garrettsworkshop/GW4302/Documentation/Architecture/BusGlue.png

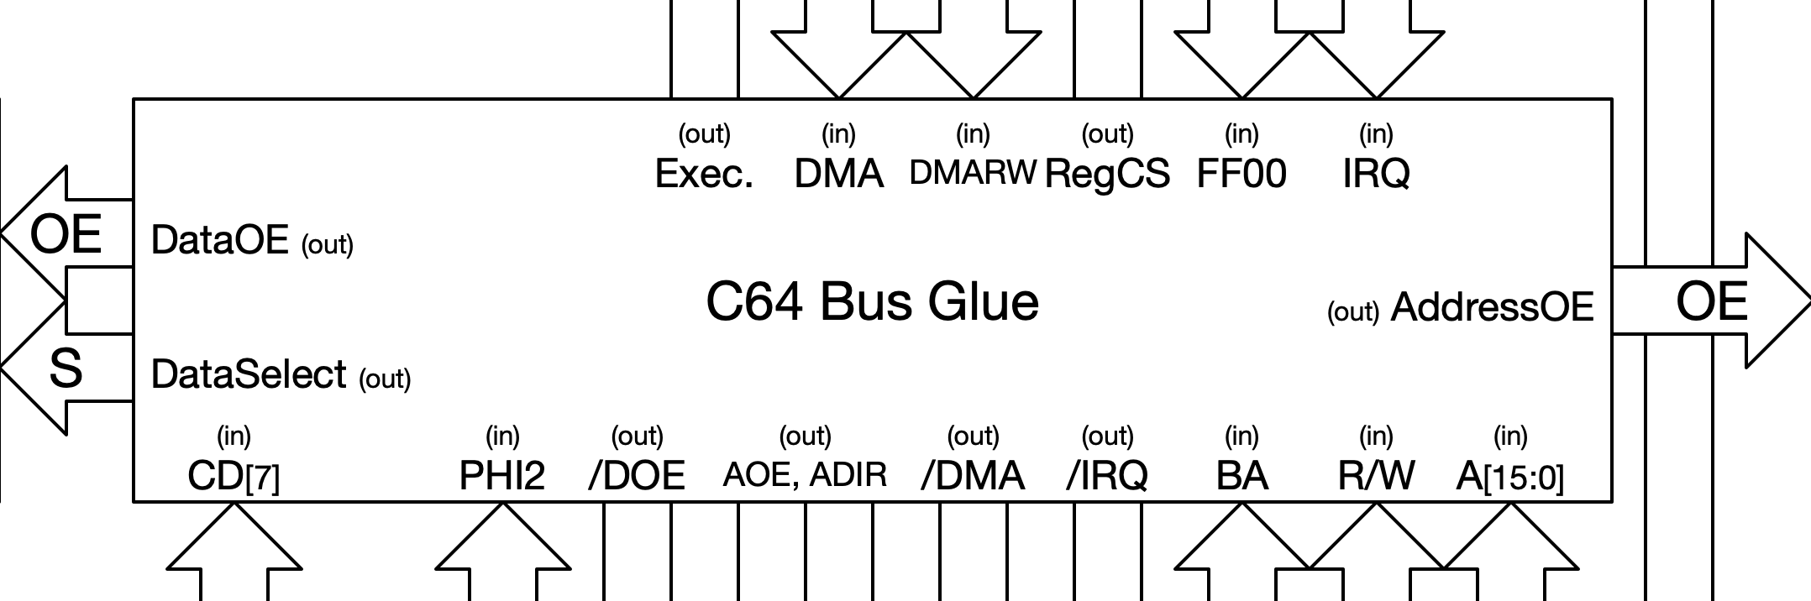
Documentation/Architecture/BusGlue.png
