garrettsworkshop/GW4302/Documentation/GW4302A-Placement.pdf

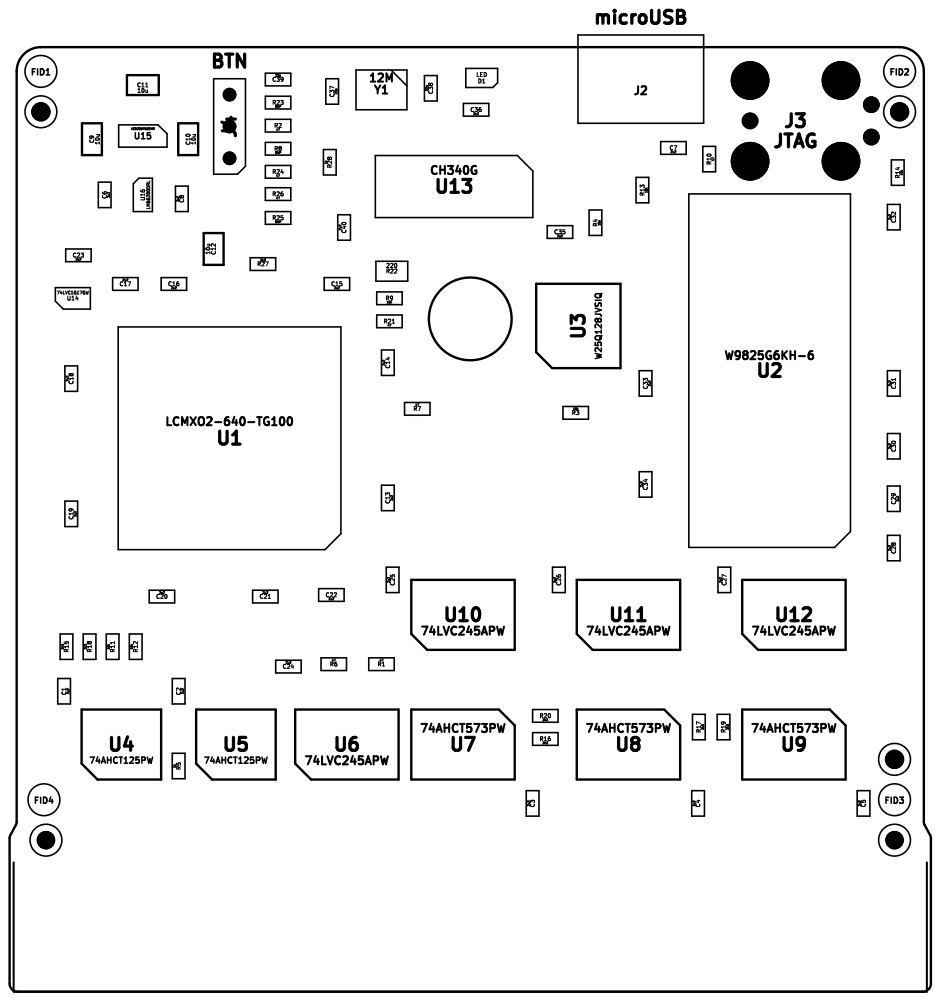
[picture p8: page 1]
