garrettsworkshop/GW4302/GW4302.kicad_pcb

## KiCad design GW4302.kicad_pcb (2025-01-10)

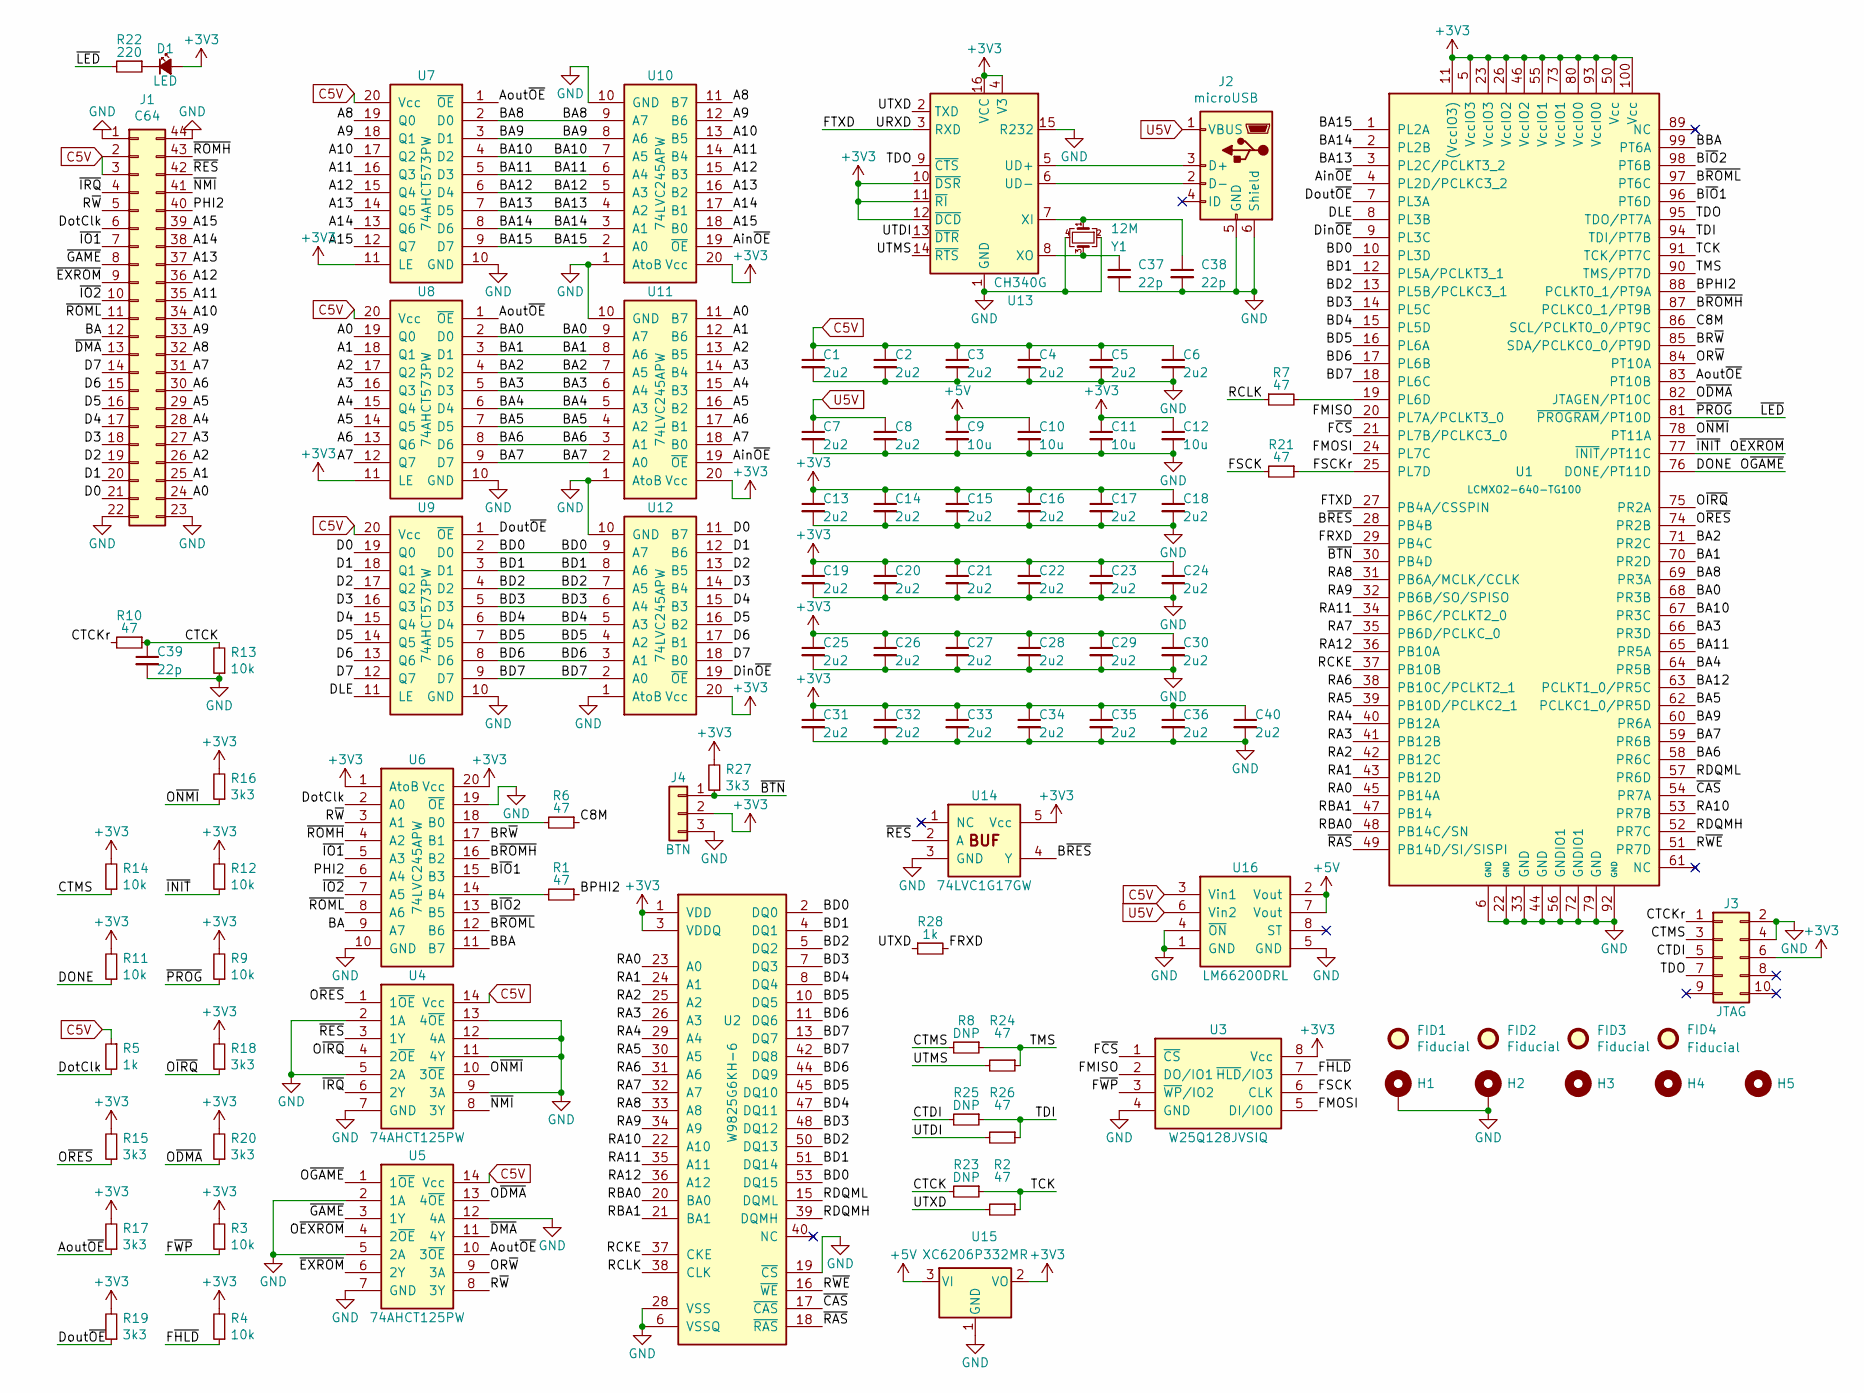
[picture p9: schematic GW4302.kicad_sch, GW4302A]

Parts:
C1, C2, C3, C4, C5, C6, C7, C8, C13, C14, C15, C16, C17, C18, C19, C20, C21, C22, C23, C24, C25, C26, C27, C28, C29, C30, C31, C32, C33, C34, C35, C36, C40: 2u2; C_0603; LCSC Part C23630
C9, C10, C11, C12: 10u; C_0805; LCSC Part C15850
C37, C38, C39: 22p; C_0603; LCSC Part C1653
D1: LED; LED_0805; LCSC Part C284932
FID1, FID2, FID3, FID4: Fiducial
H1, H2: PasteHole_1.1mm_PTH
H3, H4, H5: PasteHole_1.152mm_NPTH
J1: C64; AppleIIgsMemoryExpansion_Edge
J2: microUSB; USB_Micro-B_Amphenol_10118192-0001; LCSC Part C132564
J3: JTAG; Tag-Connect_TC2050-IDC-FP_2x05_P1.27mm_Vertical
J4: BTN; PinHeader_1x03_P2.00mm_Vertical
R1, R2, R6, R7, R10, R21, R24, R26: 47; R_0603; LCSC Part C23182
R3, R4, R9, R11, R12, R13, R14: 10k; R_0603; LCSC Part C25804
R5, R28: 1k; R_0603; LCSC Part C21190
R8, R23, R25: DNP; R_0603
R15, R16, R17, R18, R19, R20, R27: 3k3; R_0603; LCSC Part C22978
R22: 220; R_0805; LCSC Part C17557
U1: LCMXO2-640-TG100; TQFP-100_14x14mm_P0.5mm; LCSC Part C1521611
U2: W9825G6KH-6; TSOP-II-54_22.2x10.16mm_P0.8mm; LCSC Part C62246
U3: W25Q128JVSIQ; SOIC-8_5.3mm; LCSC Part C97521
U4, U5: 74AHCT125PW; TSSOP-14_4.4x5mm_P0.65mm; LCSC Part C36365
U6, U10, U11, U12: 74LVC245APW; TSSOP-20_4.4x6.5mm_P0.65mm; LCSC Part C7848
U7, U8, U9: 74AHCT573PW; TSSOP-20_4.4x6.5mm_P0.65mm; LCSC Part C141311
U13: CH340G; SOIC-16_3.9mm; LCSC Part C14267
U14: 74LVC1G17GW; SOT-353; LCSC Part C426705
U15: XC6206P332MR; SOT-23; LCSC Part C5446
U16: LM66200DRL; SOT-583; LCSC Part C3235556
Y1: 12M; Crystal_SMD_3225-4Pin_3.2x2.5mm; LCSC Part C9002

Connections:
+3V3: C11.1, C12.1, C13.1, C14.1, C15.1, C16.1, C17.1, C18.1, C19.1, C20.1, C21.1, C22.1, C23.1, C24.1, C25.1, C26.1, C27.1, C28.1, C29.1, C30.1, C31.1, C32.1, C33.1, C34.1, C35.1, C36.1, C40.1, D1.2 (A), J3.6, J4.2, R3.2, R4.2, R9.2, R11.2, R12.2, R14.2, R15.2, R16.2, R17.2, R18.2, R19.2, R20.2, R27.2, U1.5 (VccIO3), U1.11 ((VccIO3)), U1.23 (VccIO3), U1.26 (VccIO2), U1.46 (VccIO2), U1.50 (Vcc), U1.55 (VccIO1), U1.73 (VccIO1), U1.80 (VccIO0), U1.93 (VccIO0), U1.100 (Vcc), U2.1 (VDD), U2.3 (VDDQ), U2.9 (VDDQ), U2.14 (VDD), U2.27 (VDD), U2.43 (VDDQ), U2.49 (VDDQ), U3.8 (Vcc), U6.1 (AtoB), U6.20 (Vcc), U7.11 (LE), U8.11 (LE), U10.20 (Vcc), U11.20 (Vcc), U12.20 (Vcc), U13.4 (V3), U13.10 (~DSR), U13.11 (~RI), U13.12 (~DCD), U13.16 (VCC), U14.5 (Vcc), U15.2 (VO)
+5V: C9.1, C10.1, U15.3 (VI), U16.2 (Vout), U16.7 (Vout)
/A0: J1.24, U8.19 (Q0), U11.11 (B7)
/A1: J1.25, U8.18 (Q1), U11.12 (B6)
/A2: J1.26, U8.17 (Q2), U11.13 (B5)
/A3: J1.27, U8.16 (Q3), U11.14 (B4)
/A4: J1.28, U8.15 (Q4), U11.15 (B3)
/A5: J1.29, U8.14 (Q5), U11.16 (B2)
/A6: J1.30, U8.13 (Q6), U11.17 (B1)
/A7: J1.31, U8.12 (Q7), U11.18 (B0)
/A8: J1.32, U7.19 (Q0), U10.11 (B7)
/A9: J1.33, U7.18 (Q1), U10.12 (B6)
/A10: J1.34, U7.17 (Q2), U10.13 (B5)
/A11: J1.35, U7.16 (Q3), U10.14 (B4)
/A12: J1.36, U7.15 (Q4), U10.15 (B3)
/A13: J1.37, U7.14 (Q5), U10.16 (B2)
/A14: J1.38, U7.13 (Q6), U10.17 (B1)
/A15: J1.39, U7.12 (Q7), U10.18 (B0)
/Ain~OE: U1.4 (PL2D/PCLKC3_2), U10.19 (~OE), U11.19 (~OE)
/Aout~OE: R17.1, U1.83 (PT10B), U5.10 (3~OE), U7.1 (~OE), U8.1 (~OE)
/BA: J1.12, U6.9 (A7)
/BA0: U1.68 (PR3B), U8.2 (D0), U11.9 (A7)
/BA1: U1.70 (PR2D), U8.3 (D1), U11.8 (A6)
/BA2: U1.71 (PR2C), U8.4 (D2), U11.7 (A5)
/BA3: U1.66 (PR3D), U8.5 (D3), U11.6 (A4)
/BA4: U1.64 (PR5B), U8.6 (D4), U11.5 (A3)
/BA5: U1.62 (PCLKC1_0/PR5D), U8.7 (D5), U11.4 (A2)
/BA6: U1.58 (PR6C), U8.8 (D6), U11.3 (A1)
/BA7: U1.59 (PR6B), U8.9 (D7), U11.2 (A0)
/BA8: U1.69 (PR3A), U7.2 (D0), U10.9 (A7)
/BA9: U1.60 (PR6A), U7.3 (D1), U10.8 (A6)
/BA10: U1.67 (PR3C), U7.4 (D2), U10.7 (A5)
/BA11: U1.65 (PR5A), U7.5 (D3), U10.6 (A4)
/BA12: U1.63 (PCLKT1_0/PR5C), U7.6 (D4), U10.5 (A3)
/BA13: U1.3 (PL2C/PCLKT3_2), U7.7 (D5), U10.4 (A2)
/BA14: U1.2 (PL2B), U7.8 (D6), U10.3 (A1)
/BA15: U1.1 (PL2A), U7.9 (D7), U10.2 (A0)
/BBA: U1.99 (PT6A), U6.11 (B7)
/BD0: U1.10 (PL3D), U2.2 (DQ0), U2.53 (DQ15), U9.2 (D0), U12.9 (A7)
/BD1: U1.12 (PL5A/PCLKT3_1), U2.4 (DQ1), U2.51 (DQ14), U9.3 (D1), U12.8 (A6)
/BD2: U1.13 (PL5B/PCLKC3_1), U2.5 (DQ2), U2.50 (DQ13), U9.4 (D2), U12.7 (A5)
/BD3: U1.14 (PL5C), U2.7 (DQ3), U2.48 (DQ12), U9.5 (D3), U12.6 (A4)
/BD4: U1.15 (PL5D), U2.8 (DQ4), U2.47 (DQ11), U9.6 (D4), U12.5 (A3)
/BD5: U1.16 (PL6A), U2.10 (DQ5), U2.45 (DQ10), U9.7 (D5), U12.4 (A2)
/BD6: U1.17 (PL6B), U2.11 (DQ6), U2.44 (DQ9), U9.8 (D6), U12.3 (A1)
/BD7: U1.18 (PL6C), U2.13 (DQ7), U2.42 (DQ8), U9.9 (D7), U12.2 (A0)
/BPHI2: R1.1, U1.88 (PCLKT0_1/PT9A)
/BR~W: U1.85 (SDA/PCLKC0_0/PT9D), U6.17 (B1)
/B~IO1: U1.96 (PT6D), U6.15 (B3)
/B~IO2: U1.98 (PT6B), U6.13 (B5)
/B~RES: U1.28 (PB4B), U14.4 (Y)
/B~ROMH: U1.87 (PCLKC0_1/PT9B), U6.16 (B2)
/B~ROML: U1.97 (PT6C), U6.12 (B6)
/C8M: R6.1, U1.86 (SCL/PCLKT0_0/PT9C)
/CTCK: C39.1, R10.1, R13.2, R23.2
/CTCKr: J3.1, R10.2
/CTDI: J3.5, R25.2
/CTMS: J3.3, R8.2, R14.1
/D0: J1.21, U9.19 (Q0), U12.11 (B7)
/D1: J1.20, U9.18 (Q1), U12.12 (B6)
/D2: J1.19, U9.17 (Q2), U12.13 (B5)
/D3: J1.18, U9.16 (Q3), U12.14 (B4)
/D4: J1.17, U9.15 (Q4), U12.15 (B3)
/D5: J1.16, U9.14 (Q5), U12.16 (B2)
/D6: J1.15, U9.13 (Q6), U12.17 (B1)
/D7: J1.14, U9.12 (Q7), U12.18 (B0)
/DLE: U1.8 (PL3B), U9.11 (LE)
/DONE: R11.1, U1.76 (DONE/PT11D), U5.1 (1~OE)
/Din~OE: U1.9 (PL3C), U12.19 (~OE)
/DotClk: J1.6, R5.2, U6.2 (A0)
/Dout~OE: R19.1, U1.7 (PL3A), U9.1 (~OE)
/FMISO: U1.20 (PL7A/PCLKT3_0), U3.2 (DO/IO1)
/FMOSI: U1.24 (PL7C), U3.5 (DI/IO0)
/FRXD: R28.2, U1.29 (PB4C)
/FSCK: R21.2, U3.6 (CLK)
/FSCKr: R21.1, U1.25 (PL7D)
/FTXD: U1.27 (PB4A/CSSPIN), U13.3 (RXD)
/F~CS: U1.21 (PL7B/PCLKC3_0), U3.1 (~CS)
/F~HLD: R4.1, U3.7 (~HLD/IO3)
/F~WP: R3.1, U3.3 (~WP/IO2)
/OR~W: U1.84 (PT10A), U5.9 (3A)
/O~DMA: R20.1, U1.82 (JTAGEN/PT10C), U5.13 (4~OE)
/O~EXROM: R12.1, U1.77 (~INIT/PT11C), U5.4 (2~OE)
/O~IRQ: R18.1, U1.75 (PR2A), U4.4 (2~OE)
/O~NMI: R16.1, U1.78 (PT11A), U4.10 (3~OE)
/O~RES: R15.1, U1.74 (PR2B), U4.1 (1~OE)
/PHI2: J1.40, U6.6 (A4)
/RA0: U1.45 (PB14A), U2.23 (A0)
/RA1: U1.43 (PB12D), U2.24 (A1)
/RA2: U1.42 (PB12C), U2.25 (A2)
/RA3: U1.41 (PB12B), U2.26 (A3)
/RA4: U1.40 (PB12A), U2.29 (A4)
/RA5: U1.39 (PB10D/PCLKC2_1), U2.30 (A5)
/RA6: U1.38 (PB10C/PCLKT2_1), U2.31 (A6)
/RA7: U1.35 (PB6D/PCLKC_0), U2.32 (A7)
/RA8: U1.31 (PB6A/MCLK/CCLK), U2.33 (A8)
/RA9: U1.32 (PB6B/SO/SPISO), U2.34 (A9)
/RA10: U1.53 (PR7B), U2.22 (A10)
/RA11: U1.34 (PB6C/PCLKT2_0), U2.35 (A11)
/RA12: U1.36 (PB10A), U2.36 (A12)
/RBA0: U1.48 (PB14C/SN), U2.20 (BA0)
/RBA1: U1.47 (PB14), U2.21 (BA1)
/RCKE: U1.37 (PB10B), U2.37 (CKE)
/RCLK: R7.1, U2.38 (CLK)
/RDQMH: U1.52 (PR7C), U2.39 (DQMH)
/RDQML: U1.57 (PR6D), U2.15 (DQML)
/R~WE: U1.51 (PR7D), U2.16 (~WE)
/R~W: J1.5, U5.8 (3Y), U6.3 (A1)
/TCK: R2.1, R23.1, U1.91 (TCK/PT7C)
/TDI: R25.1, R26.1, U1.94 (TDI/PT7B)
/TDO: J3.7, U1.95 (TDO/PT7A), U13.9 (~CTS)
/TMS: R8.1, R24.1, U1.90 (TMS/PT7D)
/UTDI: R26.2, U13.13 (~DTR)
/UTMS: R24.2, U13.14 (~RTS)
/UTXD: R2.2, R28.1, U13.2 (TXD)
/~BTN: J4.1, R27.1, U1.30 (PB4D)
/~CAS: U1.54 (PR7A), U2.17 (~CAS)
/~DMA: J1.13, U5.11 (4Y)
/~EXROM: J1.9, U5.6 (2Y)
/~GAME: J1.8, U5.3 (1Y)
/~IO1: J1.7, U6.5 (A3)
/~IO2: J1.10, U6.7 (A5)
/~IRQ: J1.4, U4.6 (2Y)
/~LED: R9.1, R22.2, U1.81 (~PROGRAM/PT10D)
/~NMI: J1.41, U4.8 (3Y)
/~RAS: U1.49 (PB14D/SI/SISPI), U2.18 (~RAS)
/~RES: J1.42, U4.3 (1Y), U14.2 (A)
/~ROMH: J1.43, U6.4 (A2)
/~ROML: J1.11, U6.8 (A6)
C5V: C1.1, C2.1, C3.1, C4.1, C5.1, C6.1, J1.2, J1.3, R5.1, U4.14 (Vcc), U5.14 (Vcc), U7.20 (Vcc), U8.20 (Vcc), U9.20 (Vcc), U16.3 (Vin1)
GND: C1.2, C2.2, C3.2, C4.2, C5.2, C6.2, C7.2, C8.2, C9.2, C10.2, C11.2, C12.2, C13.2, C14.2, C15.2, C16.2, C17.2, C18.2, C19.2, C20.2, C21.2, C22.2, C23.2, C24.2, C25.2, C26.2, C27.2, C28.2, C29.2, C30.2, C31.2, C32.2, C33.2, C34.2, C35.2, C36.2, C37.2, C38.2, C39.2, C40.2, H1.1, H2.1, J1.1, J1.22, J1.23, J1.44, J2.5 (GND), J2.6 (Shield), J3.2, J3.4, J4.3, R13.1, U1.6 (GND), U1.22 (GND), U1.33 (GND), U1.44 (GND), U1.56 (GNDIO1), U1.72 (GNDIO1), U1.79 (GND), U1.92 (GND), U2.6 (VSSQ), U2.12 (VSSQ), U2.19 (~CS), U2.28 (VSS), U2.41 (VSS), U2.46 (VSSQ), U2.52 (VSSQ), U2.54 (VSS), U3.4 (GND), U4.2 (1A), U4.5 (2A), U4.7 (GND), U4.9 (3A), U4.11 (4Y), U4.12 (4A), U4.13 (4~OE), U5.2 (1A), U5.5 (2A), U5.7 (GND), U5.12 (4A), U6.10 (GND), U6.19 (~OE), U7.10 (GND), U8.10 (GND), U9.10 (GND), U10.1 (AtoB), U10.10 (GND), U11.1 (AtoB), U11.10 (GND), U12.1 (AtoB), U12.10 (GND), U13.1 (GND), U13.15 (R232), U14.3 (GND), U15.1 (GND), U16.1 (GND), U16.4 (~ON), U16.5 (GND), Y1.2, Y1.4
unnamed: D1.1 (K), R22.1
unnamed: J2.3 (D+), U13.5 (UD+)
unnamed: J2.2 (D-), U13.6 (UD-)
unnamed: R7.2, U1.19 (PL6D)
unnamed: R6.2, U6.18 (B0)
unnamed: R1.2, U6.14 (B4)
unnamed: C38.1, U13.7 (XI), Y1.1
unnamed: C37.1, U13.8 (XO), Y1.3
U5V: C7.1, C8.1, J2.1 (VBUS), U16.6 (Vin2)

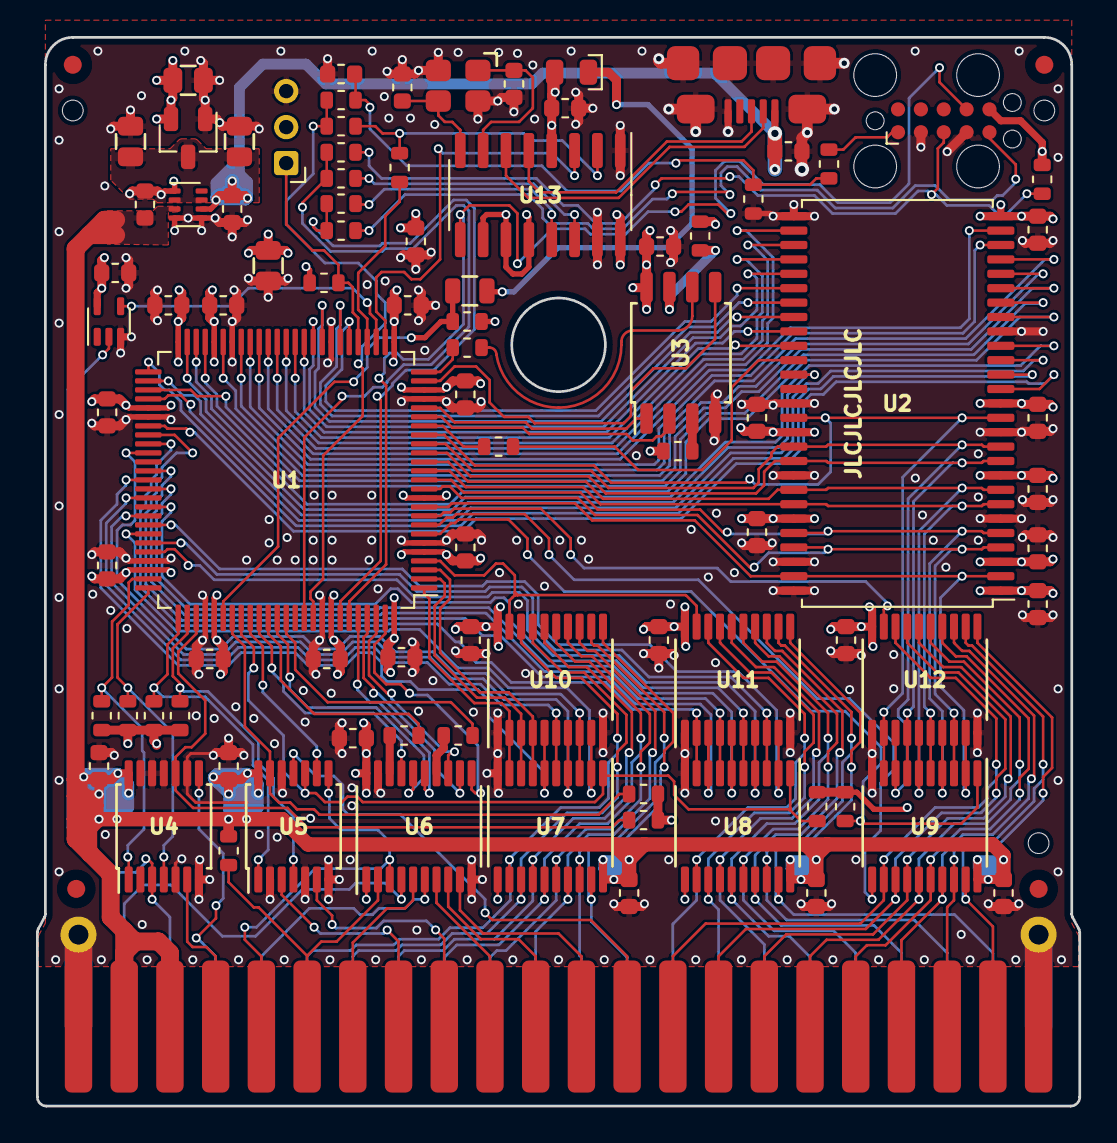
[picture p10: board GW4302.kicad_pcb from above]

Board: 4 copper layers, 57.9 x 59.4 mm, 99 parts (1 on the bottom side), 140 nets.
