garrettsworkshop/GW4302/cpld/impl1/REU_prim.v

// Verilog netlist produced by program LSE :  version Diamond (64-bit) 3.12.1.454
// Netlist written on Fri Sep 02 04:48:19 2022
//
// Verilog Description of module REU
//

module REU (C8M, PHI2, nRESET, BA, D, A, nWE, nWEDMA, nDMA, 
            nIRQ, nIO1, nIO2, nAOE, ADIR, nRWOE, nDOE, DDIR, 
            RCLK, nCS, nRAS, nCAS, nRWE, CKE, RBA, RA, DQMH, 
            DQML, RD) /* synthesis syn_module_defined=1 */ ;   // c:/users/garre/repos/gw4302/cpld/reu.v(1[8:11])
    input C8M;   // c:/users/garre/repos/gw4302/cpld/reu.v(3[8:11])
    input PHI2;   // c:/users/garre/repos/gw4302/cpld/reu.v(4[8:12])
    input nRESET;   // c:/users/garre/repos/gw4302/cpld/reu.v(5[8:14])
    input BA;   // c:/users/garre/repos/gw4302/cpld/reu.v(7[8:10])
    inout [7:0]D;   // c:/users/garre/repos/gw4302/cpld/reu.v(8[14:15])
    inout [15:0]A;   // c:/users/garre/repos/gw4302/cpld/reu.v(9[15:16])
    input nWE;   // c:/users/garre/repos/gw4302/cpld/reu.v(10[8:11])
    output nWEDMA;   // c:/users/garre/repos/gw4302/cpld/reu.v(11[9:15])
    output nDMA;   // c:/users/garre/repos/gw4302/cpld/reu.v(12[9:13])
    output nIRQ;   // c:/users/garre/repos/gw4302/cpld/reu.v(13[9:13])
    input nIO1;   // c:/users/garre/repos/gw4302/cpld/reu.v(14[8:12])
    input nIO2;   // c:/users/garre/repos/gw4302/cpld/reu.v(15[8:12])
    output nAOE;   // c:/users/garre/repos/gw4302/cpld/reu.v(17[9:13])
    output ADIR;   // c:/users/garre/repos/gw4302/cpld/reu.v(18[9:13])
    output nRWOE;   // c:/users/garre/repos/gw4302/cpld/reu.v(19[9:14])
    output nDOE;   // c:/users/garre/repos/gw4302/cpld/reu.v(20[9:13])
    output DDIR;   // c:/users/garre/repos/gw4302/cpld/reu.v(21[9:13])
    output RCLK;   // c:/users/garre/repos/gw4302/cpld/reu.v(23[9:13])
    output nCS;   // c:/users/garre/repos/gw4302/cpld/reu.v(24[9:12])
    output nRAS;   // c:/users/garre/repos/gw4302/cpld/reu.v(25[9:13])
    output nCAS;   // c:/users/garre/repos/gw4302/cpld/reu.v(26[9:13])
    output nRWE;   // c:/users/garre/repos/gw4302/cpld/reu.v(27[9:13])
    output CKE;   // c:/users/garre/repos/gw4302/cpld/reu.v(28[9:12])
    output [1:0]RBA;   // c:/users/garre/repos/gw4302/cpld/reu.v(29[15:18])
    output [12:0]RA;   // c:/users/garre/repos/gw4302/cpld/reu.v(30[16:18])
    output DQMH;   // c:/users/garre/repos/gw4302/cpld/reu.v(31[9:13])
    output DQML;   // c:/users/garre/repos/gw4302/cpld/reu.v(32[9:13])
    inout [7:0]RD;   // c:/users/garre/repos/gw4302/cpld/reu.v(33[14:16])
    
    wire C8M_c /* synthesis is_clock=1 */ ;   // c:/users/garre/repos/gw4302/cpld/reu.v(3[8:11])
    wire PHI2_c /* synthesis is_clock=1 */ ;   // c:/users/garre/repos/gw4302/cpld/reu.v(4[8:12])
    wire C8M_N_46 /* synthesis is_inv_clock=1 */ ;   // c:/users/garre/repos/gw4302/cpld/ram.v(36[11:16])
    wire PHI2_N_571 /* synthesis is_inv_clock=1 */ ;   // c:/users/garre/repos/gw4302/cpld/dmaseq.v(103[11:18])
    
    wire GND_net, VCC_net, nRESET_c, BA_c, nWE_c, nWEDMA_c, nIRQ_c, 
        nIO2_c, DDIR_c, RCLK_c, nCS_c, nRAS_c, nCAS_c, nRWE_c, 
        CKE_c, RBA_c_1, RBA_c_0, RA_0_11, RA_0_10, RA_0_9, RA_0_8, 
        RA_0_7, RA_0_6, RA_0_5, RA_0_4, RA_0_3, RA_0_2, RA_0_1, 
        RA_0_0, DQMH_c, DQML_c, Execute;
    wire [1:0]XferType;   // c:/users/garre/repos/gw4302/cpld/reu.v(38[13:21])
    wire [23:0]REUA;   // c:/users/garre/repos/gw4302/cpld/reu.v(39[14:18])
    wire [15:0]CA;   // c:/users/garre/repos/gw4302/cpld/reu.v(40[14:16])
    wire [7:0]RAMRDD;   // c:/users/garre/repos/gw4302/cpld/reu.v(45[13:19])
    
    wire DMA, RAMRD, RAMWR, RegReset, IncREUA, SetFault;
    wire [7:0]Dout;   // c:/users/garre/repos/gw4302/cpld/reu.v(101[13:17])
    
    wire DOE, nWEDMA_N_5, nAOE_N_8, nRWOE_N_10, nDOE_N_12;
    wire [7:0]WRDr;   // c:/users/garre/repos/gw4302/cpld/ram.v(240[11:15])
    
    wire A_0__N_97, EndBlock, ExecuteEN, AutoloadEN, FF00DecodeEN, 
        n3622, n3637, n3625, n3621, n3636, CAOut_7__N_282, n434, 
        n433, n3487, n3634, n3276, CAOut_15__N_237, n432, n430, 
        n8, REUAOut_7__N_194, n3633, n3315, n3624, REUAOut_15__N_149, 
        n3632, n34, n33, n32, n30, n28, n3481, XferC64REU, DMAr;
    wire [2:1]nRESETr;   // c:/users/garre/repos/gw4302/cpld/dmaseq.v(103[11:18])
    
    wire n3913, XferEnd_N_600, IncCA_N_631, Length1_N_645, n3813, 
        n22, n6, n7, D_out_7, n3652, n3650, n3649, D_out_6, 
        D_out_5, D_out_4, D_out_3, D_out_2, D_out_1, D_out_0, A_out_15, 
        A_out_14, A_out_13, A_out_12, A_out_11, A_out_10, A_out_9, 
        A_out_8, A_out_4, A_out_3, A_out_2, A_out_1, A_out_0, RD_out_7, 
        RD_out_6, RD_out_5, n1103, RD_out_4, RD_out_3, RD_out_2, 
        RD_out_1, RD_out_0, n3629, n3644, n2784, n3643, n3911, 
        n3912, n2076, n2783, n3914, n3640, n3639, n3638;
    
    VHI i2 (.Z(VCC_net));
    INV i3465 (.A(C8M_c), .Z(C8M_N_46));   // c:/users/garre/repos/gw4302/cpld/reu.v(3[8:11])
    LUT4 i2045_2_lut_rep_84 (.A(DMA), .B(nIO2_c), .Z(n3649)) /* synthesis lut_function=(A+(B)) */ ;
    defparam i2045_2_lut_rep_84.init = 16'heeee;
    BB A_pad_11 (.I(CA[11]), .T(n3652), .B(A[11]), .O(A_out_11));   // c:/users/garre/repos/gw4302/cpld/reu.v(95[9:10])
    LUT4 RegReset_I_0_4_lut_4_lut_rep_102 (.A(DMA), .B(DMAr), .C(nRESETr[2]), 
         .D(nRESETr[1]), .Z(n3913)) /* synthesis lut_function=(!(A+(B (C (D))+!B (D)))) */ ;   // c:/users/garre/repos/gw4302/cpld/reu.v(95[9:10])
    defparam RegReset_I_0_4_lut_4_lut_rep_102.init = 16'h0455;
    LUT4 m1_lut (.Z(n3911)) /* synthesis lut_function=1, syn_instantiated=1 */ ;
    defparam m1_lut.init = 16'hffff;
    BB A_pad_12 (.I(CA[12]), .T(n3652), .B(A[12]), .O(A_out_12));   // c:/users/garre/repos/gw4302/cpld/reu.v(95[9:10])
    BB A_pad_13 (.I(CA[13]), .T(n3652), .B(A[13]), .O(A_out_13));   // c:/users/garre/repos/gw4302/cpld/reu.v(95[9:10])
    BB A_pad_14 (.I(CA[14]), .T(n3652), .B(A[14]), .O(A_out_14));   // c:/users/garre/repos/gw4302/cpld/reu.v(95[9:10])
    BB A_pad_15 (.I(CA[15]), .T(n3652), .B(A[15]), .O(A_out_15));   // c:/users/garre/repos/gw4302/cpld/reu.v(95[9:10])
    BB D_pad_0 (.I(Dout[0]), .T(DOE), .B(D[0]), .O(D_out_0));   // c:/users/garre/repos/gw4302/cpld/reu.v(102[9:10])
    BB D_pad_7 (.I(Dout[7]), .T(DOE), .B(D[7]), .O(D_out_7));   // c:/users/garre/repos/gw4302/cpld/reu.v(102[9:10])
    BB D_pad_1 (.I(Dout[1]), .T(DOE), .B(D[1]), .O(D_out_1));   // c:/users/garre/repos/gw4302/cpld/reu.v(102[9:10])
    BB D_pad_2 (.I(Dout[2]), .T(DOE), .B(D[2]), .O(D_out_2));   // c:/users/garre/repos/gw4302/cpld/reu.v(102[9:10])
    BB D_pad_3 (.I(Dout[3]), .T(DOE), .B(D[3]), .O(D_out_3));   // c:/users/garre/repos/gw4302/cpld/reu.v(102[9:10])
    BB D_pad_4 (.I(Dout[4]), .T(DOE), .B(D[4]), .O(D_out_4));   // c:/users/garre/repos/gw4302/cpld/reu.v(102[9:10])
    LUT4 i15_4_lut (.A(ExecuteEN), .B(n30), .C(n22), .D(A_out_9), .Z(n33)) /* synthesis lut_function=(A (B (C (D)))) */ ;
    defparam i15_4_lut.init = 16'h8000;
    BB D_pad_5 (.I(Dout[5]), .T(DOE), .B(D[5]), .O(D_out_5));   // c:/users/garre/repos/gw4302/cpld/reu.v(102[9:10])
    BB D_pad_6 (.I(Dout[6]), .T(DOE), .B(D[6]), .O(D_out_6));   // c:/users/garre/repos/gw4302/cpld/reu.v(102[9:10])
    LUT4 i16_4_lut (.A(A_out_11), .B(n32), .C(n3276), .D(FF00DecodeEN), 
         .Z(n34)) /* synthesis lut_function=(!(((C+!(D))+!B)+!A)) */ ;
    defparam i16_4_lut.init = 16'h0800;
    LUT4 i12_4_lut (.A(A_out_10), .B(A_out_8), .C(A_out_15), .D(nWE_c), 
         .Z(n30)) /* synthesis lut_function=(!((((D)+!C)+!B)+!A)) */ ;
    defparam i12_4_lut.init = 16'h0080;
    LUT4 i14_3_lut (.A(A_out_3), .B(n28), .C(n6), .Z(n32)) /* synthesis lut_function=(!(A+((C)+!B))) */ ;
    defparam i14_3_lut.init = 16'h0404;
    LUT4 i10_4_lut (.A(n8), .B(A_out_14), .C(A_out_1), .D(A_out_12), 
         .Z(n28)) /* synthesis lut_function=(!(A+((C+!(D))+!B))) */ ;
    defparam i10_4_lut.init = 16'h0400;
    LUT4 RegRDD_7__I_0_i8_4_lut (.A(n430), .B(RAMRDD[7]), .C(DMA), .D(n2076), 
         .Z(Dout[7])) /* synthesis lut_function=(A (B+!(C))+!A (B (C+(D))+!B !(C+!(D)))) */ ;   // c:/users/garre/repos/gw4302/cpld/reu.v(101[20:51])
    defparam RegRDD_7__I_0_i8_4_lut.init = 16'hcfca;
    LUT4 i2110_2_lut_rep_74_3_lut_4_lut (.A(n3649), .B(nWE_c), .C(n3650), 
         .D(A_out_3), .Z(n3639)) /* synthesis lut_function=(A+(B+(C+(D)))) */ ;
    defparam i2110_2_lut_rep_74_3_lut_4_lut.init = 16'hfffe;
    LUT4 i2_3_lut_rep_75_4_lut (.A(n3649), .B(nWE_c), .C(n3650), .D(A_out_3), 
         .Z(n3640)) /* synthesis lut_function=(A+(B+(C+!(D)))) */ ;
    defparam i2_3_lut_rep_75_4_lut.init = 16'hfeff;
    BB A_pad_10 (.I(CA[10]), .T(n3652), .B(A[10]), .O(A_out_10));   // c:/users/garre/repos/gw4302/cpld/reu.v(95[9:10])
    LUT4 i3171_3_lut (.A(PHI2_c), .B(BA_c), .C(DMA), .Z(nRWOE_N_10)) /* synthesis lut_function=(!(A (B (C)))) */ ;   // c:/users/garre/repos/gw4302/cpld/reu.v(94[17:37])
    defparam i3171_3_lut.init = 16'h7f7f;
    LUT4 i3174_4_lut (.A(PHI2_c), .B(nIO2_c), .C(BA_c), .D(DMA), .Z(nDOE_N_12)) /* synthesis lut_function=(!(A (B (C (D))+!B (C+!(D))))) */ ;   // c:/users/garre/repos/gw4302/cpld/reu.v(100[16:45])
    defparam i3174_4_lut.init = 16'h5fdd;
    LUT4 nWE_N_3_I_0_3_lut (.A(nWE_c), .B(nWEDMA_c), .C(DMA), .Z(DDIR_c)) /* synthesis lut_function=(A (B (C))+!A (B+!(C))) */ ;   // c:/users/garre/repos/gw4302/cpld/reu.v(99[16:35])
    defparam nWE_N_3_I_0_3_lut.init = 16'hc5c5;
    LUT4 RegRDD_7__I_0_i2_4_lut (.A(n3481), .B(RAMRDD[1]), .C(DMA), .D(n2076), 
         .Z(Dout[1])) /* synthesis lut_function=(A (B+!(C))+!A (B (C+(D))+!B !(C+!(D)))) */ ;   // c:/users/garre/repos/gw4302/cpld/reu.v(101[20:51])
    defparam RegRDD_7__I_0_i2_4_lut.init = 16'hcfca;
    GSR GSR_INST (.GSR(VCC_net));
    LUT4 RegRDD_7__I_0_i4_4_lut (.A(n434), .B(RAMRDD[3]), .C(DMA), .D(n2076), 
         .Z(Dout[3])) /* synthesis lut_function=(A (B+!(C))+!A (B (C+(D))+!B !(C+!(D)))) */ ;   // c:/users/garre/repos/gw4302/cpld/reu.v(101[20:51])
    defparam RegRDD_7__I_0_i4_4_lut.init = 16'hcfca;
    LUT4 RegRDD_7__I_0_i5_4_lut (.A(n433), .B(RAMRDD[4]), .C(DMA), .D(n2076), 
         .Z(Dout[4])) /* synthesis lut_function=(A (B+!(C))+!A (B (C+(D))+!B !(C+!(D)))) */ ;   // c:/users/garre/repos/gw4302/cpld/reu.v(101[20:51])
    defparam RegRDD_7__I_0_i5_4_lut.init = 16'hcfca;
    LUT4 i2047_2_lut_rep_78_3_lut (.A(DMA), .B(nIO2_c), .C(nWE_c), .Z(n3643)) /* synthesis lut_function=(A+(B+(C))) */ ;
    defparam i2047_2_lut_rep_78_3_lut.init = 16'hfefe;
    REUReg reureg (.GND_net(GND_net), .REUAOut_15__N_149(REUAOut_15__N_149), 
           .REUA({REUA}), .n3639(n3639), .D_out_7(D_out_7), .D_out_4(D_out_4), 
           .A_out_1(A_out_1), .AutoloadEN(AutoloadEN), .PHI2_N_571(PHI2_N_571), 
           .n3913(n3913), .D_out_5(D_out_5), .A_out_0(A_out_0), .n432(n432), 
           .A_out_2(A_out_2), .n433(n433), .D_out_3(D_out_3), .n434(n434), 
           .n3912(n3912), .XferEnd_N_600(XferEnd_N_600), .DMA(DMA), .n3914(n3914), 
           .D_out_1(D_out_1), .\XferType[0] (XferType[0]), .XferC64REU(XferC64REU), 
           .n3625(n3625), .D_out_6(D_out_6), .D_out_2(D_out_2), .CA({CA}), 
           .D_out_0(D_out_0), .EndBlock(EndBlock), .n3624(n3624), .n3637(n3637), 
           .A_out_3(A_out_3), .A_0__N_97(A_0__N_97), .n3629(n3629), .SetFault(SetFault), 
           .n3911(n3911), .n3643(n3643), .A_out_4(A_out_4), .FF00DecodeEN(FF00DecodeEN), 
           .n33(n33), .n34(n34), .Execute(Execute), .n3640(n3640), .IncCA_N_631(IncCA_N_631), 
           .n3315(n3315), .n2076(n2076), .n3644(n3644), .n430(n430), 
           .n3650(n3650), .n3632(n3632), .n3634(n3634), .n3636(n3636), 
           .Length1_N_645(Length1_N_645), .\RAMRDD[2] (RAMRDD[2]), .\Dout[2] (Dout[2]), 
           .ExecuteEN(ExecuteEN), .nIRQ_c(nIRQ_c), .n3638(n3638), .n3487(n3487), 
           .IncREUA(IncREUA), .RegReset(RegReset), .n3481(n3481), .n7(n7), 
           .n3276(n3276), .n3633(n3633), .n3622(n3622), .A_out_13(A_out_13), 
           .n22(n22), .n3621(n3621), .n3813(n3813), .REUAOut_7__N_194(REUAOut_7__N_194), 
           .CAOut_15__N_237(CAOut_15__N_237), .CAOut_7__N_282(CAOut_7__N_282), 
           .RAMWR(RAMWR)) /* synthesis syn_module_defined=1 */ ;   // c:/users/garre/repos/gw4302/cpld/reu.v(67[9] 76[62])
    BB A_pad_9 (.I(CA[9]), .T(n3652), .B(A[9]), .O(A_out_9));   // c:/users/garre/repos/gw4302/cpld/reu.v(95[9:10])
    BB A_pad_8 (.I(CA[8]), .T(n3652), .B(A[8]), .O(A_out_8));   // c:/users/garre/repos/gw4302/cpld/reu.v(95[9:10])
    BB A_pad_7 (.I(CA[7]), .T(n3652), .B(A[7]), .O(n8));   // c:/users/garre/repos/gw4302/cpld/reu.v(95[9:10])
    BB A_pad_6 (.I(CA[6]), .T(n3652), .B(A[6]), .O(n7));   // c:/users/garre/repos/gw4302/cpld/reu.v(95[9:10])
    BB A_pad_5 (.I(CA[5]), .T(n3652), .B(A[5]), .O(n6));   // c:/users/garre/repos/gw4302/cpld/reu.v(95[9:10])
    BB A_pad_4 (.I(CA[4]), .T(n3652), .B(A[4]), .O(A_out_4));   // c:/users/garre/repos/gw4302/cpld/reu.v(95[9:10])
    BB A_pad_3 (.I(CA[3]), .T(n3652), .B(A[3]), .O(A_out_3));   // c:/users/garre/repos/gw4302/cpld/reu.v(95[9:10])
    BB A_pad_2 (.I(CA[2]), .T(n3652), .B(A[2]), .O(A_out_2));   // c:/users/garre/repos/gw4302/cpld/reu.v(95[9:10])
    BB A_pad_1 (.I(CA[1]), .T(n3652), .B(A[1]), .O(A_out_1));   // c:/users/garre/repos/gw4302/cpld/reu.v(95[9:10])
    BB A_pad_0 (.I(CA[0]), .T(n3652), .B(A[0]), .O(A_out_0));   // c:/users/garre/repos/gw4302/cpld/reu.v(95[9:10])
    BB RD_pad_7 (.I(WRDr[7]), .T(n1103), .B(RD[7]), .O(RD_out_7));   // c:/users/garre/repos/gw4302/cpld/ram.v(250[8:10])
    BB RD_pad_6 (.I(WRDr[6]), .T(n1103), .B(RD[6]), .O(RD_out_6));   // c:/users/garre/repos/gw4302/cpld/ram.v(250[8:10])
    BB RD_pad_5 (.I(WRDr[5]), .T(n1103), .B(RD[5]), .O(RD_out_5));   // c:/users/garre/repos/gw4302/cpld/ram.v(250[8:10])
    BB RD_pad_4 (.I(WRDr[4]), .T(n1103), .B(RD[4]), .O(RD_out_4));   // c:/users/garre/repos/gw4302/cpld/ram.v(250[8:10])
    BB RD_pad_3 (.I(WRDr[3]), .T(n1103), .B(RD[3]), .O(RD_out_3));   // c:/users/garre/repos/gw4302/cpld/ram.v(250[8:10])
    BB RD_pad_2 (.I(WRDr[2]), .T(n1103), .B(RD[2]), .O(RD_out_2));   // c:/users/garre/repos/gw4302/cpld/ram.v(250[8:10])
    BB RD_pad_1 (.I(WRDr[1]), .T(n1103), .B(RD[1]), .O(RD_out_1));   // c:/users/garre/repos/gw4302/cpld/ram.v(250[8:10])
    BB RD_pad_0 (.I(WRDr[0]), .T(n1103), .B(RD[0]), .O(RD_out_0));   // c:/users/garre/repos/gw4302/cpld/ram.v(250[8:10])
    OB nWEDMA_pad (.I(nWEDMA_c), .O(nWEDMA));   // c:/users/garre/repos/gw4302/cpld/reu.v(11[9:15])
    OB nDMA_pad (.I(n3652), .O(nDMA));   // c:/users/garre/repos/gw4302/cpld/reu.v(12[9:13])
    OB nIRQ_pad (.I(nIRQ_c), .O(nIRQ));   // c:/users/garre/repos/gw4302/cpld/reu.v(13[9:13])
    OB nAOE_pad (.I(nAOE_N_8), .O(nAOE));   // c:/users/garre/repos/gw4302/cpld/reu.v(17[9:13])
    OB ADIR_pad (.I(n3652), .O(ADIR));   // c:/users/garre/repos/gw4302/cpld/reu.v(18[9:13])
    OB nRWOE_pad (.I(nRWOE_N_10), .O(nRWOE));   // c:/users/garre/repos/gw4302/cpld/reu.v(19[9:14])
    OB nDOE_pad (.I(nDOE_N_12), .O(nDOE));   // c:/users/garre/repos/gw4302/cpld/reu.v(20[9:13])
    OB DDIR_pad (.I(DDIR_c), .O(DDIR));   // c:/users/garre/repos/gw4302/cpld/reu.v(21[9:13])
    OB RCLK_pad (.I(RCLK_c), .O(RCLK));   // c:/users/garre/repos/gw4302/cpld/reu.v(23[9:13])
    OB nCS_pad (.I(nCS_c), .O(nCS));   // c:/users/garre/repos/gw4302/cpld/reu.v(24[9:12])
    OB nRAS_pad (.I(nRAS_c), .O(nRAS));   // c:/users/garre/repos/gw4302/cpld/reu.v(25[9:13])
    OB nCAS_pad (.I(nCAS_c), .O(nCAS));   // c:/users/garre/repos/gw4302/cpld/reu.v(26[9:13])
    OB nRWE_pad (.I(nRWE_c), .O(nRWE));   // c:/users/garre/repos/gw4302/cpld/reu.v(27[9:13])
    OB CKE_pad (.I(CKE_c), .O(CKE));   // c:/users/garre/repos/gw4302/cpld/reu.v(28[9:12])
    OB RBA_pad_1 (.I(RBA_c_1), .O(RBA[1]));   // c:/users/garre/repos/gw4302/cpld/reu.v(29[15:18])
    OB RBA_pad_0 (.I(RBA_c_0), .O(RBA[0]));   // c:/users/garre/repos/gw4302/cpld/reu.v(29[15:18])
    OB RA_pad_12 (.I(GND_net), .O(RA[12]));   // c:/users/garre/repos/gw4302/cpld/reu.v(30[16:18])
    OB RA_pad_11 (.I(RA_0_11), .O(RA[11]));   // c:/users/garre/repos/gw4302/cpld/reu.v(30[16:18])
    OB RA_pad_10 (.I(RA_0_10), .O(RA[10]));   // c:/users/garre/repos/gw4302/cpld/reu.v(30[16:18])
    OB RA_pad_9 (.I(RA_0_9), .O(RA[9]));   // c:/users/garre/repos/gw4302/cpld/reu.v(30[16:18])
    OB RA_pad_8 (.I(RA_0_8), .O(RA[8]));   // c:/users/garre/repos/gw4302/cpld/reu.v(30[16:18])
    OB RA_pad_7 (.I(RA_0_7), .O(RA[7]));   // c:/users/garre/repos/gw4302/cpld/reu.v(30[16:18])
    OB RA_pad_6 (.I(RA_0_6), .O(RA[6]));   // c:/users/garre/repos/gw4302/cpld/reu.v(30[16:18])
    OB RA_pad_5 (.I(RA_0_5), .O(RA[5]));   // c:/users/garre/repos/gw4302/cpld/reu.v(30[16:18])
    OB RA_pad_4 (.I(RA_0_4), .O(RA[4]));   // c:/users/garre/repos/gw4302/cpld/reu.v(30[16:18])
    OB RA_pad_3 (.I(RA_0_3), .O(RA[3]));   // c:/users/garre/repos/gw4302/cpld/reu.v(30[16:18])
    OB RA_pad_2 (.I(RA_0_2), .O(RA[2]));   // c:/users/garre/repos/gw4302/cpld/reu.v(30[16:18])
    OB RA_pad_1 (.I(RA_0_1), .O(RA[1]));   // c:/users/garre/repos/gw4302/cpld/reu.v(30[16:18])
    OB RA_pad_0 (.I(RA_0_0), .O(RA[0]));   // c:/users/garre/repos/gw4302/cpld/reu.v(30[16:18])
    OB DQMH_pad (.I(DQMH_c), .O(DQMH));   // c:/users/garre/repos/gw4302/cpld/reu.v(31[9:13])
    OB DQML_pad (.I(DQML_c), .O(DQML));   // c:/users/garre/repos/gw4302/cpld/reu.v(32[9:13])
    IB C8M_pad (.I(C8M), .O(C8M_c));   // c:/users/garre/repos/gw4302/cpld/reu.v(3[8:11])
    IB PHI2_pad (.I(PHI2), .O(PHI2_c));   // c:/users/garre/repos/gw4302/cpld/reu.v(4[8:12])
    IB nRESET_pad (.I(nRESET), .O(nRESET_c));   // c:/users/garre/repos/gw4302/cpld/reu.v(5[8:14])
    IB BA_pad (.I(BA), .O(BA_c));   // c:/users/garre/repos/gw4302/cpld/reu.v(7[8:10])
    IB nWE_pad (.I(nWE), .O(nWE_c));   // c:/users/garre/repos/gw4302/cpld/reu.v(10[8:11])
    IB nIO2_pad (.I(nIO2), .O(nIO2_c));   // c:/users/garre/repos/gw4302/cpld/reu.v(15[8:12])
    INV i3464 (.A(PHI2_c), .Z(PHI2_N_571));   // c:/users/garre/repos/gw4302/cpld/reu.v(4[8:12])
    LUT4 RegCS_I_0_112_2_lut_rep_79_3_lut (.A(DMA), .B(nIO2_c), .C(nWE_c), 
         .Z(n3644)) /* synthesis lut_function=(!(A+(B+!(C)))) */ ;
    defparam RegCS_I_0_112_2_lut_rep_79_3_lut.init = 16'h1010;
    LUT4 RegRD_I_0_3_lut_4_lut_4_lut (.A(DMA), .B(nIO2_c), .C(nWEDMA_c), 
         .D(nWE_c), .Z(DOE)) /* synthesis lut_function=(A (C)+!A (B+!(D))) */ ;
    defparam RegRD_I_0_3_lut_4_lut_4_lut.init = 16'he4f5;
    LUT4 RegReset_I_0_4_lut_4_lut_rep_103 (.A(DMA), .B(DMAr), .C(nRESETr[2]), 
         .D(nRESETr[1]), .Z(n3914)) /* synthesis lut_function=(!(A+(B (C (D))+!B (D)))) */ ;   // c:/users/garre/repos/gw4302/cpld/reu.v(95[9:10])
    defparam RegReset_I_0_4_lut_4_lut_rep_103.init = 16'h0455;
    VLO i1 (.Z(GND_net));
    LUT4 RegRDD_7__I_0_i6_4_lut (.A(n432), .B(RAMRDD[5]), .C(DMA), .D(n2076), 
         .Z(Dout[5])) /* synthesis lut_function=(A (B+!(C))+!A (B (C+(D))+!B !(C+!(D)))) */ ;   // c:/users/garre/repos/gw4302/cpld/reu.v(101[20:51])
    defparam RegRDD_7__I_0_i6_4_lut.init = 16'hcfca;
    LUT4 RegRDD_7__I_0_i7_4_lut (.A(n3813), .B(RAMRDD[6]), .C(DMA), .D(n2076), 
         .Z(Dout[6])) /* synthesis lut_function=(A (B+!(C))+!A (B (C+(D))+!B !(C+!(D)))) */ ;   // c:/users/garre/repos/gw4302/cpld/reu.v(101[20:51])
    defparam RegRDD_7__I_0_i7_4_lut.init = 16'hcfca;
    CCU2D RAMRDD_7__I_0_8 (.A0(D_out_1), .B0(RAMRDD[1]), .C0(D_out_0), 
          .D0(RAMRDD[0]), .A1(GND_net), .B1(GND_net), .C1(GND_net), 
          .D1(GND_net), .CIN(n2784), .S1(nWEDMA_N_5));
    defparam RAMRDD_7__I_0_8.INIT0 = 16'h9009;
    defparam RAMRDD_7__I_0_8.INIT1 = 16'hFFFF;
    defparam RAMRDD_7__I_0_8.INJECT1_0 = "YES";
    defparam RAMRDD_7__I_0_8.INJECT1_1 = "NO";
    LUT4 RegRDD_7__I_0_i1_4_lut (.A(n3487), .B(RAMRDD[0]), .C(DMA), .D(n2076), 
         .Z(Dout[0])) /* synthesis lut_function=(A (B+!(C))+!A (B (C+(D))+!B !(C+!(D)))) */ ;   // c:/users/garre/repos/gw4302/cpld/reu.v(101[20:51])
    defparam RegRDD_7__I_0_i1_4_lut.init = 16'hcfca;
    LUT4 RegReset_I_0_4_lut_4_lut_rep_101 (.A(DMA), .B(DMAr), .C(nRESETr[2]), 
         .D(nRESETr[1]), .Z(n3912)) /* synthesis lut_function=(!(A+(B (C (D))+!B (D)))) */ ;   // c:/users/garre/repos/gw4302/cpld/reu.v(95[9:10])
    defparam RegReset_I_0_4_lut_4_lut_rep_101.init = 16'h0455;
    LUT4 i902_1_lut_rep_87 (.A(DMA), .Z(n3652)) /* synthesis lut_function=(!(A)) */ ;   // c:/users/garre/repos/gw4302/cpld/reu.v(95[9:10])
    defparam i902_1_lut_rep_87.init = 16'h5555;
    LUT4 RegReset_I_0_4_lut_4_lut (.A(DMA), .B(DMAr), .C(nRESETr[2]), 
         .D(nRESETr[1]), .Z(RegReset)) /* synthesis lut_function=(!(A+(B (C (D))+!B (D)))) */ ;   // c:/users/garre/repos/gw4302/cpld/reu.v(95[9:10])
    defparam RegReset_I_0_4_lut_4_lut.init = 16'h0455;
    TSALL TSALL_INST (.TSALL(GND_net));
    LUT4 i3168_3_lut_3_lut (.A(DMA), .B(BA_c), .C(PHI2_c), .Z(nAOE_N_8)) /* synthesis lut_function=(!(A (B (C))+!A (C))) */ ;   // c:/users/garre/repos/gw4302/cpld/reu.v(95[9:10])
    defparam i3168_3_lut_3_lut.init = 16'h2f2f;
    CCU2D RAMRDD_7__I_0_0 (.A0(GND_net), .B0(GND_net), .C0(GND_net), .D0(GND_net), 
          .A1(D_out_7), .B1(RAMRDD[7]), .C1(D_out_6), .D1(RAMRDD[6]), 
          .COUT(n2783));   // c:/users/garre/repos/gw4302/cpld/reu.v(84[31:50])
    defparam RAMRDD_7__I_0_0.INIT0 = 16'hF000;
    defparam RAMRDD_7__I_0_0.INIT1 = 16'h9009;
    defparam RAMRDD_7__I_0_0.INJECT1_0 = "NO";
    defparam RAMRDD_7__I_0_0.INJECT1_1 = "YES";
    CCU2D RAMRDD_7__I_0_7 (.A0(D_out_5), .B0(RAMRDD[5]), .C0(D_out_4), 
          .D0(RAMRDD[4]), .A1(D_out_3), .B1(RAMRDD[3]), .C1(D_out_2), 
          .D1(RAMRDD[2]), .CIN(n2783), .COUT(n2784));
    defparam RAMRDD_7__I_0_7.INIT0 = 16'h9009;
    defparam RAMRDD_7__I_0_7.INIT1 = 16'h9009;
    defparam RAMRDD_7__I_0_7.INJECT1_0 = "YES";
    defparam RAMRDD_7__I_0_7.INJECT1_1 = "YES";
    DMASeq dmaseq (.DMA(DMA), .XferEnd_N_600(XferEnd_N_600), .n3633(n3633), 
           .AutoloadEN(AutoloadEN), .REUAOut_7__N_194(REUAOut_7__N_194), 
           .n3624(n3624), .\XferType[0] (XferType[0]), .n3629(n3629), 
           .BA_c(BA_c), .nWEDMA_c(nWEDMA_c), .nWEDMA_N_5(nWEDMA_N_5), 
           .Length1_N_645(Length1_N_645), .RAMWR(RAMWR), .n3625(n3625), 
           .Execute(Execute), .nRESETr({nRESETr}), .SetFault(SetFault), 
           .EndBlock(EndBlock), .n3315(n3315), .DMAr(DMAr), .IncCA_N_631(IncCA_N_631), 
           .PHI2_N_571(PHI2_N_571), .n3652(n3652), .nRESET_c(nRESET_c), 
           .IncREUA(IncREUA), .XferC64REU(XferC64REU), .RAMRD(RAMRD), 
           .n3634(n3634), .CAOut_15__N_237(CAOut_15__N_237), .n3632(n3632), 
           .n3621(n3621), .n3638(n3638), .REUAOut_15__N_149(REUAOut_15__N_149), 
           .n3637(n3637), .n3622(n3622), .n3636(n3636), .CAOut_7__N_282(CAOut_7__N_282)) /* synthesis syn_module_defined=1 */ ;   // c:/users/garre/repos/gw4302/cpld/reu.v(78[9] 86[68])
    PUR PUR_INST (.PUR(VCC_net));
    defparam PUR_INST.RST_PULSE = 1;
    RAMctrl ramctrl (.RAMWR(RAMWR), .C8M_N_46(C8M_N_46), .PHI2_c(PHI2_c), 
            .C8M_c(C8M_c), .RAMRD(RAMRD), .nCS_c(nCS_c), .RBA_c_0(RBA_c_0), 
            .REUA({REUA}), .nRAS_c(nRAS_c), .nCAS_c(nCAS_c), .nRWE_c(nRWE_c), 
            .CKE_c(CKE_c), .RA_0_0(RA_0_0), .WRDr({WRDr}), .PHI2_N_571(PHI2_N_571), 
            .D_out_0(D_out_0), .DQML_c(DQML_c), .A_0__N_97(A_0__N_97), 
            .nRESET_c(nRESET_c), .GND_net(GND_net), .VCC_net(VCC_net), 
            .RCLK_c(RCLK_c), .RAMRDD({RAMRDD}), .RD_out_0(RD_out_0), .n1103(n1103), 
            .RBA_c_1(RBA_c_1), .n3911(n3911), .RA_0_1(RA_0_1), .DQMH_c(DQMH_c), 
            .RA_0_2(RA_0_2), .RA_0_3(RA_0_3), .RA_0_4(RA_0_4), .RA_0_5(RA_0_5), 
            .RA_0_6(RA_0_6), .RA_0_7(RA_0_7), .RA_0_8(RA_0_8), .RA_0_9(RA_0_9), 
            .RA_0_10(RA_0_10), .RA_0_11(RA_0_11), .D_out_1(D_out_1), .D_out_2(D_out_2), 
            .D_out_3(D_out_3), .D_out_4(D_out_4), .D_out_5(D_out_5), .D_out_6(D_out_6), 
            .D_out_7(D_out_7), .RD_out_1(RD_out_1), .RD_out_2(RD_out_2), 
            .RD_out_3(RD_out_3), .RD_out_4(RD_out_4), .RD_out_5(RD_out_5), 
            .RD_out_6(RD_out_6), .RD_out_7(RD_out_7)) /* synthesis syn_module_defined=1 */ ;   // c:/users/garre/repos/gw4302/cpld/reu.v(58[10] 65[32])
    
endmodule
//
// Verilog Description of module REUReg
//

module REUReg (GND_net, REUAOut_15__N_149, REUA, n3639, D_out_7, D_out_4, 
            A_out_1, AutoloadEN, PHI2_N_571, n3913, D_out_5, A_out_0, 
            n432, A_out_2, n433, D_out_3, n434, n3912, XferEnd_N_600, 
            DMA, n3914, D_out_1, \XferType[0] , XferC64REU, n3625, 
            D_out_6, D_out_2, CA, D_out_0, EndBlock, n3624, n3637, 
            A_out_3, A_0__N_97, n3629, SetFault, n3911, n3643, A_out_4, 
            FF00DecodeEN, n33, n34, Execute, n3640, IncCA_N_631, 
            n3315, n2076, n3644, n430, n3650, n3632, n3634, n3636, 
            Length1_N_645, \RAMRDD[2] , \Dout[2] , ExecuteEN, nIRQ_c, 
            n3638, n3487, IncREUA, RegReset, n3481, n7, n3276, 
            n3633, n3622, A_out_13, n22, n3621, n3813, REUAOut_7__N_194, 
            CAOut_15__N_237, CAOut_7__N_282, RAMWR) /* synthesis syn_module_defined=1 */ ;
    input GND_net;
    input REUAOut_15__N_149;
    output [23:0]REUA;
    input n3639;
    input D_out_7;
    input D_out_4;
    input A_out_1;
    output AutoloadEN;
    input PHI2_N_571;
    input n3913;
    input D_out_5;
    input A_out_0;
    output n432;
    input A_out_2;
    output n433;
    input D_out_3;
    output n434;
    input n3912;
    input XferEnd_N_600;
    input DMA;
    input n3914;
    input D_out_1;
    output \XferType[0] ;
    output XferC64REU;
    output n3625;
    input D_out_6;
    input D_out_2;
    output [15:0]CA;
    input D_out_0;
    output EndBlock;
    input n3624;
    output n3637;
    input A_out_3;
    output A_0__N_97;
    output n3629;
    input SetFault;
    input n3911;
    input n3643;
    input A_out_4;
    output FF00DecodeEN;
    input n33;
    input n34;
    output Execute;
    input n3640;
    input IncCA_N_631;
    input n3315;
    output n2076;
    input n3644;
    output n430;
    output n3650;
    output n3632;
    output n3634;
    output n3636;
    output Length1_N_645;
    input \RAMRDD[2] ;
    output \Dout[2] ;
    output ExecuteEN;
    output nIRQ_c;
    output n3638;
    output n3487;
    input IncREUA;
    input RegReset;
    output n3481;
    input n7;
    output n3276;
    output n3633;
    input n3622;
    input A_out_13;
    output n22;
    input n3621;
    output n3813;
    input REUAOut_7__N_194;
    input CAOut_15__N_237;
    input CAOut_7__N_282;
    input RAMWR;
    
    wire PHI2_N_571 /* synthesis is_inv_clock=1 */ ;   // c:/users/garre/repos/gw4302/cpld/dmaseq.v(103[11:18])
    
    wire n2907;
    wire [18:0]REUAWritten;   // c:/users/garre/repos/gw4302/cpld/reg.v(46[12:23])
    wire [7:0]REUAOut_15__N_146;
    
    wire n2908, n3655;
    wire [7:0]CAOut_7__N_281;
    wire [7:0]n307;
    wire [7:0]n324;
    wire [7:0]n340;
    
    wire n3312, PHI2_N_571_enable_76;
    wire [7:0]n352;
    
    wire n3303, n3305, n3334, n3811, n3490, n3812, n3300, n3302, 
        n3297, n3299;
    wire [15:0]CAWritten;   // c:/users/garre/repos/gw4302/cpld/reg.v(41[12:21])
    
    wire PHI2_N_571_enable_64, n3631, PHI2_N_571_enable_57, PHI2_N_571_enable_74;
    wire [1:0]XferType;   // c:/users/garre/repos/gw4302/cpld/reg.v(37[11:19])
    wire [15:0]Length;   // c:/users/garre/repos/gw4302/cpld/reg.v(50[12:18])
    
    wire n3476, DF01Reserved6, n3810, n2252;
    wire [2:0]n303;
    wire [2:0]n312;
    
    wire n3809, n3656;
    wire [7:0]CAOut_15__N_234;
    wire [7:0]n306;
    
    wire n2876;
    wire [7:0]Length_7__N_443;
    
    wire n2877;
    wire [15:0]LengthWritten;   // c:/users/garre/repos/gw4302/cpld/reg.v(51[12:25])
    wire [7:0]Length_15__N_396;
    wire [7:0]n928;
    
    wire n3807;
    wire [1:0]IncMode;   // c:/users/garre/repos/gw4302/cpld/reg.v(60[11:18])
    
    wire n3808, EndBlockMask;
    wire [3:2]DF01Reserved32;   // c:/users/garre/repos/gw4302/cpld/reg.v(33[11:25])
    
    wire PHI2_N_571_enable_67, n3298, n3654, PHI2_N_571_enable_43, n3301, 
        n3304, n3482, n3674, n3909, n3448, n3651;
    wire [7:0]n927;
    
    wire Length_5__N_451, Length_1__N_471, Fault, n1159, n17, Length_6__N_446, 
        Length_4__N_456, Length_0__N_476, Length_3__N_461, Length_7__N_440, 
        Length_2__N_466, PHI2_N_571_enable_69, n3653;
    wire [7:0]REUAOut_7__N_193;
    wire [7:0]n305;
    
    wire n3222, PHI2_N_571_enable_31, n1228, PHI2_N_571_enable_77, n3485, 
        n1226, n3630;
    wire [7:0]n304;
    
    wire n1224, n3642, n1222, n1220, Length_15__N_393, n3100;
    wire [7:0]n364;
    
    wire n3478, n1218, n1216, n1214, PHI2_N_571_enable_73, IntEnable, 
        PHI2_N_571_enable_42, n3314;
    wire [7:0]n409;
    wire [7:0]n376;
    
    wire FaultMask, PHI2_N_571_enable_75, n3479, Length_8__N_435, Length_9__N_430, 
        Length_10__N_425, n17_adj_666, n30, n26, n18, REUAOut_18__N_130, 
        n3623, Length_11__N_420, n961, Length_12__N_415, n2906, REUAOut_15__N_147, 
        n3646, n15, n13, n10, IRQ_N_536, n3907, n3908, n28, 
        n22_c, n1370, IncCAg, n3486, n3483, Length_13__N_410, Length_14__N_405, 
        n3484, n15_adj_667, n11, n2914, n12, n3620, n2913, n3480, 
        n3477, n15_adj_668, n6, n3286, PHI2_N_571_enable_86, n3262, 
        n3270, n2912, n3673, n3672, n2901, n2900, n2899, n2898, 
        IncREUAg, n2893, n2892, n2891, n2890, CAOut_15__N_235, n2885, 
        n2884, n2883, n2882, n2875, n2878, n2911, n17_adj_670, 
        n15_adj_671, n11_adj_672, n12_adj_673, n2909;
    
    CCU2D REUAOut_15__I_0_5 (.A0(GND_net), .B0(REUAOut_15__N_149), .C0(REUAWritten[10]), 
          .D0(REUA[10]), .A1(GND_net), .B1(REUAOut_15__N_149), .C1(REUAWritten[11]), 
          .D1(REUA[11]), .CIN(n2907), .COUT(n2908), .S0(REUAOut_15__N_146[2]), 
          .S1(REUAOut_15__N_146[3]));   // c:/users/garre/repos/gw4302/cpld/reg.v(173[17:33])
    defparam REUAOut_15__I_0_5.INIT0 = 16'h596a;
    defparam REUAOut_15__I_0_5.INIT1 = 16'h596a;
    defparam REUAOut_15__I_0_5.INJECT1_0 = "NO";
    defparam REUAOut_15__I_0_5.INJECT1_1 = "NO";
    LUT4 mux_177_i8_3_lut_4_lut (.A(n3655), .B(n3639), .C(D_out_7), .D(CAOut_7__N_281[7]), 
         .Z(n307[7])) /* synthesis lut_function=(A (D)+!A (B (D)+!B (C))) */ ;
    defparam mux_177_i8_3_lut_4_lut.init = 16'hfe10;
    LUT4 mux_177_i5_3_lut_4_lut (.A(n3655), .B(n3639), .C(D_out_4), .D(CAOut_7__N_281[4]), 
         .Z(n307[4])) /* synthesis lut_function=(A (D)+!A (B (D)+!B (C))) */ ;
    defparam mux_177_i5_3_lut_4_lut.init = 16'hfe10;
    PFUMX i3096 (.BLUT(n324[7]), .ALUT(n340[7]), .C0(A_out_1), .Z(n3312));
    FD1P3IX AutoloadEN_582 (.D(D_out_5), .SP(PHI2_N_571_enable_76), .CD(n3913), 
            .CK(PHI2_N_571), .Q(AutoloadEN)) /* synthesis LSE_LINE_FILE_ID=6, LSE_LCOL=9, LSE_RCOL=62, LSE_LLINE=67, LSE_RLINE=76 */ ;   // c:/users/garre/repos/gw4302/cpld/reg.v(96[8] 115[4])
    defparam AutoloadEN_582.GSR = "ENABLED";
    LUT4 mux_198_i8_3_lut (.A(REUA[7]), .B(REUA[15]), .C(A_out_0), .Z(n352[7])) /* synthesis lut_function=(A (B+!(C))+!A (B (C))) */ ;   // c:/users/garre/repos/gw4302/cpld/reg.v(67[2] 78[7])
    defparam mux_198_i8_3_lut.init = 16'hcaca;
    L6MUX21 mux_219_i6 (.D0(n3303), .D1(n3305), .SD(n3334), .Z(n432));
    LUT4 n3811_bdd_3_lut (.A(n3811), .B(n3490), .C(A_out_2), .Z(n3812)) /* synthesis lut_function=(A (B+!(C))+!A (B (C))) */ ;
    defparam n3811_bdd_3_lut.init = 16'hcaca;
    L6MUX21 mux_219_i5 (.D0(n3300), .D1(n3302), .SD(n3334), .Z(n433));
    LUT4 mux_177_i4_3_lut_4_lut (.A(n3655), .B(n3639), .C(D_out_3), .D(CAOut_7__N_281[3]), 
         .Z(n307[3])) /* synthesis lut_function=(A (D)+!A (B (D)+!B (C))) */ ;
    defparam mux_177_i4_3_lut_4_lut.init = 16'hfe10;
    L6MUX21 mux_219_i4 (.D0(n3297), .D1(n3299), .SD(n3334), .Z(n434));
    FD1P3IX CAWritten_13__612 (.D(D_out_5), .SP(PHI2_N_571_enable_64), .CD(n3913), 
            .CK(PHI2_N_571), .Q(CAWritten[13])) /* synthesis LSE_LINE_FILE_ID=6, LSE_LCOL=9, LSE_RCOL=62, LSE_LLINE=67, LSE_RLINE=76 */ ;   // c:/users/garre/repos/gw4302/cpld/reg.v(135[8] 147[4])
    defparam CAWritten_13__612.GSR = "ENABLED";
    LUT4 i2_2_lut_3_lut_4_lut (.A(n3912), .B(n3631), .C(XferEnd_N_600), 
         .D(DMA), .Z(PHI2_N_571_enable_57)) /* synthesis lut_function=(A+((C (D))+!B)) */ ;   // c:/users/garre/repos/gw4302/cpld/reg.v(96[8] 115[4])
    defparam i2_2_lut_3_lut_4_lut.init = 16'hfbbb;
    FD1P3IX REUAWritten_17__659 (.D(D_out_1), .SP(PHI2_N_571_enable_74), 
            .CD(n3914), .CK(PHI2_N_571), .Q(REUAWritten[17])) /* synthesis LSE_LINE_FILE_ID=6, LSE_LCOL=9, LSE_RCOL=62, LSE_LLINE=67, LSE_RLINE=76 */ ;   // c:/users/garre/repos/gw4302/cpld/reg.v(176[8] 189[4])
    defparam REUAWritten_17__659.GSR = "ENABLED";
    LUT4 i3197_2_lut_4_lut (.A(XferType[1]), .B(D_out_1), .C(n3631), .D(\XferType[0] ), 
         .Z(XferC64REU)) /* synthesis lut_function=(!(A (B+(C+(D)))+!A (B ((D)+!C)+!B (D)))) */ ;   // c:/users/garre/repos/gw4302/cpld/reg.v(119[27:62])
    defparam i3197_2_lut_4_lut.init = 16'h0053;
    LUT4 i2_2_lut_4_lut (.A(XferType[1]), .B(D_out_1), .C(n3631), .D(\XferType[0] ), 
         .Z(n3625)) /* synthesis lut_function=(!(A (B (D)+!B ((D)+!C))+!A ((C+(D))+!B))) */ ;   // c:/users/garre/repos/gw4302/cpld/reg.v(119[27:62])
    defparam i2_2_lut_4_lut.init = 16'h00ac;
    LUT4 n359_bdd_3_lut_3233 (.A(A_out_1), .B(Length[9]), .C(A_out_0), 
         .Z(n3476)) /* synthesis lut_function=(A+(B+(C))) */ ;
    defparam n359_bdd_3_lut_3233.init = 16'hfefe;
    LUT4 mux_177_i6_3_lut_4_lut (.A(n3655), .B(n3639), .C(D_out_5), .D(CAOut_7__N_281[5]), 
         .Z(n307[5])) /* synthesis lut_function=(A (D)+!A (B (D)+!B (C))) */ ;
    defparam mux_177_i6_3_lut_4_lut.init = 16'hfe10;
    FD1P3IX CAWritten_14__611 (.D(D_out_6), .SP(PHI2_N_571_enable_64), .CD(n3914), 
            .CK(PHI2_N_571), .Q(CAWritten[14])) /* synthesis LSE_LINE_FILE_ID=6, LSE_LCOL=9, LSE_RCOL=62, LSE_LLINE=67, LSE_RLINE=76 */ ;   // c:/users/garre/repos/gw4302/cpld/reg.v(135[8] 147[4])
    defparam CAWritten_14__611.GSR = "ENABLED";
    LUT4 mux_177_i3_3_lut_4_lut (.A(n3655), .B(n3639), .C(D_out_2), .D(CAOut_7__N_281[2]), 
         .Z(n307[2])) /* synthesis lut_function=(A (D)+!A (B (D)+!B (C))) */ ;
    defparam mux_177_i3_3_lut_4_lut.init = 16'hfe10;
    FD1S3IX CA_7__586 (.D(n307[7]), .CK(PHI2_N_571), .CD(n3914), .Q(CA[7])) /* synthesis LSE_LINE_FILE_ID=6, LSE_LCOL=9, LSE_RCOL=62, LSE_LLINE=67, LSE_RLINE=76 */ ;   // c:/users/garre/repos/gw4302/cpld/reg.v(122[8] 134[4])
    defparam CA_7__586.GSR = "ENABLED";
    LUT4 mux_177_i2_3_lut_4_lut (.A(n3655), .B(n3639), .C(D_out_1), .D(CAOut_7__N_281[1]), 
         .Z(n307[1])) /* synthesis lut_function=(A (D)+!A (B (D)+!B (C))) */ ;
    defparam mux_177_i2_3_lut_4_lut.init = 16'hfe10;
    LUT4 mux_177_i1_3_lut_4_lut (.A(n3655), .B(n3639), .C(D_out_0), .D(CAOut_7__N_281[0]), 
         .Z(n307[0])) /* synthesis lut_function=(A (D)+!A (B (D)+!B (C))) */ ;
    defparam mux_177_i1_3_lut_4_lut.init = 16'hfe10;
    LUT4 EndBlock_bdd_3_lut_3410 (.A(EndBlock), .B(DF01Reserved6), .C(A_out_0), 
         .Z(n3810)) /* synthesis lut_function=(A (B+!(C))+!A (B (C))) */ ;
    defparam EndBlock_bdd_3_lut_3410.init = 16'hcaca;
    LUT4 mux_182_i3_3_lut_4_lut (.A(n3655), .B(n2252), .C(D_out_2), .D(n303[2]), 
         .Z(n312[2])) /* synthesis lut_function=(A (D)+!A (B (D)+!B (C))) */ ;
    defparam mux_182_i3_3_lut_4_lut.init = 16'hfe10;
    LUT4 mux_182_i2_3_lut_4_lut (.A(n3655), .B(n2252), .C(D_out_1), .D(n303[1]), 
         .Z(n312[1])) /* synthesis lut_function=(A (D)+!A (B (D)+!B (C))) */ ;
    defparam mux_182_i2_3_lut_4_lut.init = 16'hfe10;
    LUT4 mux_182_i1_3_lut_4_lut (.A(n3655), .B(n2252), .C(D_out_0), .D(n303[0]), 
         .Z(n312[0])) /* synthesis lut_function=(A (D)+!A (B (D)+!B (C))) */ ;
    defparam mux_182_i1_3_lut_4_lut.init = 16'hfe10;
    LUT4 EndBlock_bdd_3_lut_3405 (.A(CA[6]), .B(A_out_0), .C(CA[14]), 
         .Z(n3809)) /* synthesis lut_function=(A ((C)+!B)+!A (B (C))) */ ;
    defparam EndBlock_bdd_3_lut_3405.init = 16'he2e2;
    LUT4 mux_176_i3_3_lut_4_lut (.A(n3639), .B(n3656), .C(D_out_2), .D(CAOut_15__N_234[2]), 
         .Z(n306[2])) /* synthesis lut_function=(A (D)+!A (B (C)+!B (D))) */ ;
    defparam mux_176_i3_3_lut_4_lut.init = 16'hfb40;
    CCU2D Length_7__I_0_add_2_5 (.A0(Length[3]), .B0(GND_net), .C0(GND_net), 
          .D0(GND_net), .A1(Length[4]), .B1(GND_net), .C1(GND_net), 
          .D1(GND_net), .CIN(n2876), .COUT(n2877), .S0(Length_7__N_443[3]), 
          .S1(Length_7__N_443[4]));   // c:/users/garre/repos/gw4302/cpld/reg.v(202[18:35])
    defparam Length_7__I_0_add_2_5.INIT0 = 16'h5555;
    defparam Length_7__I_0_add_2_5.INIT1 = 16'h5555;
    defparam Length_7__I_0_add_2_5.INJECT1_0 = "NO";
    defparam Length_7__I_0_add_2_5.INJECT1_1 = "NO";
    LUT4 mux_755_i6_3_lut_4_lut (.A(n3624), .B(n3637), .C(LengthWritten[13]), 
         .D(Length_15__N_396[5]), .Z(n928[5])) /* synthesis lut_function=(A (C)+!A (B (C)+!B (D))) */ ;   // c:/users/garre/repos/gw4302/cpld/reg.v(212[15:50])
    defparam mux_755_i6_3_lut_4_lut.init = 16'hf1e0;
    LUT4 i3193_2_lut (.A(A_out_3), .B(A_out_2), .Z(n3334)) /* synthesis lut_function=(A+(B)) */ ;   // c:/users/garre/repos/gw4302/cpld/reg.v(67[2] 78[7])
    defparam i3193_2_lut.init = 16'heeee;
    LUT4 n3807_bdd_3_lut (.A(n3807), .B(IncMode[0]), .C(A_out_1), .Z(n3808)) /* synthesis lut_function=(A (B+!(C))+!A (B (C))) */ ;
    defparam n3807_bdd_3_lut.init = 16'hcaca;
    LUT4 Length_14__bdd_3_lut_3455 (.A(Length[14]), .B(A_out_0), .C(EndBlockMask), 
         .Z(n3807)) /* synthesis lut_function=(A ((C)+!B)+!A (B (C))) */ ;
    defparam Length_14__bdd_3_lut_3455.init = 16'he2e2;
    FD1P3IX DF01Reserved32__i2 (.D(D_out_2), .SP(PHI2_N_571_enable_76), 
            .CD(n3914), .CK(PHI2_N_571), .Q(DF01Reserved32[2])) /* synthesis LSE_LINE_FILE_ID=6, LSE_LCOL=9, LSE_RCOL=62, LSE_LLINE=67, LSE_RLINE=76 */ ;   // c:/users/garre/repos/gw4302/cpld/reg.v(96[8] 115[4])
    defparam DF01Reserved32__i2.GSR = "ENABLED";
    FD1P3IX REUAWritten_11__646 (.D(D_out_3), .SP(PHI2_N_571_enable_67), 
            .CD(n3914), .CK(PHI2_N_571), .Q(REUAWritten[11])) /* synthesis LSE_LINE_FILE_ID=6, LSE_LCOL=9, LSE_RCOL=62, LSE_LLINE=67, LSE_RLINE=76 */ ;   // c:/users/garre/repos/gw4302/cpld/reg.v(163[8] 175[4])
    defparam REUAWritten_11__646.GSR = "ENABLED";
    FD1P3IX REUAWritten_12__645 (.D(D_out_4), .SP(PHI2_N_571_enable_67), 
            .CD(n3913), .CK(PHI2_N_571), .Q(REUAWritten[12])) /* synthesis LSE_LINE_FILE_ID=6, LSE_LCOL=9, LSE_RCOL=62, LSE_LLINE=67, LSE_RLINE=76 */ ;   // c:/users/garre/repos/gw4302/cpld/reg.v(163[8] 175[4])
    defparam REUAWritten_12__645.GSR = "ENABLED";
    FD1P3IX REUAWritten_13__644 (.D(D_out_5), .SP(PHI2_N_571_enable_67), 
            .CD(n3913), .CK(PHI2_N_571), .Q(REUAWritten[13])) /* synthesis LSE_LINE_FILE_ID=6, LSE_LCOL=9, LSE_RCOL=62, LSE_LLINE=67, LSE_RLINE=76 */ ;   // c:/users/garre/repos/gw4302/cpld/reg.v(163[8] 175[4])
    defparam REUAWritten_13__644.GSR = "ENABLED";
    PFUMX i3083 (.BLUT(n352[3]), .ALUT(n3298), .C0(n3654), .Z(n3299));
    FD1P3IX REUAWritten_5__628 (.D(D_out_5), .SP(PHI2_N_571_enable_43), 
            .CD(n3913), .CK(PHI2_N_571), .Q(REUAWritten[5])) /* synthesis LSE_LINE_FILE_ID=6, LSE_LCOL=9, LSE_RCOL=62, LSE_LLINE=67, LSE_RLINE=76 */ ;   // c:/users/garre/repos/gw4302/cpld/reg.v(150[8] 162[4])
    defparam REUAWritten_5__628.GSR = "ENABLED";
    LUT4 mux_176_i4_3_lut_4_lut (.A(n3639), .B(n3656), .C(D_out_3), .D(CAOut_15__N_234[3]), 
         .Z(n306[3])) /* synthesis lut_function=(A (D)+!A (B (C)+!B (D))) */ ;
    defparam mux_176_i4_3_lut_4_lut.init = 16'hfb40;
    PFUMX i3086 (.BLUT(n352[4]), .ALUT(n3301), .C0(n3654), .Z(n3302));
    LUT4 mux_176_i5_3_lut_4_lut (.A(n3639), .B(n3656), .C(D_out_4), .D(CAOut_15__N_234[4]), 
         .Z(n306[4])) /* synthesis lut_function=(A (D)+!A (B (C)+!B (D))) */ ;
    defparam mux_176_i5_3_lut_4_lut.init = 16'hfb40;
    LUT4 A_0__I_0_1_lut (.A(REUA[0]), .Z(A_0__N_97)) /* synthesis lut_function=(!(A)) */ ;   // c:/users/garre/repos/gw4302/cpld/ram.v(218[13:18])
    defparam A_0__I_0_1_lut.init = 16'h5555;
    FD1P3IX REUAWritten_18__658 (.D(D_out_2), .SP(PHI2_N_571_enable_74), 
            .CD(n3913), .CK(PHI2_N_571), .Q(REUAWritten[18])) /* synthesis LSE_LINE_FILE_ID=6, LSE_LCOL=9, LSE_RCOL=62, LSE_LLINE=67, LSE_RLINE=76 */ ;   // c:/users/garre/repos/gw4302/cpld/reg.v(176[8] 189[4])
    defparam REUAWritten_18__658.GSR = "ENABLED";
    PFUMX i3089 (.BLUT(n352[5]), .ALUT(n3304), .C0(n3654), .Z(n3305));
    FD1S3IX CA_6__587 (.D(n307[6]), .CK(PHI2_N_571), .CD(n3913), .Q(CA[6])) /* synthesis LSE_LINE_FILE_ID=6, LSE_LCOL=9, LSE_RCOL=62, LSE_LLINE=67, LSE_RLINE=76 */ ;   // c:/users/garre/repos/gw4302/cpld/reg.v(122[8] 134[4])
    defparam CA_6__587.GSR = "ENABLED";
    LUT4 mux_176_i6_3_lut_4_lut (.A(n3639), .B(n3656), .C(D_out_5), .D(CAOut_15__N_234[5]), 
         .Z(n306[5])) /* synthesis lut_function=(A (D)+!A (B (C)+!B (D))) */ ;
    defparam mux_176_i6_3_lut_4_lut.init = 16'hfb40;
    LUT4 n360_bdd_3_lut_3240 (.A(Length[8]), .B(A_out_1), .C(A_out_0), 
         .Z(n3482)) /* synthesis lut_function=(A+(B+(C))) */ ;
    defparam n360_bdd_3_lut_3240.init = 16'hfefe;
    LUT4 mux_176_i7_3_lut_4_lut (.A(n3639), .B(n3656), .C(D_out_6), .D(CAOut_15__N_234[6]), 
         .Z(n306[6])) /* synthesis lut_function=(A (D)+!A (B (C)+!B (D))) */ ;
    defparam mux_176_i7_3_lut_4_lut.init = 16'hfb40;
    LUT4 mux_176_i8_3_lut_4_lut (.A(n3639), .B(n3656), .C(D_out_7), .D(CAOut_15__N_234[7]), 
         .Z(n306[7])) /* synthesis lut_function=(A (D)+!A (B (C)+!B (D))) */ ;
    defparam mux_176_i8_3_lut_4_lut.init = 16'hfb40;
    LUT4 n3447_bdd_3_lut (.A(n3674), .B(n3909), .C(A_out_0), .Z(n3448)) /* synthesis lut_function=(A (B+!(C))+!A (B (C))) */ ;
    defparam n3447_bdd_3_lut.init = 16'hcaca;
    FD1S3IX CA_5__588 (.D(n307[5]), .CK(PHI2_N_571), .CD(n3913), .Q(CA[5])) /* synthesis LSE_LINE_FILE_ID=6, LSE_LCOL=9, LSE_RCOL=62, LSE_LLINE=67, LSE_RLINE=76 */ ;   // c:/users/garre/repos/gw4302/cpld/reg.v(122[8] 134[4])
    defparam CA_5__588.GSR = "ENABLED";
    FD1S3IX CA_4__589 (.D(n307[4]), .CK(PHI2_N_571), .CD(n3914), .Q(CA[4])) /* synthesis LSE_LINE_FILE_ID=6, LSE_LCOL=9, LSE_RCOL=62, LSE_LLINE=67, LSE_RLINE=76 */ ;   // c:/users/garre/repos/gw4302/cpld/reg.v(122[8] 134[4])
    defparam CA_4__589.GSR = "ENABLED";
    FD1S3IX CA_3__590 (.D(n307[3]), .CK(PHI2_N_571), .CD(n3914), .Q(CA[3])) /* synthesis LSE_LINE_FILE_ID=6, LSE_LCOL=9, LSE_RCOL=62, LSE_LLINE=67, LSE_RLINE=76 */ ;   // c:/users/garre/repos/gw4302/cpld/reg.v(122[8] 134[4])
    defparam CA_3__590.GSR = "ENABLED";
    FD1S3IX CA_2__591 (.D(n307[2]), .CK(PHI2_N_571), .CD(n3913), .Q(CA[2])) /* synthesis LSE_LINE_FILE_ID=6, LSE_LCOL=9, LSE_RCOL=62, LSE_LLINE=67, LSE_RLINE=76 */ ;   // c:/users/garre/repos/gw4302/cpld/reg.v(122[8] 134[4])
    defparam CA_2__591.GSR = "ENABLED";
    FD1S3IX CA_1__592 (.D(n307[1]), .CK(PHI2_N_571), .CD(n3913), .Q(CA[1])) /* synthesis LSE_LINE_FILE_ID=6, LSE_LCOL=9, LSE_RCOL=62, LSE_LLINE=67, LSE_RLINE=76 */ ;   // c:/users/garre/repos/gw4302/cpld/reg.v(122[8] 134[4])
    defparam CA_1__592.GSR = "ENABLED";
    FD1S3IX CA_0__593 (.D(n307[0]), .CK(PHI2_N_571), .CD(n3914), .Q(CA[0])) /* synthesis LSE_LINE_FILE_ID=6, LSE_LCOL=9, LSE_RCOL=62, LSE_LLINE=67, LSE_RLINE=76 */ ;   // c:/users/garre/repos/gw4302/cpld/reg.v(122[8] 134[4])
    defparam CA_0__593.GSR = "ENABLED";
    FD1S3IX CA_15__602 (.D(n306[7]), .CK(PHI2_N_571), .CD(n3914), .Q(CA[15])) /* synthesis LSE_LINE_FILE_ID=6, LSE_LCOL=9, LSE_RCOL=62, LSE_LLINE=67, LSE_RLINE=76 */ ;   // c:/users/garre/repos/gw4302/cpld/reg.v(135[8] 147[4])
    defparam CA_15__602.GSR = "ENABLED";
    LUT4 XferType_1__I_0_i2_3_lut_rep_64_4_lut (.A(n3651), .B(n3639), .C(D_out_1), 
         .D(XferType[1]), .Z(n3629)) /* synthesis lut_function=(A (D)+!A (B (D)+!B (C))) */ ;
    defparam XferType_1__I_0_i2_3_lut_rep_64_4_lut.init = 16'hfe10;
    LUT4 mux_176_i2_3_lut_4_lut (.A(n3639), .B(n3656), .C(D_out_1), .D(CAOut_15__N_234[1]), 
         .Z(n306[1])) /* synthesis lut_function=(A (D)+!A (B (C)+!B (D))) */ ;
    defparam mux_176_i2_3_lut_4_lut.init = 16'hfb40;
    LUT4 mux_176_i1_3_lut_4_lut (.A(n3639), .B(n3656), .C(D_out_0), .D(CAOut_15__N_234[0]), 
         .Z(n306[0])) /* synthesis lut_function=(A (D)+!A (B (C)+!B (D))) */ ;
    defparam mux_176_i1_3_lut_4_lut.init = 16'hfb40;
    FD1P3IX REUAWritten_0__633 (.D(D_out_0), .SP(PHI2_N_571_enable_43), 
            .CD(n3914), .CK(PHI2_N_571), .Q(REUAWritten[0])) /* synthesis LSE_LINE_FILE_ID=6, LSE_LCOL=9, LSE_RCOL=62, LSE_LLINE=67, LSE_RLINE=76 */ ;   // c:/users/garre/repos/gw4302/cpld/reg.v(150[8] 162[4])
    defparam REUAWritten_0__633.GSR = "ENABLED";
    LUT4 Length_5__I_104_3_lut_4_lut (.A(n2252), .B(n3656), .C(D_out_5), 
         .D(n927[5]), .Z(Length_5__N_451)) /* synthesis lut_function=(A (D)+!A (B (C)+!B (D))) */ ;
    defparam Length_5__I_104_3_lut_4_lut.init = 16'hfb40;
    LUT4 Length_1__I_112_3_lut_4_lut (.A(n2252), .B(n3656), .C(D_out_1), 
         .D(n927[1]), .Z(Length_1__N_471)) /* synthesis lut_function=(A (D)+!A (B (C)+!B (D))) */ ;
    defparam Length_1__I_112_3_lut_4_lut.init = 16'hfb40;
    FD1P3IX Fault_579 (.D(n3911), .SP(SetFault), .CD(n1159), .CK(PHI2_N_571), 
            .Q(Fault)) /* synthesis LSE_LINE_FILE_ID=6, LSE_LCOL=9, LSE_RCOL=62, LSE_LLINE=67, LSE_RLINE=76 */ ;   // c:/users/garre/repos/gw4302/cpld/reg.v(81[8] 92[4])
    defparam Fault_579.GSR = "ENABLED";
    LUT4 i7_4_lut (.A(IncMode[0]), .B(REUA[0]), .C(REUA[2]), .D(REUA[7]), 
         .Z(n17)) /* synthesis lut_function=(!(A+!(B (C (D))))) */ ;
    defparam i7_4_lut.init = 16'h4000;
    LUT4 Length_6__I_102_3_lut_4_lut (.A(n2252), .B(n3656), .C(D_out_6), 
         .D(n927[6]), .Z(Length_6__N_446)) /* synthesis lut_function=(A (D)+!A (B (C)+!B (D))) */ ;
    defparam Length_6__I_102_3_lut_4_lut.init = 16'hfb40;
    LUT4 Length_4__I_106_3_lut_4_lut (.A(n2252), .B(n3656), .C(D_out_4), 
         .D(n927[4]), .Z(Length_4__N_456)) /* synthesis lut_function=(A (D)+!A (B (C)+!B (D))) */ ;
    defparam Length_4__I_106_3_lut_4_lut.init = 16'hfb40;
    LUT4 Length_0__I_114_3_lut_4_lut (.A(n2252), .B(n3656), .C(D_out_0), 
         .D(n927[0]), .Z(Length_0__N_476)) /* synthesis lut_function=(A (D)+!A (B (C)+!B (D))) */ ;
    defparam Length_0__I_114_3_lut_4_lut.init = 16'hfb40;
    LUT4 Length_3__I_108_3_lut_4_lut (.A(n2252), .B(n3656), .C(D_out_3), 
         .D(n927[3]), .Z(Length_3__N_461)) /* synthesis lut_function=(A (D)+!A (B (C)+!B (D))) */ ;
    defparam Length_3__I_108_3_lut_4_lut.init = 16'hfb40;
    LUT4 Length_7__I_100_3_lut_4_lut (.A(n2252), .B(n3656), .C(D_out_7), 
         .D(n927[7]), .Z(Length_7__N_440)) /* synthesis lut_function=(A (D)+!A (B (C)+!B (D))) */ ;
    defparam Length_7__I_100_3_lut_4_lut.init = 16'hfb40;
    LUT4 Length_2__I_110_3_lut_4_lut (.A(n2252), .B(n3656), .C(D_out_2), 
         .D(n927[2]), .Z(Length_2__N_466)) /* synthesis lut_function=(A (D)+!A (B (C)+!B (D))) */ ;
    defparam Length_2__I_110_3_lut_4_lut.init = 16'hfb40;
    FD1P3IX CAWritten_15__610 (.D(D_out_7), .SP(PHI2_N_571_enable_64), .CD(n3914), 
            .CK(PHI2_N_571), .Q(CAWritten[15])) /* synthesis LSE_LINE_FILE_ID=6, LSE_LCOL=9, LSE_RCOL=62, LSE_LLINE=67, LSE_RLINE=76 */ ;   // c:/users/garre/repos/gw4302/cpld/reg.v(135[8] 147[4])
    defparam CAWritten_15__610.GSR = "ENABLED";
    FD1P3IX CAWritten_0__601 (.D(D_out_0), .SP(PHI2_N_571_enable_69), .CD(n3914), 
            .CK(PHI2_N_571), .Q(CAWritten[0])) /* synthesis LSE_LINE_FILE_ID=6, LSE_LCOL=9, LSE_RCOL=62, LSE_LLINE=67, LSE_RLINE=76 */ ;   // c:/users/garre/repos/gw4302/cpld/reg.v(122[8] 134[4])
    defparam CAWritten_0__601.GSR = "ENABLED";
    LUT4 i3_4_lut (.A(n3643), .B(A_out_3), .C(A_out_2), .D(A_out_4), 
         .Z(n2252)) /* synthesis lut_function=(A+(B+((D)+!C))) */ ;
    defparam i3_4_lut.init = 16'hffef;
    FD1S3IX CA_14__603 (.D(n306[6]), .CK(PHI2_N_571), .CD(n3914), .Q(CA[14])) /* synthesis LSE_LINE_FILE_ID=6, LSE_LCOL=9, LSE_RCOL=62, LSE_LLINE=67, LSE_RLINE=76 */ ;   // c:/users/garre/repos/gw4302/cpld/reg.v(135[8] 147[4])
    defparam CA_14__603.GSR = "ENABLED";
    LUT4 mux_175_i8_3_lut_4_lut (.A(n3653), .B(n2252), .C(D_out_7), .D(REUAOut_7__N_193[7]), 
         .Z(n305[7])) /* synthesis lut_function=(A (D)+!A (B (D)+!B (C))) */ ;
    defparam mux_175_i8_3_lut_4_lut.init = 16'hfe10;
    LUT4 mux_177_i7_3_lut_4_lut (.A(n3655), .B(n3639), .C(D_out_6), .D(CAOut_7__N_281[6]), 
         .Z(n307[6])) /* synthesis lut_function=(A (D)+!A (B (D)+!B (C))) */ ;
    defparam mux_177_i7_3_lut_4_lut.init = 16'hfe10;
    FD1S3IX CA_13__604 (.D(n306[5]), .CK(PHI2_N_571), .CD(n3913), .Q(CA[13])) /* synthesis LSE_LINE_FILE_ID=6, LSE_LCOL=9, LSE_RCOL=62, LSE_LLINE=67, LSE_RLINE=76 */ ;   // c:/users/garre/repos/gw4302/cpld/reg.v(135[8] 147[4])
    defparam CA_13__604.GSR = "ENABLED";
    FD1S3IX CA_12__605 (.D(n306[4]), .CK(PHI2_N_571), .CD(n3914), .Q(CA[12])) /* synthesis LSE_LINE_FILE_ID=6, LSE_LCOL=9, LSE_RCOL=62, LSE_LLINE=67, LSE_RLINE=76 */ ;   // c:/users/garre/repos/gw4302/cpld/reg.v(135[8] 147[4])
    defparam CA_12__605.GSR = "ENABLED";
    FD1S3IX CA_11__606 (.D(n306[3]), .CK(PHI2_N_571), .CD(n3913), .Q(CA[11])) /* synthesis LSE_LINE_FILE_ID=6, LSE_LCOL=9, LSE_RCOL=62, LSE_LLINE=67, LSE_RLINE=76 */ ;   // c:/users/garre/repos/gw4302/cpld/reg.v(135[8] 147[4])
    defparam CA_11__606.GSR = "ENABLED";
    FD1S3IX CA_10__607 (.D(n306[2]), .CK(PHI2_N_571), .CD(n3914), .Q(CA[10])) /* synthesis LSE_LINE_FILE_ID=6, LSE_LCOL=9, LSE_RCOL=62, LSE_LLINE=67, LSE_RLINE=76 */ ;   // c:/users/garre/repos/gw4302/cpld/reg.v(135[8] 147[4])
    defparam CA_10__607.GSR = "ENABLED";
    FD1S3IX CA_9__608 (.D(n306[1]), .CK(PHI2_N_571), .CD(n3914), .Q(CA[9])) /* synthesis LSE_LINE_FILE_ID=6, LSE_LCOL=9, LSE_RCOL=62, LSE_LLINE=67, LSE_RLINE=76 */ ;   // c:/users/garre/repos/gw4302/cpld/reg.v(135[8] 147[4])
    defparam CA_9__608.GSR = "ENABLED";
    FD1S3IX CA_8__609 (.D(n306[0]), .CK(PHI2_N_571), .CD(n3914), .Q(CA[8])) /* synthesis LSE_LINE_FILE_ID=6, LSE_LCOL=9, LSE_RCOL=62, LSE_LLINE=67, LSE_RLINE=76 */ ;   // c:/users/garre/repos/gw4302/cpld/reg.v(135[8] 147[4])
    defparam CA_8__609.GSR = "ENABLED";
    FD1S3IX REUA_7__618 (.D(n305[7]), .CK(PHI2_N_571), .CD(n3913), .Q(REUA[7])) /* synthesis LSE_LINE_FILE_ID=6, LSE_LCOL=9, LSE_RCOL=62, LSE_LLINE=67, LSE_RLINE=76 */ ;   // c:/users/garre/repos/gw4302/cpld/reg.v(150[8] 162[4])
    defparam REUA_7__618.GSR = "ENABLED";
    FD1P3IX CAWritten_1__600 (.D(D_out_1), .SP(PHI2_N_571_enable_69), .CD(n3914), 
            .CK(PHI2_N_571), .Q(CAWritten[1])) /* synthesis LSE_LINE_FILE_ID=6, LSE_LCOL=9, LSE_RCOL=62, LSE_LLINE=67, LSE_RLINE=76 */ ;   // c:/users/garre/repos/gw4302/cpld/reg.v(122[8] 134[4])
    defparam CAWritten_1__600.GSR = "ENABLED";
    LUT4 XferType_1__I_0_i1_3_lut_4_lut (.A(n3651), .B(n3639), .C(D_out_0), 
         .D(XferType[0]), .Z(\XferType[0] )) /* synthesis lut_function=(A (D)+!A (B (D)+!B (C))) */ ;
    defparam XferType_1__I_0_i1_3_lut_4_lut.init = 16'hfe10;
    FD1P3IX REUAWritten_15__642 (.D(D_out_7), .SP(PHI2_N_571_enable_67), 
            .CD(n3913), .CK(PHI2_N_571), .Q(REUAWritten[15])) /* synthesis LSE_LINE_FILE_ID=6, LSE_LCOL=9, LSE_RCOL=62, LSE_LLINE=67, LSE_RLINE=76 */ ;   // c:/users/garre/repos/gw4302/cpld/reg.v(163[8] 175[4])
    defparam REUAWritten_15__642.GSR = "ENABLED";
    FD1P3AX FF00DecodeEN_583 (.D(n3222), .SP(PHI2_N_571_enable_57), .CK(PHI2_N_571), 
            .Q(FF00DecodeEN)) /* synthesis LSE_LINE_FILE_ID=6, LSE_LCOL=9, LSE_RCOL=62, LSE_LLINE=67, LSE_RLINE=76 */ ;   // c:/users/garre/repos/gw4302/cpld/reg.v(96[8] 115[4])
    defparam FF00DecodeEN_583.GSR = "ENABLED";
    LUT4 mux_175_i7_3_lut_4_lut (.A(n3653), .B(n2252), .C(D_out_6), .D(REUAOut_7__N_193[6]), 
         .Z(n305[6])) /* synthesis lut_function=(A (D)+!A (B (D)+!B (C))) */ ;
    defparam mux_175_i7_3_lut_4_lut.init = 16'hfe10;
    FD1P3AX LengthWritten_8__692 (.D(n1228), .SP(PHI2_N_571_enable_31), 
            .CK(PHI2_N_571), .Q(LengthWritten[8])) /* synthesis LSE_LINE_FILE_ID=6, LSE_LCOL=9, LSE_RCOL=62, LSE_LLINE=67, LSE_RLINE=76 */ ;   // c:/users/garre/repos/gw4302/cpld/reg.v(205[8] 217[4])
    defparam LengthWritten_8__692.GSR = "ENABLED";
    FD1P3IX IncMode__i0 (.D(D_out_6), .SP(PHI2_N_571_enable_77), .CD(n3913), 
            .CK(PHI2_N_571), .Q(IncMode[0])) /* synthesis LSE_LINE_FILE_ID=6, LSE_LCOL=9, LSE_RCOL=62, LSE_LLINE=67, LSE_RLINE=76 */ ;   // c:/users/garre/repos/gw4302/cpld/reg.v(234[8] 237[4])
    defparam IncMode__i0.GSR = "ENABLED";
    LUT4 n360_bdd_4_lut (.A(n340[0]), .B(XferType[0]), .C(A_out_1), .D(A_out_0), 
         .Z(n3485)) /* synthesis lut_function=(A (B (C+(D))+!B (C))+!A !((C+!(D))+!B)) */ ;
    defparam n360_bdd_4_lut.init = 16'haca0;
    FD1P3IX REUA_20__653 (.D(D_out_4), .SP(PHI2_N_571_enable_74), .CD(n3914), 
            .CK(PHI2_N_571), .Q(REUA[20])) /* synthesis LSE_LINE_FILE_ID=6, LSE_LCOL=9, LSE_RCOL=62, LSE_LLINE=67, LSE_RLINE=76 */ ;   // c:/users/garre/repos/gw4302/cpld/reg.v(176[8] 189[4])
    defparam REUA_20__653.GSR = "ENABLED";
    FD1P3IX REUA_21__652 (.D(D_out_5), .SP(PHI2_N_571_enable_74), .CD(n3914), 
            .CK(PHI2_N_571), .Q(REUA[21])) /* synthesis LSE_LINE_FILE_ID=6, LSE_LCOL=9, LSE_RCOL=62, LSE_LLINE=67, LSE_RLINE=76 */ ;   // c:/users/garre/repos/gw4302/cpld/reg.v(176[8] 189[4])
    defparam REUA_21__652.GSR = "ENABLED";
    LUT4 mux_175_i6_3_lut_4_lut (.A(n3653), .B(n2252), .C(D_out_5), .D(REUAOut_7__N_193[5]), 
         .Z(n305[5])) /* synthesis lut_function=(A (D)+!A (B (D)+!B (C))) */ ;
    defparam mux_175_i6_3_lut_4_lut.init = 16'hfe10;
    FD1P3AX LengthWritten_9__691 (.D(n1226), .SP(PHI2_N_571_enable_31), 
            .CK(PHI2_N_571), .Q(LengthWritten[9])) /* synthesis LSE_LINE_FILE_ID=6, LSE_LCOL=9, LSE_RCOL=62, LSE_LLINE=67, LSE_RLINE=76 */ ;   // c:/users/garre/repos/gw4302/cpld/reg.v(205[8] 217[4])
    defparam LengthWritten_9__691.GSR = "ENABLED";
    LUT4 mux_175_i5_3_lut_4_lut (.A(n3653), .B(n2252), .C(D_out_4), .D(REUAOut_7__N_193[4]), 
         .Z(n305[4])) /* synthesis lut_function=(A (D)+!A (B (D)+!B (C))) */ ;
    defparam mux_175_i5_3_lut_4_lut.init = 16'hfe10;
    FD1P3IX REUAWritten_1__632 (.D(D_out_1), .SP(PHI2_N_571_enable_43), 
            .CD(n3914), .CK(PHI2_N_571), .Q(REUAWritten[1])) /* synthesis LSE_LINE_FILE_ID=6, LSE_LCOL=9, LSE_RCOL=62, LSE_LLINE=67, LSE_RLINE=76 */ ;   // c:/users/garre/repos/gw4302/cpld/reg.v(150[8] 162[4])
    defparam REUAWritten_1__632.GSR = "ENABLED";
    LUT4 mux_175_i4_3_lut_4_lut (.A(n3653), .B(n2252), .C(D_out_3), .D(REUAOut_7__N_193[3]), 
         .Z(n305[3])) /* synthesis lut_function=(A (D)+!A (B (D)+!B (C))) */ ;
    defparam mux_175_i4_3_lut_4_lut.init = 16'hfe10;
    FD1S3IX REUA_6__619 (.D(n305[6]), .CK(PHI2_N_571), .CD(n3913), .Q(REUA[6])) /* synthesis LSE_LINE_FILE_ID=6, LSE_LCOL=9, LSE_RCOL=62, LSE_LLINE=67, LSE_RLINE=76 */ ;   // c:/users/garre/repos/gw4302/cpld/reg.v(150[8] 162[4])
    defparam REUA_6__619.GSR = "ENABLED";
    LUT4 Execute_I_0_4_lut (.A(n33), .B(D_out_4), .C(n34), .D(n3630), 
         .Z(Execute)) /* synthesis lut_function=(A (B (C+(D))+!B (C))+!A (B (D))) */ ;   // c:/users/garre/repos/gw4302/cpld/reg.v(242[2] 245[45])
    defparam Execute_I_0_4_lut.init = 16'heca0;
    LUT4 mux_175_i3_3_lut_4_lut (.A(n3653), .B(n2252), .C(D_out_2), .D(REUAOut_7__N_193[2]), 
         .Z(n305[2])) /* synthesis lut_function=(A (D)+!A (B (D)+!B (C))) */ ;
    defparam mux_175_i3_3_lut_4_lut.init = 16'hfe10;
    LUT4 mux_175_i2_3_lut_4_lut (.A(n3653), .B(n2252), .C(D_out_1), .D(REUAOut_7__N_193[1]), 
         .Z(n305[1])) /* synthesis lut_function=(A (D)+!A (B (D)+!B (C))) */ ;
    defparam mux_175_i2_3_lut_4_lut.init = 16'hfe10;
    FD1S3IX REUA_5__620 (.D(n305[5]), .CK(PHI2_N_571), .CD(n3914), .Q(REUA[5])) /* synthesis LSE_LINE_FILE_ID=6, LSE_LCOL=9, LSE_RCOL=62, LSE_LLINE=67, LSE_RLINE=76 */ ;   // c:/users/garre/repos/gw4302/cpld/reg.v(150[8] 162[4])
    defparam REUA_5__620.GSR = "ENABLED";
    FD1S3IX REUA_4__621 (.D(n305[4]), .CK(PHI2_N_571), .CD(n3913), .Q(REUA[4])) /* synthesis LSE_LINE_FILE_ID=6, LSE_LCOL=9, LSE_RCOL=62, LSE_LLINE=67, LSE_RLINE=76 */ ;   // c:/users/garre/repos/gw4302/cpld/reg.v(150[8] 162[4])
    defparam REUA_4__621.GSR = "ENABLED";
    FD1S3IX REUA_3__622 (.D(n305[3]), .CK(PHI2_N_571), .CD(n3914), .Q(REUA[3])) /* synthesis LSE_LINE_FILE_ID=6, LSE_LCOL=9, LSE_RCOL=62, LSE_LLINE=67, LSE_RLINE=76 */ ;   // c:/users/garre/repos/gw4302/cpld/reg.v(150[8] 162[4])
    defparam REUA_3__622.GSR = "ENABLED";
    FD1S3IX REUA_2__623 (.D(n305[2]), .CK(PHI2_N_571), .CD(n3914), .Q(REUA[2])) /* synthesis LSE_LINE_FILE_ID=6, LSE_LCOL=9, LSE_RCOL=62, LSE_LLINE=67, LSE_RLINE=76 */ ;   // c:/users/garre/repos/gw4302/cpld/reg.v(150[8] 162[4])
    defparam REUA_2__623.GSR = "ENABLED";
    FD1S3IX REUA_1__624 (.D(n305[1]), .CK(PHI2_N_571), .CD(n3914), .Q(REUA[1])) /* synthesis LSE_LINE_FILE_ID=6, LSE_LCOL=9, LSE_RCOL=62, LSE_LLINE=67, LSE_RLINE=76 */ ;   // c:/users/garre/repos/gw4302/cpld/reg.v(150[8] 162[4])
    defparam REUA_1__624.GSR = "ENABLED";
    FD1S3IX REUA_0__625 (.D(n305[0]), .CK(PHI2_N_571), .CD(n3913), .Q(REUA[0])) /* synthesis LSE_LINE_FILE_ID=6, LSE_LCOL=9, LSE_RCOL=62, LSE_LLINE=67, LSE_RLINE=76 */ ;   // c:/users/garre/repos/gw4302/cpld/reg.v(150[8] 162[4])
    defparam REUA_0__625.GSR = "ENABLED";
    LUT4 mux_175_i1_3_lut_4_lut (.A(n3653), .B(n2252), .C(D_out_0), .D(REUAOut_7__N_193[0]), 
         .Z(n305[0])) /* synthesis lut_function=(A (D)+!A (B (D)+!B (C))) */ ;
    defparam mux_175_i1_3_lut_4_lut.init = 16'hfe10;
    FD1S3IX REUA_15__634 (.D(n304[7]), .CK(PHI2_N_571), .CD(n3913), .Q(REUA[15])) /* synthesis LSE_LINE_FILE_ID=6, LSE_LCOL=9, LSE_RCOL=62, LSE_LLINE=67, LSE_RLINE=76 */ ;   // c:/users/garre/repos/gw4302/cpld/reg.v(163[8] 175[4])
    defparam REUA_15__634.GSR = "ENABLED";
    FD1P3AX LengthWritten_10__690 (.D(n1224), .SP(PHI2_N_571_enable_31), 
            .CK(PHI2_N_571), .Q(LengthWritten[10])) /* synthesis LSE_LINE_FILE_ID=6, LSE_LCOL=9, LSE_RCOL=62, LSE_LLINE=67, LSE_RLINE=76 */ ;   // c:/users/garre/repos/gw4302/cpld/reg.v(205[8] 217[4])
    defparam LengthWritten_10__690.GSR = "ENABLED";
    LUT4 i265_2_lut_rep_63_3_lut_4_lut (.A(n3643), .B(n3642), .C(n3912), 
         .D(n3651), .Z(PHI2_N_571_enable_76)) /* synthesis lut_function=(A (C)+!A (B (C)+!B (C+!(D)))) */ ;
    defparam i265_2_lut_rep_63_3_lut_4_lut.init = 16'hf0f1;
    FD1P3IX REUAWritten_14__643 (.D(D_out_6), .SP(PHI2_N_571_enable_67), 
            .CD(n3913), .CK(PHI2_N_571), .Q(REUAWritten[14])) /* synthesis LSE_LINE_FILE_ID=6, LSE_LCOL=9, LSE_RCOL=62, LSE_LLINE=67, LSE_RLINE=76 */ ;   // c:/users/garre/repos/gw4302/cpld/reg.v(163[8] 175[4])
    defparam REUAWritten_14__643.GSR = "ENABLED";
    FD1P3AX LengthWritten_11__689 (.D(n1222), .SP(PHI2_N_571_enable_31), 
            .CK(PHI2_N_571), .Q(LengthWritten[11])) /* synthesis LSE_LINE_FILE_ID=6, LSE_LCOL=9, LSE_RCOL=62, LSE_LLINE=67, LSE_RLINE=76 */ ;   // c:/users/garre/repos/gw4302/cpld/reg.v(205[8] 217[4])
    defparam LengthWritten_11__689.GSR = "ENABLED";
    LUT4 mux_755_i7_3_lut_4_lut (.A(n3624), .B(n3637), .C(LengthWritten[14]), 
         .D(Length_15__N_396[6]), .Z(n928[6])) /* synthesis lut_function=(A (C)+!A (B (C)+!B (D))) */ ;   // c:/users/garre/repos/gw4302/cpld/reg.v(212[15:50])
    defparam mux_755_i7_3_lut_4_lut.init = 16'hf1e0;
    FD1P3AX LengthWritten_12__688 (.D(n1220), .SP(PHI2_N_571_enable_31), 
            .CK(PHI2_N_571), .Q(LengthWritten[12])) /* synthesis LSE_LINE_FILE_ID=6, LSE_LCOL=9, LSE_RCOL=62, LSE_LLINE=67, LSE_RLINE=76 */ ;   // c:/users/garre/repos/gw4302/cpld/reg.v(205[8] 217[4])
    defparam LengthWritten_12__688.GSR = "ENABLED";
    LUT4 i3177_2_lut_3_lut_4_lut (.A(n3643), .B(n3642), .C(n1220), .D(n3651), 
         .Z(n3222)) /* synthesis lut_function=(!(A+(B+(C+(D))))) */ ;
    defparam i3177_2_lut_3_lut_4_lut.init = 16'h0001;
    LUT4 Length_15__I_83_3_lut_4_lut (.A(n3653), .B(n3640), .C(D_out_7), 
         .D(n928[7]), .Z(Length_15__N_393)) /* synthesis lut_function=(A (D)+!A (B (D)+!B (C))) */ ;
    defparam Length_15__I_83_3_lut_4_lut.init = 16'hfe10;
    LUT4 mux_755_i8_3_lut_4_lut (.A(n3624), .B(n3637), .C(LengthWritten[15]), 
         .D(Length_15__N_396[7]), .Z(n928[7])) /* synthesis lut_function=(A (C)+!A (B (C)+!B (D))) */ ;   // c:/users/garre/repos/gw4302/cpld/reg.v(212[15:50])
    defparam mux_755_i8_3_lut_4_lut.init = 16'hf1e0;
    FD1P3IX CAWritten_2__599 (.D(D_out_2), .SP(PHI2_N_571_enable_69), .CD(n3913), 
            .CK(PHI2_N_571), .Q(CAWritten[2])) /* synthesis LSE_LINE_FILE_ID=6, LSE_LCOL=9, LSE_RCOL=62, LSE_LLINE=67, LSE_RLINE=76 */ ;   // c:/users/garre/repos/gw4302/cpld/reg.v(122[8] 134[4])
    defparam CAWritten_2__599.GSR = "ENABLED";
    LUT4 i1_2_lut_rep_65_3_lut_4_lut (.A(n3643), .B(n3642), .C(D_out_7), 
         .D(n3651), .Z(n3630)) /* synthesis lut_function=(!(A+(B+((D)+!C)))) */ ;
    defparam i1_2_lut_rep_65_3_lut_4_lut.init = 16'h0010;
    FD1P3IX CAWritten_3__598 (.D(D_out_3), .SP(PHI2_N_571_enable_69), .CD(n3913), 
            .CK(PHI2_N_571), .Q(CAWritten[3])) /* synthesis LSE_LINE_FILE_ID=6, LSE_LCOL=9, LSE_RCOL=62, LSE_LLINE=67, LSE_RLINE=76 */ ;   // c:/users/garre/repos/gw4302/cpld/reg.v(122[8] 134[4])
    defparam CAWritten_3__598.GSR = "ENABLED";
    LUT4 i1_2_lut_3_lut_4_lut (.A(n3651), .B(n3639), .C(n3912), .D(D_out_7), 
         .Z(n3100)) /* synthesis lut_function=(!(A+(B+(C+!(D))))) */ ;
    defparam i1_2_lut_3_lut_4_lut.init = 16'h0100;
    LUT4 i282_2_lut_3_lut_4_lut (.A(n3643), .B(n3642), .C(n3912), .D(n3655), 
         .Z(PHI2_N_571_enable_69)) /* synthesis lut_function=(A (C)+!A (B (C)+!B (C+!(D)))) */ ;
    defparam i282_2_lut_3_lut_4_lut.init = 16'hf0f1;
    FD1P3IX EndBlock_578 (.D(n3315), .SP(IncCA_N_631), .CD(n1159), .CK(PHI2_N_571), 
            .Q(EndBlock)) /* synthesis LSE_LINE_FILE_ID=6, LSE_LCOL=9, LSE_RCOL=62, LSE_LLINE=67, LSE_RLINE=76 */ ;   // c:/users/garre/repos/gw4302/cpld/reg.v(81[8] 92[4])
    defparam EndBlock_578.GSR = "ENABLED";
    LUT4 n359_bdd_3_lut_3306_4_lut (.A(A_out_3), .B(A_out_1), .C(n364[1]), 
         .D(n352[1]), .Z(n3478)) /* synthesis lut_function=(A (C)+!A (B (C)+!B (D))) */ ;
    defparam n359_bdd_3_lut_3306_4_lut.init = 16'hf1e0;
    FD1P3AX LengthWritten_13__687 (.D(n1218), .SP(PHI2_N_571_enable_31), 
            .CK(PHI2_N_571), .Q(LengthWritten[13])) /* synthesis LSE_LINE_FILE_ID=6, LSE_LCOL=9, LSE_RCOL=62, LSE_LLINE=67, LSE_RLINE=76 */ ;   // c:/users/garre/repos/gw4302/cpld/reg.v(205[8] 217[4])
    defparam LengthWritten_13__687.GSR = "ENABLED";
    FD1P3AX LengthWritten_14__686 (.D(n1216), .SP(PHI2_N_571_enable_31), 
            .CK(PHI2_N_571), .Q(LengthWritten[14])) /* synthesis LSE_LINE_FILE_ID=6, LSE_LCOL=9, LSE_RCOL=62, LSE_LLINE=67, LSE_RLINE=76 */ ;   // c:/users/garre/repos/gw4302/cpld/reg.v(205[8] 217[4])
    defparam LengthWritten_14__686.GSR = "ENABLED";
    PFUMX i3087 (.BLUT(n324[5]), .ALUT(n340[5]), .C0(A_out_1), .Z(n3303));
    FD1P3AX LengthWritten_15__685 (.D(n1214), .SP(PHI2_N_571_enable_31), 
            .CK(PHI2_N_571), .Q(LengthWritten[15])) /* synthesis LSE_LINE_FILE_ID=6, LSE_LCOL=9, LSE_RCOL=62, LSE_LLINE=67, LSE_RLINE=76 */ ;   // c:/users/garre/repos/gw4302/cpld/reg.v(205[8] 217[4])
    defparam LengthWritten_15__685.GSR = "ENABLED";
    FD1P3AX LengthWritten_0__676 (.D(n1228), .SP(PHI2_N_571_enable_73), 
            .CK(PHI2_N_571), .Q(LengthWritten[0])) /* synthesis LSE_LINE_FILE_ID=6, LSE_LCOL=9, LSE_RCOL=62, LSE_LLINE=67, LSE_RLINE=76 */ ;   // c:/users/garre/repos/gw4302/cpld/reg.v(192[8] 204[4])
    defparam LengthWritten_0__676.GSR = "ENABLED";
    FD1P3IX REUAWritten_2__631 (.D(D_out_2), .SP(PHI2_N_571_enable_43), 
            .CD(n3913), .CK(PHI2_N_571), .Q(REUAWritten[2])) /* synthesis LSE_LINE_FILE_ID=6, LSE_LCOL=9, LSE_RCOL=62, LSE_LLINE=67, LSE_RLINE=76 */ ;   // c:/users/garre/repos/gw4302/cpld/reg.v(150[8] 162[4])
    defparam REUAWritten_2__631.GSR = "ENABLED";
    FD1S3IX REUA_14__635 (.D(n304[6]), .CK(PHI2_N_571), .CD(n3914), .Q(REUA[14])) /* synthesis LSE_LINE_FILE_ID=6, LSE_LCOL=9, LSE_RCOL=62, LSE_LLINE=67, LSE_RLINE=76 */ ;   // c:/users/garre/repos/gw4302/cpld/reg.v(163[8] 175[4])
    defparam REUA_14__635.GSR = "ENABLED";
    FD1S3IX REUA_13__636 (.D(n304[5]), .CK(PHI2_N_571), .CD(n3914), .Q(REUA[13])) /* synthesis LSE_LINE_FILE_ID=6, LSE_LCOL=9, LSE_RCOL=62, LSE_LLINE=67, LSE_RLINE=76 */ ;   // c:/users/garre/repos/gw4302/cpld/reg.v(163[8] 175[4])
    defparam REUA_13__636.GSR = "ENABLED";
    FD1S3IX REUA_12__637 (.D(n304[4]), .CK(PHI2_N_571), .CD(n3913), .Q(REUA[12])) /* synthesis LSE_LINE_FILE_ID=6, LSE_LCOL=9, LSE_RCOL=62, LSE_LLINE=67, LSE_RLINE=76 */ ;   // c:/users/garre/repos/gw4302/cpld/reg.v(163[8] 175[4])
    defparam REUA_12__637.GSR = "ENABLED";
    FD1S3IX REUA_11__638 (.D(n304[3]), .CK(PHI2_N_571), .CD(n3913), .Q(REUA[11])) /* synthesis LSE_LINE_FILE_ID=6, LSE_LCOL=9, LSE_RCOL=62, LSE_LLINE=67, LSE_RLINE=76 */ ;   // c:/users/garre/repos/gw4302/cpld/reg.v(163[8] 175[4])
    defparam REUA_11__638.GSR = "ENABLED";
    FD1S3IX REUA_10__639 (.D(n304[2]), .CK(PHI2_N_571), .CD(n3913), .Q(REUA[10])) /* synthesis LSE_LINE_FILE_ID=6, LSE_LCOL=9, LSE_RCOL=62, LSE_LLINE=67, LSE_RLINE=76 */ ;   // c:/users/garre/repos/gw4302/cpld/reg.v(163[8] 175[4])
    defparam REUA_10__639.GSR = "ENABLED";
    FD1S3IX REUA_9__640 (.D(n304[1]), .CK(PHI2_N_571), .CD(n3913), .Q(REUA[9])) /* synthesis LSE_LINE_FILE_ID=6, LSE_LCOL=9, LSE_RCOL=62, LSE_LLINE=67, LSE_RLINE=76 */ ;   // c:/users/garre/repos/gw4302/cpld/reg.v(163[8] 175[4])
    defparam REUA_9__640.GSR = "ENABLED";
    FD1S3IX REUA_8__641 (.D(n304[0]), .CK(PHI2_N_571), .CD(n3914), .Q(REUA[8])) /* synthesis LSE_LINE_FILE_ID=6, LSE_LCOL=9, LSE_RCOL=62, LSE_LLINE=67, LSE_RLINE=76 */ ;   // c:/users/garre/repos/gw4302/cpld/reg.v(163[8] 175[4])
    defparam REUA_8__641.GSR = "ENABLED";
    LUT4 i2203_4_lut (.A(A_out_4), .B(A_out_3), .C(n3656), .D(A_out_2), 
         .Z(n2076)) /* synthesis lut_function=(A+(B (C+(D)))) */ ;
    defparam i2203_4_lut.init = 16'heeea;
    FD1P3IX REUAWritten_3__630 (.D(D_out_3), .SP(PHI2_N_571_enable_43), 
            .CD(n3914), .CK(PHI2_N_571), .Q(REUAWritten[3])) /* synthesis LSE_LINE_FILE_ID=6, LSE_LCOL=9, LSE_RCOL=62, LSE_LLINE=67, LSE_RLINE=76 */ ;   // c:/users/garre/repos/gw4302/cpld/reg.v(150[8] 162[4])
    defparam REUAWritten_3__630.GSR = "ENABLED";
    LUT4 i302_2_lut_3_lut_4_lut (.A(n3643), .B(n3642), .C(n3912), .D(n3656), 
         .Z(PHI2_N_571_enable_64)) /* synthesis lut_function=(A (C)+!A (B (C)+!B (C+(D)))) */ ;
    defparam i302_2_lut_3_lut_4_lut.init = 16'hf1f0;
    PFUMX i3084 (.BLUT(n324[4]), .ALUT(n340[4]), .C0(A_out_1), .Z(n3300));
    LUT4 i955_4_lut (.A(n3644), .B(n3912), .C(n3653), .D(n3642), .Z(n1159)) /* synthesis lut_function=(A (B+!(C+(D)))+!A (B)) */ ;   // c:/users/garre/repos/gw4302/cpld/reg.v(81[8] 92[4])
    defparam i955_4_lut.init = 16'hccce;
    FD1S3IX XferType__i0 (.D(\XferType[0] ), .CK(PHI2_N_571), .CD(n3914), 
            .Q(XferType[0])) /* synthesis LSE_LINE_FILE_ID=6, LSE_LCOL=9, LSE_RCOL=62, LSE_LLINE=67, LSE_RLINE=76 */ ;   // c:/users/garre/repos/gw4302/cpld/reg.v(96[8] 115[4])
    defparam XferType__i0.GSR = "ENABLED";
    FD1P3IX REUAWritten_4__629 (.D(D_out_4), .SP(PHI2_N_571_enable_43), 
            .CD(n3913), .CK(PHI2_N_571), .Q(REUAWritten[4])) /* synthesis LSE_LINE_FILE_ID=6, LSE_LCOL=9, LSE_RCOL=62, LSE_LLINE=67, LSE_RLINE=76 */ ;   // c:/users/garre/repos/gw4302/cpld/reg.v(150[8] 162[4])
    defparam REUAWritten_4__629.GSR = "ENABLED";
    FD1P3IX REUAWritten_6__627 (.D(D_out_6), .SP(PHI2_N_571_enable_43), 
            .CD(n3913), .CK(PHI2_N_571), .Q(REUAWritten[6])) /* synthesis LSE_LINE_FILE_ID=6, LSE_LCOL=9, LSE_RCOL=62, LSE_LLINE=67, LSE_RLINE=76 */ ;   // c:/users/garre/repos/gw4302/cpld/reg.v(150[8] 162[4])
    defparam REUAWritten_6__627.GSR = "ENABLED";
    FD1P3IX REUAWritten_16__660 (.D(D_out_0), .SP(PHI2_N_571_enable_74), 
            .CD(n3913), .CK(PHI2_N_571), .Q(REUAWritten[16])) /* synthesis LSE_LINE_FILE_ID=6, LSE_LCOL=9, LSE_RCOL=62, LSE_LLINE=67, LSE_RLINE=76 */ ;   // c:/users/garre/repos/gw4302/cpld/reg.v(176[8] 189[4])
    defparam REUAWritten_16__660.GSR = "ENABLED";
    FD1P3IX IntEnable_693 (.D(D_out_7), .SP(PHI2_N_571_enable_42), .CD(n3913), 
            .CK(PHI2_N_571), .Q(IntEnable)) /* synthesis LSE_LINE_FILE_ID=6, LSE_LCOL=9, LSE_RCOL=62, LSE_LLINE=67, LSE_RLINE=76 */ ;   // c:/users/garre/repos/gw4302/cpld/reg.v(220[8] 230[4])
    defparam IntEnable_693.GSR = "ENABLED";
    FD1S3IX REUA_18__655 (.D(n312[2]), .CK(PHI2_N_571), .CD(n3914), .Q(REUA[18])) /* synthesis LSE_LINE_FILE_ID=6, LSE_LCOL=9, LSE_RCOL=62, LSE_LLINE=67, LSE_RLINE=76 */ ;   // c:/users/garre/repos/gw4302/cpld/reg.v(176[8] 189[4])
    defparam REUA_18__655.GSR = "ENABLED";
    FD1S3IX REUA_17__656 (.D(n312[1]), .CK(PHI2_N_571), .CD(n3914), .Q(REUA[17])) /* synthesis LSE_LINE_FILE_ID=6, LSE_LCOL=9, LSE_RCOL=62, LSE_LLINE=67, LSE_RLINE=76 */ ;   // c:/users/garre/repos/gw4302/cpld/reg.v(176[8] 189[4])
    defparam REUA_17__656.GSR = "ENABLED";
    FD1S3IX REUA_16__657 (.D(n312[0]), .CK(PHI2_N_571), .CD(n3914), .Q(REUA[16])) /* synthesis LSE_LINE_FILE_ID=6, LSE_LCOL=9, LSE_RCOL=62, LSE_LLINE=67, LSE_RLINE=76 */ ;   // c:/users/garre/repos/gw4302/cpld/reg.v(176[8] 189[4])
    defparam REUA_16__657.GSR = "ENABLED";
    FD1P3IX CAWritten_12__613 (.D(D_out_4), .SP(PHI2_N_571_enable_64), .CD(n3914), 
            .CK(PHI2_N_571), .Q(CAWritten[12])) /* synthesis LSE_LINE_FILE_ID=6, LSE_LCOL=9, LSE_RCOL=62, LSE_LLINE=67, LSE_RLINE=76 */ ;   // c:/users/garre/repos/gw4302/cpld/reg.v(135[8] 147[4])
    defparam CAWritten_12__613.GSR = "ENABLED";
    PFUMX i3081 (.BLUT(n324[3]), .ALUT(n340[3]), .C0(A_out_1), .Z(n3297));
    FD1P3AX LengthWritten_1__675 (.D(n1226), .SP(PHI2_N_571_enable_73), 
            .CK(PHI2_N_571), .Q(LengthWritten[1])) /* synthesis LSE_LINE_FILE_ID=6, LSE_LCOL=9, LSE_RCOL=62, LSE_LLINE=67, LSE_RLINE=76 */ ;   // c:/users/garre/repos/gw4302/cpld/reg.v(192[8] 204[4])
    defparam LengthWritten_1__675.GSR = "ENABLED";
    FD1P3IX EndBlockMask_694 (.D(D_out_6), .SP(PHI2_N_571_enable_42), .CD(n3913), 
            .CK(PHI2_N_571), .Q(EndBlockMask)) /* synthesis LSE_LINE_FILE_ID=6, LSE_LCOL=9, LSE_RCOL=62, LSE_LLINE=67, LSE_RLINE=76 */ ;   // c:/users/garre/repos/gw4302/cpld/reg.v(220[8] 230[4])
    defparam EndBlockMask_694.GSR = "ENABLED";
    LUT4 mux_219_i8_3_lut (.A(n3314), .B(n409[7]), .C(A_out_3), .Z(n430)) /* synthesis lut_function=(A (B+!(C))+!A (B (C))) */ ;   // c:/users/garre/repos/gw4302/cpld/reg.v(67[2] 78[7])
    defparam mux_219_i8_3_lut.init = 16'hcaca;
    LUT4 mux_215_i8_3_lut (.A(n376[7]), .B(IncMode[1]), .C(A_out_1), .Z(n409[7])) /* synthesis lut_function=(A (B+!(C))+!A (B (C))) */ ;   // c:/users/garre/repos/gw4302/cpld/reg.v(67[2] 78[7])
    defparam mux_215_i8_3_lut.init = 16'hcaca;
    LUT4 mux_206_i8_3_lut (.A(Length[15]), .B(IntEnable), .C(A_out_0), 
         .Z(n376[7])) /* synthesis lut_function=(A (B+!(C))+!A (B (C))) */ ;   // c:/users/garre/repos/gw4302/cpld/reg.v(67[2] 78[7])
    defparam mux_206_i8_3_lut.init = 16'hcaca;
    FD1P3IX FaultMask_695 (.D(D_out_5), .SP(PHI2_N_571_enable_42), .CD(n3913), 
            .CK(PHI2_N_571), .Q(FaultMask)) /* synthesis LSE_LINE_FILE_ID=6, LSE_LCOL=9, LSE_RCOL=62, LSE_LLINE=67, LSE_RLINE=76 */ ;   // c:/users/garre/repos/gw4302/cpld/reg.v(220[8] 230[4])
    defparam FaultMask_695.GSR = "ENABLED";
    FD1P3IX REUAWritten_7__626 (.D(D_out_7), .SP(PHI2_N_571_enable_43), 
            .CD(n3913), .CK(PHI2_N_571), .Q(REUAWritten[7])) /* synthesis LSE_LINE_FILE_ID=6, LSE_LCOL=9, LSE_RCOL=62, LSE_LLINE=67, LSE_RLINE=76 */ ;   // c:/users/garre/repos/gw4302/cpld/reg.v(150[8] 162[4])
    defparam REUAWritten_7__626.GSR = "ENABLED";
    FD1P3JX Length_4__664 (.D(Length_4__N_456), .SP(PHI2_N_571_enable_75), 
            .PD(n3913), .CK(PHI2_N_571), .Q(Length[4])) /* synthesis LSE_LINE_FILE_ID=6, LSE_LCOL=9, LSE_RCOL=62, LSE_LLINE=67, LSE_RLINE=76 */ ;   // c:/users/garre/repos/gw4302/cpld/reg.v(192[8] 204[4])
    defparam Length_4__664.GSR = "ENABLED";
    FD1P3IX CAWritten_8__617 (.D(D_out_0), .SP(PHI2_N_571_enable_64), .CD(n3913), 
            .CK(PHI2_N_571), .Q(CAWritten[8])) /* synthesis LSE_LINE_FILE_ID=6, LSE_LCOL=9, LSE_RCOL=62, LSE_LLINE=67, LSE_RLINE=76 */ ;   // c:/users/garre/repos/gw4302/cpld/reg.v(135[8] 147[4])
    defparam CAWritten_8__617.GSR = "ENABLED";
    LUT4 i2190_2_lut_rep_67_4_lut (.A(A_out_3), .B(n3650), .C(n3643), 
         .D(n3653), .Z(n3632)) /* synthesis lut_function=((B+(C+(D)))+!A) */ ;   // c:/users/garre/repos/gw4302/cpld/reg.v(76[2:14])
    defparam i2190_2_lut_rep_67_4_lut.init = 16'hfffd;
    FD1P3JX Length_5__663 (.D(Length_5__N_451), .SP(PHI2_N_571_enable_75), 
            .PD(n3913), .CK(PHI2_N_571), .Q(Length[5])) /* synthesis LSE_LINE_FILE_ID=6, LSE_LCOL=9, LSE_RCOL=62, LSE_LLINE=67, LSE_RLINE=76 */ ;   // c:/users/garre/repos/gw4302/cpld/reg.v(192[8] 204[4])
    defparam Length_5__663.GSR = "ENABLED";
    LUT4 n326_bdd_4_lut_3265 (.A(n352[6]), .B(Length[6]), .C(A_out_1), 
         .D(A_out_0), .Z(n3490)) /* synthesis lut_function=(A (B+!(C (D)))+!A (B (C)+!B !((D)+!C))) */ ;
    defparam n326_bdd_4_lut_3265.init = 16'hcafa;
    LUT4 n359_bdd_4_lut (.A(n340[1]), .B(XferType[1]), .C(A_out_1), .D(A_out_0), 
         .Z(n3479)) /* synthesis lut_function=(A (B (C+(D))+!B (C))+!A !((C+!(D))+!B)) */ ;
    defparam n359_bdd_4_lut.init = 16'haca0;
    LUT4 i2186_2_lut_rep_66_3_lut_4_lut (.A(A_out_3), .B(n3650), .C(n3651), 
         .D(n3643), .Z(n3631)) /* synthesis lut_function=(A+(B+(C+(D)))) */ ;   // c:/users/garre/repos/gw4302/cpld/reg.v(76[2:14])
    defparam i2186_2_lut_rep_66_3_lut_4_lut.init = 16'hfffe;
    LUT4 mux_754_i5_3_lut_4_lut (.A(n3624), .B(n3632), .C(LengthWritten[4]), 
         .D(Length_7__N_443[4]), .Z(n927[4])) /* synthesis lut_function=(A (C)+!A (B (D)+!B (C))) */ ;   // c:/users/garre/repos/gw4302/cpld/reg.v(199[15:50])
    defparam mux_754_i5_3_lut_4_lut.init = 16'hf4b0;
    LUT4 Length_8__I_97_3_lut_4_lut (.A(n3653), .B(n3640), .C(D_out_0), 
         .D(n928[0]), .Z(Length_8__N_435)) /* synthesis lut_function=(A (D)+!A (B (D)+!B (C))) */ ;
    defparam Length_8__I_97_3_lut_4_lut.init = 16'hfe10;
    FD1P3AX LengthWritten_2__674 (.D(n1224), .SP(PHI2_N_571_enable_73), 
            .CK(PHI2_N_571), .Q(LengthWritten[2])) /* synthesis LSE_LINE_FILE_ID=6, LSE_LCOL=9, LSE_RCOL=62, LSE_LLINE=67, LSE_RLINE=76 */ ;   // c:/users/garre/repos/gw4302/cpld/reg.v(192[8] 204[4])
    defparam LengthWritten_2__674.GSR = "ENABLED";
    LUT4 Length_9__I_95_3_lut_4_lut (.A(n3653), .B(n3640), .C(D_out_1), 
         .D(n928[1]), .Z(Length_9__N_430)) /* synthesis lut_function=(A (D)+!A (B (D)+!B (C))) */ ;
    defparam Length_9__I_95_3_lut_4_lut.init = 16'hfe10;
    FD1P3IX REUA_22__651 (.D(D_out_6), .SP(PHI2_N_571_enable_74), .CD(n3913), 
            .CK(PHI2_N_571), .Q(REUA[22])) /* synthesis LSE_LINE_FILE_ID=6, LSE_LCOL=9, LSE_RCOL=62, LSE_LLINE=67, LSE_RLINE=76 */ ;   // c:/users/garre/repos/gw4302/cpld/reg.v(176[8] 189[4])
    defparam REUA_22__651.GSR = "ENABLED";
    LUT4 i2188_2_lut_rep_69_3_lut_4_lut (.A(A_out_3), .B(n3650), .C(n3655), 
         .D(n3643), .Z(n3634)) /* synthesis lut_function=(A+(B+(C+(D)))) */ ;   // c:/users/garre/repos/gw4302/cpld/reg.v(76[2:14])
    defparam i2188_2_lut_rep_69_3_lut_4_lut.init = 16'hfffe;
    FD1P3IX REUA_23__650 (.D(D_out_7), .SP(PHI2_N_571_enable_74), .CD(n3913), 
            .CK(PHI2_N_571), .Q(REUA[23])) /* synthesis LSE_LINE_FILE_ID=6, LSE_LCOL=9, LSE_RCOL=62, LSE_LLINE=67, LSE_RLINE=76 */ ;   // c:/users/garre/repos/gw4302/cpld/reg.v(176[8] 189[4])
    defparam REUA_23__650.GSR = "ENABLED";
    LUT4 i1_2_lut_rep_71_3_lut_4_lut (.A(A_out_3), .B(n3650), .C(n3656), 
         .D(n3643), .Z(n3636)) /* synthesis lut_function=(!(A+(B+((D)+!C)))) */ ;   // c:/users/garre/repos/gw4302/cpld/reg.v(76[2:14])
    defparam i1_2_lut_rep_71_3_lut_4_lut.init = 16'h0010;
    FD1P3IX CAWritten_4__597 (.D(D_out_4), .SP(PHI2_N_571_enable_69), .CD(n3913), 
            .CK(PHI2_N_571), .Q(CAWritten[4])) /* synthesis LSE_LINE_FILE_ID=6, LSE_LCOL=9, LSE_RCOL=62, LSE_LLINE=67, LSE_RLINE=76 */ ;   // c:/users/garre/repos/gw4302/cpld/reg.v(122[8] 134[4])
    defparam CAWritten_4__597.GSR = "ENABLED";
    LUT4 Length_10__I_93_3_lut_4_lut (.A(n3653), .B(n3640), .C(D_out_2), 
         .D(n928[2]), .Z(Length_10__N_425)) /* synthesis lut_function=(A (D)+!A (B (D)+!B (C))) */ ;
    defparam Length_10__I_93_3_lut_4_lut.init = 16'hfe10;
    LUT4 mux_754_i8_3_lut_4_lut (.A(n3624), .B(n3632), .C(LengthWritten[7]), 
         .D(Length_7__N_443[7]), .Z(n927[7])) /* synthesis lut_function=(A (C)+!A (B (D)+!B (C))) */ ;   // c:/users/garre/repos/gw4302/cpld/reg.v(199[15:50])
    defparam mux_754_i8_3_lut_4_lut.init = 16'hf4b0;
    LUT4 i3185_4_lut (.A(n17_adj_666), .B(n30), .C(n26), .D(n18), .Z(Length1_N_645)) /* synthesis lut_function=(!(A+(B+(C+(D))))) */ ;   // c:/users/garre/repos/gw4302/cpld/reg.v(52[18:38])
    defparam i3185_4_lut.init = 16'h0001;
    LUT4 mux_194_i1_3_lut (.A(CA[0]), .B(CA[8]), .C(A_out_0), .Z(n340[0])) /* synthesis lut_function=(A (B+!(C))+!A (B (C))) */ ;   // c:/users/garre/repos/gw4302/cpld/reg.v(67[2] 78[7])
    defparam mux_194_i1_3_lut.init = 16'hcaca;
    LUT4 mux_754_i3_3_lut_4_lut (.A(n3624), .B(n3632), .C(LengthWritten[2]), 
         .D(Length_7__N_443[2]), .Z(n927[2])) /* synthesis lut_function=(A (C)+!A (B (D)+!B (C))) */ ;   // c:/users/garre/repos/gw4302/cpld/reg.v(199[15:50])
    defparam mux_754_i3_3_lut_4_lut.init = 16'hf4b0;
    LUT4 i781_2_lut_rep_58 (.A(REUA[16]), .B(REUAOut_18__N_130), .Z(n3623)) /* synthesis lut_function=(A (B)) */ ;   // c:/users/garre/repos/gw4302/cpld/reg.v(187[18:34])
    defparam i781_2_lut_rep_58.init = 16'h8888;
    FD1P3AX LengthWritten_3__673 (.D(n1222), .SP(PHI2_N_571_enable_73), 
            .CK(PHI2_N_571), .Q(LengthWritten[3])) /* synthesis LSE_LINE_FILE_ID=6, LSE_LCOL=9, LSE_RCOL=62, LSE_LLINE=67, LSE_RLINE=76 */ ;   // c:/users/garre/repos/gw4302/cpld/reg.v(192[8] 204[4])
    defparam LengthWritten_3__673.GSR = "ENABLED";
    LUT4 i19_4_lut (.A(n2076), .B(\RAMRDD[2] ), .C(DMA), .D(n3448), 
         .Z(\Dout[2] )) /* synthesis lut_function=(A (B+!(C))+!A (B (C+(D))+!B !(C+!(D)))) */ ;
    defparam i19_4_lut.init = 16'hcfca;
    FD1P3JX Length_6__662 (.D(Length_6__N_446), .SP(PHI2_N_571_enable_75), 
            .PD(n3913), .CK(PHI2_N_571), .Q(Length[6])) /* synthesis LSE_LINE_FILE_ID=6, LSE_LCOL=9, LSE_RCOL=62, LSE_LLINE=67, LSE_RLINE=76 */ ;   // c:/users/garre/repos/gw4302/cpld/reg.v(192[8] 204[4])
    defparam Length_6__662.GSR = "ENABLED";
    FD1P3JX Length_7__661 (.D(Length_7__N_440), .SP(PHI2_N_571_enable_75), 
            .PD(n3913), .CK(PHI2_N_571), .Q(Length[7])) /* synthesis LSE_LINE_FILE_ID=6, LSE_LCOL=9, LSE_RCOL=62, LSE_LLINE=67, LSE_RLINE=76 */ ;   // c:/users/garre/repos/gw4302/cpld/reg.v(192[8] 204[4])
    defparam Length_7__661.GSR = "ENABLED";
    LUT4 Length_11__I_91_3_lut_4_lut (.A(n3653), .B(n3640), .C(D_out_3), 
         .D(n928[3]), .Z(Length_11__N_420)) /* synthesis lut_function=(A (D)+!A (B (D)+!B (C))) */ ;
    defparam Length_11__I_91_3_lut_4_lut.init = 16'hfe10;
    LUT4 mux_194_i2_3_lut (.A(CA[1]), .B(CA[9]), .C(A_out_0), .Z(n340[1])) /* synthesis lut_function=(A (B+!(C))+!A (B (C))) */ ;   // c:/users/garre/repos/gw4302/cpld/reg.v(67[2] 78[7])
    defparam mux_194_i2_3_lut.init = 16'hcaca;
    FD1P3JX Length_0__668 (.D(Length_0__N_476), .SP(PHI2_N_571_enable_75), 
            .PD(n3914), .CK(PHI2_N_571), .Q(Length[0])) /* synthesis LSE_LINE_FILE_ID=6, LSE_LCOL=9, LSE_RCOL=62, LSE_LLINE=67, LSE_RLINE=76 */ ;   // c:/users/garre/repos/gw4302/cpld/reg.v(192[8] 204[4])
    defparam Length_0__668.GSR = "ENABLED";
    LUT4 mux_754_i4_3_lut_4_lut (.A(n3624), .B(n3632), .C(LengthWritten[3]), 
         .D(Length_7__N_443[3]), .Z(n927[3])) /* synthesis lut_function=(A (C)+!A (B (D)+!B (C))) */ ;   // c:/users/garre/repos/gw4302/cpld/reg.v(199[15:50])
    defparam mux_754_i4_3_lut_4_lut.init = 16'hf4b0;
    FD1P3JX Length_1__667 (.D(Length_1__N_471), .SP(PHI2_N_571_enable_75), 
            .PD(n3914), .CK(PHI2_N_571), .Q(Length[1])) /* synthesis LSE_LINE_FILE_ID=6, LSE_LCOL=9, LSE_RCOL=62, LSE_LLINE=67, LSE_RLINE=76 */ ;   // c:/users/garre/repos/gw4302/cpld/reg.v(192[8] 204[4])
    defparam Length_1__667.GSR = "ENABLED";
    LUT4 i1_2_lut (.A(Length[0]), .B(Length[10]), .Z(n17_adj_666)) /* synthesis lut_function=((B)+!A) */ ;   // c:/users/garre/repos/gw4302/cpld/reg.v(52[18:38])
    defparam i1_2_lut.init = 16'hdddd;
    LUT4 i789_2_lut_3_lut (.A(REUA[16]), .B(REUAOut_18__N_130), .C(REUA[17]), 
         .Z(n961)) /* synthesis lut_function=(A (B (C))) */ ;   // c:/users/garre/repos/gw4302/cpld/reg.v(187[18:34])
    defparam i789_2_lut_3_lut.init = 16'h8080;
    LUT4 mux_194_i4_3_lut (.A(CA[3]), .B(CA[11]), .C(A_out_0), .Z(n340[3])) /* synthesis lut_function=(A (B+!(C))+!A (B (C))) */ ;   // c:/users/garre/repos/gw4302/cpld/reg.v(67[2] 78[7])
    defparam mux_194_i4_3_lut.init = 16'hcaca;
    LUT4 mux_173_i3_4_lut (.A(REUA[18]), .B(REUAWritten[18]), .C(n3624), 
         .D(n961), .Z(n303[2])) /* synthesis lut_function=(A (B (C+!(D))+!B !(C+(D)))+!A (B (C+(D))+!B !(C+!(D)))) */ ;   // c:/users/garre/repos/gw4302/cpld/reg.v(187[18:34])
    defparam mux_173_i3_4_lut.init = 16'hc5ca;
    LUT4 i2133_2_lut (.A(DF01Reserved32[3]), .B(A_out_0), .Z(n324[3])) /* synthesis lut_function=(A (B)) */ ;   // c:/users/garre/repos/gw4302/cpld/reg.v(67[2] 78[7])
    defparam i2133_2_lut.init = 16'h8888;
    FD1P3AX ExecuteEN_580 (.D(n3100), .SP(PHI2_N_571_enable_57), .CK(PHI2_N_571), 
            .Q(ExecuteEN)) /* synthesis LSE_LINE_FILE_ID=6, LSE_LCOL=9, LSE_RCOL=62, LSE_LLINE=67, LSE_RLINE=76 */ ;   // c:/users/garre/repos/gw4302/cpld/reg.v(96[8] 115[4])
    defparam ExecuteEN_580.GSR = "ENABLED";
    LUT4 i2089_2_lut (.A(D_out_4), .B(n3912), .Z(n1220)) /* synthesis lut_function=(A+(B)) */ ;   // c:/users/garre/repos/gw4302/cpld/reg.v(205[8] 217[4])
    defparam i2089_2_lut.init = 16'heeee;
    LUT4 Length_12__I_89_3_lut_4_lut (.A(n3653), .B(n3640), .C(D_out_4), 
         .D(n928[4]), .Z(Length_12__N_415)) /* synthesis lut_function=(A (D)+!A (B (D)+!B (C))) */ ;
    defparam Length_12__I_89_3_lut_4_lut.init = 16'hfe10;
    FD1P3AX LengthWritten_4__672 (.D(n1220), .SP(PHI2_N_571_enable_73), 
            .CK(PHI2_N_571), .Q(LengthWritten[4])) /* synthesis LSE_LINE_FILE_ID=6, LSE_LCOL=9, LSE_RCOL=62, LSE_LLINE=67, LSE_RLINE=76 */ ;   // c:/users/garre/repos/gw4302/cpld/reg.v(192[8] 204[4])
    defparam LengthWritten_4__672.GSR = "ENABLED";
    CCU2D REUAOut_15__I_0_3 (.A0(REUAOut_15__N_147), .B0(REUAOut_15__N_149), 
          .C0(REUAWritten[8]), .D0(REUA[8]), .A1(GND_net), .B1(REUAOut_15__N_149), 
          .C1(REUAWritten[9]), .D1(REUA[9]), .CIN(n2906), .COUT(n2907), 
          .S0(REUAOut_15__N_146[0]), .S1(REUAOut_15__N_146[1]));   // c:/users/garre/repos/gw4302/cpld/reg.v(173[17:33])
    defparam REUAOut_15__I_0_3.INIT0 = 16'hd1e2;
    defparam REUAOut_15__I_0_3.INIT1 = 16'h596a;
    defparam REUAOut_15__I_0_3.INJECT1_0 = "NO";
    defparam REUAOut_15__I_0_3.INJECT1_1 = "NO";
    LUT4 mux_186_i8_3_lut (.A(n3646), .B(ExecuteEN), .C(A_out_0), .Z(n324[7])) /* synthesis lut_function=(A (B+!(C))+!A (B (C))) */ ;   // c:/users/garre/repos/gw4302/cpld/reg.v(67[2] 78[7])
    defparam mux_186_i8_3_lut.init = 16'hcaca;
    LUT4 i8_4_lut (.A(n15), .B(n13), .C(REUA[11]), .D(n10), .Z(REUAOut_18__N_130)) /* synthesis lut_function=(A (B (C (D)))) */ ;
    defparam i8_4_lut.init = 16'h8000;
    LUT4 IntEnable_I_0_842_4_lut_rep_81 (.A(IntEnable), .B(EndBlock), .C(IRQ_N_536), 
         .D(EndBlockMask), .Z(n3646)) /* synthesis lut_function=(A (B (C+(D))+!B (C))) */ ;   // c:/users/garre/repos/gw4302/cpld/reg.v(231[14:79])
    defparam IntEnable_I_0_842_4_lut_rep_81.init = 16'ha8a0;
    PFUMX i3462 (.BLUT(n3907), .ALUT(n3908), .C0(A_out_1), .Z(n3909));
    LUT4 IRQ_I_0_1_lut_4_lut (.A(IntEnable), .B(EndBlock), .C(IRQ_N_536), 
         .D(EndBlockMask), .Z(nIRQ_c)) /* synthesis lut_function=(!(A (B (C+(D))+!B (C)))) */ ;   // c:/users/garre/repos/gw4302/cpld/reg.v(231[14:79])
    defparam IRQ_I_0_1_lut_4_lut.init = 16'h575f;
    LUT4 i14_4_lut (.A(Length[14]), .B(n28), .C(n22_c), .D(Length[7]), 
         .Z(n30)) /* synthesis lut_function=(A+(B+(C+(D)))) */ ;   // c:/users/garre/repos/gw4302/cpld/reg.v(52[18:38])
    defparam i14_4_lut.init = 16'hfffe;
    LUT4 i10_4_lut (.A(Length[9]), .B(Length[3]), .C(Length[2]), .D(Length[15]), 
         .Z(n26)) /* synthesis lut_function=(A+(B+(C+(D)))) */ ;   // c:/users/garre/repos/gw4302/cpld/reg.v(52[18:38])
    defparam i10_4_lut.init = 16'hfffe;
    LUT4 mux_194_i5_3_lut (.A(CA[4]), .B(CA[12]), .C(A_out_0), .Z(n340[4])) /* synthesis lut_function=(A (B+!(C))+!A (B (C))) */ ;   // c:/users/garre/repos/gw4302/cpld/reg.v(67[2] 78[7])
    defparam mux_194_i5_3_lut.init = 16'hcaca;
    LUT4 i2109_2_lut (.A(D_out_0), .B(n3912), .Z(n1228)) /* synthesis lut_function=(A+(B)) */ ;   // c:/users/garre/repos/gw4302/cpld/reg.v(205[8] 217[4])
    defparam i2109_2_lut.init = 16'heeee;
    LUT4 i2_2_lut (.A(Length[11]), .B(Length[8]), .Z(n18)) /* synthesis lut_function=(A+(B)) */ ;   // c:/users/garre/repos/gw4302/cpld/reg.v(52[18:38])
    defparam i2_2_lut.init = 16'heeee;
    LUT4 i1_2_lut_adj_165 (.A(n1370), .B(IncMode[1]), .Z(IncCAg)) /* synthesis lut_function=(!((B)+!A)) */ ;
    defparam i1_2_lut_adj_165.init = 16'h2222;
    LUT4 i12_4_lut (.A(Length[1]), .B(Length[13]), .C(Length[6]), .D(Length[4]), 
         .Z(n28)) /* synthesis lut_function=(A+(B+(C+(D)))) */ ;   // c:/users/garre/repos/gw4302/cpld/reg.v(52[18:38])
    defparam i12_4_lut.init = 16'hfffe;
    CCU2D REUAOut_15__I_0_1 (.A0(GND_net), .B0(GND_net), .C0(GND_net), 
          .D0(GND_net), .A1(n3624), .B1(n3638), .C1(GND_net), .D1(GND_net), 
          .COUT(n2906));   // c:/users/garre/repos/gw4302/cpld/reg.v(173[17:33])
    defparam REUAOut_15__I_0_1.INIT0 = 16'hF000;
    defparam REUAOut_15__I_0_1.INIT1 = 16'hffff;
    defparam REUAOut_15__I_0_1.INJECT1_0 = "NO";
    defparam REUAOut_15__I_0_1.INJECT1_1 = "NO";
    LUT4 i2195_2_lut (.A(FF00DecodeEN), .B(A_out_0), .Z(n324[4])) /* synthesis lut_function=(!(A (B))) */ ;
    defparam i2195_2_lut.init = 16'h7777;
    LUT4 mux_194_i6_3_lut (.A(CA[5]), .B(CA[13]), .C(A_out_0), .Z(n340[5])) /* synthesis lut_function=(A (B+!(C))+!A (B (C))) */ ;   // c:/users/garre/repos/gw4302/cpld/reg.v(67[2] 78[7])
    defparam mux_194_i6_3_lut.init = 16'hcaca;
    FD1P3AX LengthWritten_5__671 (.D(n1218), .SP(PHI2_N_571_enable_73), 
            .CK(PHI2_N_571), .Q(LengthWritten[5])) /* synthesis LSE_LINE_FILE_ID=6, LSE_LCOL=9, LSE_RCOL=62, LSE_LLINE=67, LSE_RLINE=76 */ ;   // c:/users/garre/repos/gw4302/cpld/reg.v(192[8] 204[4])
    defparam LengthWritten_5__671.GSR = "ENABLED";
    LUT4 mux_186_i6_3_lut (.A(Fault), .B(AutoloadEN), .C(A_out_0), .Z(n324[5])) /* synthesis lut_function=(A (B+!(C))+!A (B (C))) */ ;   // c:/users/garre/repos/gw4302/cpld/reg.v(67[2] 78[7])
    defparam mux_186_i6_3_lut.init = 16'hcaca;
    LUT4 i6_2_lut (.A(Length[12]), .B(Length[5]), .Z(n22_c)) /* synthesis lut_function=(A+(B)) */ ;   // c:/users/garre/repos/gw4302/cpld/reg.v(52[18:38])
    defparam i6_2_lut.init = 16'heeee;
    LUT4 Fault_I_0_837_2_lut (.A(Fault), .B(FaultMask), .Z(IRQ_N_536)) /* synthesis lut_function=(A (B)) */ ;   // c:/users/garre/repos/gw4302/cpld/reg.v(231[58:78])
    defparam Fault_I_0_837_2_lut.init = 16'h8888;
    L6MUX21 i3243 (.D0(n3486), .D1(n3483), .SD(A_out_3), .Z(n3487));
    LUT4 n11_bdd_4_lut_3208_4_lut_then_4_lut (.A(A_out_3), .B(A_out_2), 
         .C(Length[2]), .D(CA[10]), .Z(n3908)) /* synthesis lut_function=(A+(B (C)+!B (D))) */ ;
    defparam n11_bdd_4_lut_3208_4_lut_then_4_lut.init = 16'hfbea;
    LUT4 n11_bdd_4_lut_3208_4_lut_else_4_lut (.A(A_out_3), .B(A_out_2), 
         .C(REUA[10]), .D(DF01Reserved32[2]), .Z(n3907)) /* synthesis lut_function=(A+(B (C)+!B (D))) */ ;
    defparam n11_bdd_4_lut_3208_4_lut_else_4_lut.init = 16'hfbea;
    LUT4 mux_755_i2_3_lut_4_lut (.A(n3624), .B(n3637), .C(LengthWritten[9]), 
         .D(Length_15__N_396[1]), .Z(n928[1])) /* synthesis lut_function=(A (C)+!A (B (C)+!B (D))) */ ;   // c:/users/garre/repos/gw4302/cpld/reg.v(212[15:50])
    defparam mux_755_i2_3_lut_4_lut.init = 16'hf1e0;
    FD1P3IX CAWritten_5__596 (.D(D_out_5), .SP(PHI2_N_571_enable_69), .CD(n3913), 
            .CK(PHI2_N_571), .Q(CAWritten[5])) /* synthesis LSE_LINE_FILE_ID=6, LSE_LCOL=9, LSE_RCOL=62, LSE_LLINE=67, LSE_RLINE=76 */ ;   // c:/users/garre/repos/gw4302/cpld/reg.v(122[8] 134[4])
    defparam CAWritten_5__596.GSR = "ENABLED";
    FD1P3IX CAWritten_9__616 (.D(D_out_1), .SP(PHI2_N_571_enable_64), .CD(n3913), 
            .CK(PHI2_N_571), .Q(CAWritten[9])) /* synthesis LSE_LINE_FILE_ID=6, LSE_LCOL=9, LSE_RCOL=62, LSE_LLINE=67, LSE_RLINE=76 */ ;   // c:/users/garre/repos/gw4302/cpld/reg.v(135[8] 147[4])
    defparam CAWritten_9__616.GSR = "ENABLED";
    LUT4 i2126_4_lut (.A(Length[13]), .B(A_out_1), .C(FaultMask), .D(A_out_0), 
         .Z(n409[5])) /* synthesis lut_function=(A (B+(C+!(D)))+!A (B+(C (D)))) */ ;   // c:/users/garre/repos/gw4302/cpld/reg.v(67[2] 78[7])
    defparam i2126_4_lut.init = 16'hfcee;
    FD1P3IX CAWritten_10__615 (.D(D_out_2), .SP(PHI2_N_571_enable_64), .CD(n3914), 
            .CK(PHI2_N_571), .Q(CAWritten[10])) /* synthesis LSE_LINE_FILE_ID=6, LSE_LCOL=9, LSE_RCOL=62, LSE_LLINE=67, LSE_RLINE=76 */ ;   // c:/users/garre/repos/gw4302/cpld/reg.v(135[8] 147[4])
    defparam CAWritten_10__615.GSR = "ENABLED";
    LUT4 i6_4_lut (.A(REUA[15]), .B(REUA[14]), .C(REUA[8]), .D(REUA[12]), 
         .Z(n15)) /* synthesis lut_function=(A (B (C (D)))) */ ;
    defparam i6_4_lut.init = 16'h8000;
    FD1P3IX CAWritten_11__614 (.D(D_out_3), .SP(PHI2_N_571_enable_64), .CD(n3914), 
            .CK(PHI2_N_571), .Q(CAWritten[11])) /* synthesis LSE_LINE_FILE_ID=6, LSE_LCOL=9, LSE_RCOL=62, LSE_LLINE=67, LSE_RLINE=76 */ ;   // c:/users/garre/repos/gw4302/cpld/reg.v(135[8] 147[4])
    defparam CAWritten_11__614.GSR = "ENABLED";
    LUT4 Length_13__I_87_3_lut_4_lut (.A(n3653), .B(n3640), .C(D_out_5), 
         .D(n928[5]), .Z(Length_13__N_410)) /* synthesis lut_function=(A (D)+!A (B (D)+!B (C))) */ ;
    defparam Length_13__I_87_3_lut_4_lut.init = 16'hfe10;
    FD1P3IX REUAWritten_8__649 (.D(D_out_0), .SP(PHI2_N_571_enable_67), 
            .CD(n3914), .CK(PHI2_N_571), .Q(REUAWritten[8])) /* synthesis LSE_LINE_FILE_ID=6, LSE_LCOL=9, LSE_RCOL=62, LSE_LLINE=67, LSE_RLINE=76 */ ;   // c:/users/garre/repos/gw4302/cpld/reg.v(163[8] 175[4])
    defparam REUAWritten_8__649.GSR = "ENABLED";
    FD1P3IX REUAWritten_9__648 (.D(D_out_1), .SP(PHI2_N_571_enable_67), 
            .CD(n3914), .CK(PHI2_N_571), .Q(REUAWritten[9])) /* synthesis LSE_LINE_FILE_ID=6, LSE_LCOL=9, LSE_RCOL=62, LSE_LLINE=67, LSE_RLINE=76 */ ;   // c:/users/garre/repos/gw4302/cpld/reg.v(163[8] 175[4])
    defparam REUAWritten_9__648.GSR = "ENABLED";
    FD1P3IX REUAWritten_10__647 (.D(D_out_2), .SP(PHI2_N_571_enable_67), 
            .CD(n3914), .CK(PHI2_N_571), .Q(REUAWritten[10])) /* synthesis LSE_LINE_FILE_ID=6, LSE_LCOL=9, LSE_RCOL=62, LSE_LLINE=67, LSE_RLINE=76 */ ;   // c:/users/garre/repos/gw4302/cpld/reg.v(163[8] 175[4])
    defparam REUAWritten_10__647.GSR = "ENABLED";
    FD1P3IX CAWritten_6__595 (.D(D_out_6), .SP(PHI2_N_571_enable_69), .CD(n3914), 
            .CK(PHI2_N_571), .Q(CAWritten[6])) /* synthesis LSE_LINE_FILE_ID=6, LSE_LCOL=9, LSE_RCOL=62, LSE_LLINE=67, LSE_RLINE=76 */ ;   // c:/users/garre/repos/gw4302/cpld/reg.v(122[8] 134[4])
    defparam CAWritten_6__595.GSR = "ENABLED";
    LUT4 i4_2_lut (.A(REUA[13]), .B(REUA[9]), .Z(n13)) /* synthesis lut_function=(A (B)) */ ;
    defparam i4_2_lut.init = 16'h8888;
    FD1P3IX CAWritten_7__594 (.D(D_out_7), .SP(PHI2_N_571_enable_69), .CD(n3914), 
            .CK(PHI2_N_571), .Q(CAWritten[7])) /* synthesis LSE_LINE_FILE_ID=6, LSE_LCOL=9, LSE_RCOL=62, LSE_LLINE=67, LSE_RLINE=76 */ ;   // c:/users/garre/repos/gw4302/cpld/reg.v(122[8] 134[4])
    defparam CAWritten_7__594.GSR = "ENABLED";
    FD1P3IX DF01Reserved6_581 (.D(D_out_6), .SP(PHI2_N_571_enable_76), .CD(n3914), 
            .CK(PHI2_N_571), .Q(DF01Reserved6)) /* synthesis LSE_LINE_FILE_ID=6, LSE_LCOL=9, LSE_RCOL=62, LSE_LLINE=67, LSE_RLINE=76 */ ;   // c:/users/garre/repos/gw4302/cpld/reg.v(96[8] 115[4])
    defparam DF01Reserved6_581.GSR = "ENABLED";
    FD1P3AX LengthWritten_6__670 (.D(n1216), .SP(PHI2_N_571_enable_73), 
            .CK(PHI2_N_571), .Q(LengthWritten[6])) /* synthesis LSE_LINE_FILE_ID=6, LSE_LCOL=9, LSE_RCOL=62, LSE_LLINE=67, LSE_RLINE=76 */ ;   // c:/users/garre/repos/gw4302/cpld/reg.v(192[8] 204[4])
    defparam LengthWritten_6__670.GSR = "ENABLED";
    FD1P3JX Length_2__666 (.D(Length_2__N_466), .SP(PHI2_N_571_enable_75), 
            .PD(n3913), .CK(PHI2_N_571), .Q(Length[2])) /* synthesis LSE_LINE_FILE_ID=6, LSE_LCOL=9, LSE_RCOL=62, LSE_LLINE=67, LSE_RLINE=76 */ ;   // c:/users/garre/repos/gw4302/cpld/reg.v(192[8] 204[4])
    defparam Length_2__666.GSR = "ENABLED";
    FD1P3AX LengthWritten_7__669 (.D(n1214), .SP(PHI2_N_571_enable_73), 
            .CK(PHI2_N_571), .Q(LengthWritten[7])) /* synthesis LSE_LINE_FILE_ID=6, LSE_LCOL=9, LSE_RCOL=62, LSE_LLINE=67, LSE_RLINE=76 */ ;   // c:/users/garre/repos/gw4302/cpld/reg.v(192[8] 204[4])
    defparam LengthWritten_7__669.GSR = "ENABLED";
    FD1P3IX REUA_19__654 (.D(D_out_3), .SP(PHI2_N_571_enable_74), .CD(n3914), 
            .CK(PHI2_N_571), .Q(REUA[19])) /* synthesis LSE_LINE_FILE_ID=6, LSE_LCOL=9, LSE_RCOL=62, LSE_LLINE=67, LSE_RLINE=76 */ ;   // c:/users/garre/repos/gw4302/cpld/reg.v(176[8] 189[4])
    defparam REUA_19__654.GSR = "ENABLED";
    LUT4 i1_2_lut_adj_166 (.A(REUA[10]), .B(REUAOut_15__N_147), .Z(n10)) /* synthesis lut_function=(A (B)) */ ;
    defparam i1_2_lut_adj_166.init = 16'h8888;
    LUT4 Length_14__I_85_3_lut_4_lut (.A(n3653), .B(n3640), .C(D_out_6), 
         .D(n928[6]), .Z(Length_14__N_405)) /* synthesis lut_function=(A (D)+!A (B (D)+!B (C))) */ ;
    defparam Length_14__I_85_3_lut_4_lut.init = 16'hfe10;
    LUT4 mux_754_i2_3_lut_4_lut (.A(n3624), .B(n3632), .C(LengthWritten[1]), 
         .D(Length_7__N_443[1]), .Z(n927[1])) /* synthesis lut_function=(A (C)+!A (B (D)+!B (C))) */ ;   // c:/users/garre/repos/gw4302/cpld/reg.v(199[15:50])
    defparam mux_754_i2_3_lut_4_lut.init = 16'hf4b0;
    LUT4 mux_202_i2_3_lut (.A(REUA[17]), .B(Length[1]), .C(A_out_0), .Z(n364[1])) /* synthesis lut_function=(A (B+!(C))+!A (B (C))) */ ;   // c:/users/garre/repos/gw4302/cpld/reg.v(67[2] 78[7])
    defparam mux_202_i2_3_lut.init = 16'hcaca;
    PFUMX i3241 (.BLUT(n3485), .ALUT(n3484), .C0(A_out_2), .Z(n3486));
    LUT4 mux_755_i1_3_lut_4_lut (.A(n3624), .B(n3637), .C(LengthWritten[8]), 
         .D(Length_15__N_396[0]), .Z(n928[0])) /* synthesis lut_function=(A (C)+!A (B (C)+!B (D))) */ ;   // c:/users/garre/repos/gw4302/cpld/reg.v(212[15:50])
    defparam mux_755_i1_3_lut_4_lut.init = 16'hf1e0;
    LUT4 mux_754_i6_3_lut_4_lut (.A(n3624), .B(n3632), .C(LengthWritten[5]), 
         .D(Length_7__N_443[5]), .Z(n927[5])) /* synthesis lut_function=(A (C)+!A (B (D)+!B (C))) */ ;   // c:/users/garre/repos/gw4302/cpld/reg.v(199[15:50])
    defparam mux_754_i6_3_lut_4_lut.init = 16'hf4b0;
    FD1P3JX Length_3__665 (.D(Length_3__N_461), .SP(PHI2_N_571_enable_75), 
            .PD(n3913), .CK(PHI2_N_571), .Q(Length[3])) /* synthesis LSE_LINE_FILE_ID=6, LSE_LCOL=9, LSE_RCOL=62, LSE_LLINE=67, LSE_RLINE=76 */ ;   // c:/users/garre/repos/gw4302/cpld/reg.v(192[8] 204[4])
    defparam Length_3__665.GSR = "ENABLED";
    LUT4 i5_2_lut (.A(REUA[1]), .B(REUA[3]), .Z(n15_adj_667)) /* synthesis lut_function=(A (B)) */ ;
    defparam i5_2_lut.init = 16'h8888;
    LUT4 i2049_2_lut (.A(D_out_1), .B(n3912), .Z(n1226)) /* synthesis lut_function=(A+(B)) */ ;   // c:/users/garre/repos/gw4302/cpld/reg.v(205[8] 217[4])
    defparam i2049_2_lut.init = 16'heeee;
    PFUMX i3238 (.BLUT(n352[0]), .ALUT(n3482), .C0(n3654), .Z(n3483));
    LUT4 mux_202_i1_3_lut (.A(REUA[16]), .B(Length[0]), .C(A_out_0), .Z(n364[0])) /* synthesis lut_function=(A (B+!(C))+!A (B (C))) */ ;   // c:/users/garre/repos/gw4302/cpld/reg.v(67[2] 78[7])
    defparam mux_202_i1_3_lut.init = 16'hcaca;
    LUT4 i1_2_lut_adj_167 (.A(REUA[6]), .B(IncREUA), .Z(n11)) /* synthesis lut_function=(A (B)) */ ;
    defparam i1_2_lut_adj_167.init = 16'h8888;
    CCU2D Length_15__I_0_833_add_2_9 (.A0(Length[15]), .B0(GND_net), .C0(GND_net), 
          .D0(GND_net), .A1(GND_net), .B1(GND_net), .C1(GND_net), .D1(GND_net), 
          .CIN(n2914), .S0(Length_15__N_396[7]));   // c:/users/garre/repos/gw4302/cpld/reg.v(215[19:37])
    defparam Length_15__I_0_833_add_2_9.INIT0 = 16'h5555;
    defparam Length_15__I_0_833_add_2_9.INIT1 = 16'h0000;
    defparam Length_15__I_0_833_add_2_9.INJECT1_0 = "NO";
    defparam Length_15__I_0_833_add_2_9.INJECT1_1 = "NO";
    LUT4 mux_755_i3_3_lut_4_lut (.A(n3624), .B(n3637), .C(LengthWritten[10]), 
         .D(Length_15__N_396[2]), .Z(n928[2])) /* synthesis lut_function=(A (C)+!A (B (C)+!B (D))) */ ;   // c:/users/garre/repos/gw4302/cpld/reg.v(212[15:50])
    defparam mux_755_i3_3_lut_4_lut.init = 16'hf1e0;
    LUT4 i2_2_lut_adj_168 (.A(REUA[5]), .B(REUA[4]), .Z(n12)) /* synthesis lut_function=(A (B)) */ ;
    defparam i2_2_lut_adj_168.init = 16'h8888;
    FD1P3IX DF01Reserved32__i3 (.D(D_out_3), .SP(PHI2_N_571_enable_76), 
            .CD(n3914), .CK(PHI2_N_571), .Q(DF01Reserved32[3])) /* synthesis LSE_LINE_FILE_ID=6, LSE_LCOL=9, LSE_RCOL=62, LSE_LLINE=67, LSE_RLINE=76 */ ;   // c:/users/garre/repos/gw4302/cpld/reg.v(96[8] 115[4])
    defparam DF01Reserved32__i3.GSR = "ENABLED";
    FD1P3IX IncMode__i1 (.D(D_out_7), .SP(PHI2_N_571_enable_77), .CD(RegReset), 
            .CK(PHI2_N_571), .Q(IncMode[1])) /* synthesis LSE_LINE_FILE_ID=6, LSE_LCOL=9, LSE_RCOL=62, LSE_LLINE=67, LSE_RLINE=76 */ ;   // c:/users/garre/repos/gw4302/cpld/reg.v(234[8] 237[4])
    defparam IncMode__i1.GSR = "ENABLED";
    L6MUX21 i3098 (.D0(n3312), .D1(n3620), .SD(A_out_2), .Z(n3314));
    LUT4 mux_754_i7_3_lut_4_lut (.A(n3624), .B(n3632), .C(LengthWritten[6]), 
         .D(Length_7__N_443[6]), .Z(n927[6])) /* synthesis lut_function=(A (C)+!A (B (D)+!B (C))) */ ;   // c:/users/garre/repos/gw4302/cpld/reg.v(199[15:50])
    defparam mux_754_i7_3_lut_4_lut.init = 16'hf4b0;
    LUT4 i1_2_lut_rep_85 (.A(A_out_2), .B(A_out_4), .Z(n3650)) /* synthesis lut_function=(A+(B)) */ ;   // c:/users/garre/repos/gw4302/cpld/reg.v(76[2:14])
    defparam i1_2_lut_rep_85.init = 16'heeee;
    CCU2D Length_15__I_0_833_add_2_7 (.A0(Length[13]), .B0(GND_net), .C0(GND_net), 
          .D0(GND_net), .A1(Length[14]), .B1(GND_net), .C1(GND_net), 
          .D1(GND_net), .CIN(n2913), .COUT(n2914), .S0(Length_15__N_396[5]), 
          .S1(Length_15__N_396[6]));   // c:/users/garre/repos/gw4302/cpld/reg.v(215[19:37])
    defparam Length_15__I_0_833_add_2_7.INIT0 = 16'h5555;
    defparam Length_15__I_0_833_add_2_7.INIT1 = 16'h5555;
    defparam Length_15__I_0_833_add_2_7.INJECT1_0 = "NO";
    defparam Length_15__I_0_833_add_2_7.INJECT1_1 = "NO";
    L6MUX21 i3236 (.D0(n3480), .D1(n3477), .SD(A_out_3), .Z(n3481));
    LUT4 i1_2_lut_rep_77_3_lut (.A(A_out_2), .B(A_out_4), .C(A_out_3), 
         .Z(n3642)) /* synthesis lut_function=(A+(B+(C))) */ ;   // c:/users/garre/repos/gw4302/cpld/reg.v(76[2:14])
    defparam i1_2_lut_rep_77_3_lut.init = 16'hfefe;
    LUT4 mux_755_i4_3_lut_4_lut (.A(n3624), .B(n3637), .C(LengthWritten[11]), 
         .D(Length_15__N_396[3]), .Z(n928[3])) /* synthesis lut_function=(A (C)+!A (B (C)+!B (D))) */ ;   // c:/users/garre/repos/gw4302/cpld/reg.v(212[15:50])
    defparam mux_755_i4_3_lut_4_lut.init = 16'hf1e0;
    LUT4 i3060_2_lut_3_lut (.A(A_out_2), .B(A_out_4), .C(n7), .Z(n3276)) /* synthesis lut_function=(A+(B+(C))) */ ;   // c:/users/garre/repos/gw4302/cpld/reg.v(76[2:14])
    defparam i3060_2_lut_3_lut.init = 16'hfefe;
    LUT4 mux_173_i2_4_lut (.A(REUA[17]), .B(REUAWritten[17]), .C(n3624), 
         .D(n3623), .Z(n303[1])) /* synthesis lut_function=(A (B (C+!(D))+!B !(C+(D)))+!A (B (C+(D))+!B !(C+!(D)))) */ ;   // c:/users/garre/repos/gw4302/cpld/reg.v(187[18:34])
    defparam mux_173_i2_4_lut.init = 16'hc5ca;
    LUT4 i9_4_lut (.A(n17), .B(n15_adj_667), .C(n11), .D(n12), .Z(REUAOut_15__N_147)) /* synthesis lut_function=(A (B (C (D)))) */ ;
    defparam i9_4_lut.init = 16'h8000;
    LUT4 i3_4_lut_adj_169 (.A(n15_adj_668), .B(n6), .C(n3912), .D(n3286), 
         .Z(PHI2_N_571_enable_86)) /* synthesis lut_function=(A (B+(C+!(D)))+!A (B+(C))) */ ;
    defparam i3_4_lut_adj_169.init = 16'hfcfe;
    LUT4 i6_4_lut_adj_170 (.A(n1370), .B(Length[6]), .C(Length[4]), .D(Length[5]), 
         .Z(n15_adj_668)) /* synthesis lut_function=(!((B+(C+(D)))+!A)) */ ;
    defparam i6_4_lut_adj_170.init = 16'h0002;
    LUT4 A_4__I_0_i6_2_lut_rep_86 (.A(A_out_0), .B(A_out_1), .Z(n3651)) /* synthesis lut_function=((B)+!A) */ ;   // c:/users/garre/repos/gw4302/cpld/reg.v(76[2:14])
    defparam A_4__I_0_i6_2_lut_rep_86.init = 16'hdddd;
    LUT4 i498_3_lut_4_lut (.A(A_out_0), .B(A_out_1), .C(n3640), .D(n3912), 
         .Z(PHI2_N_571_enable_42)) /* synthesis lut_function=(A (B (D)+!B ((D)+!C))+!A (D)) */ ;   // c:/users/garre/repos/gw4302/cpld/reg.v(76[2:14])
    defparam i498_3_lut_4_lut.init = 16'hff02;
    LUT4 mux_174_i8_3_lut_4_lut (.A(n3651), .B(n2252), .C(D_out_7), .D(REUAOut_15__N_146[7]), 
         .Z(n304[7])) /* synthesis lut_function=(A (D)+!A (B (D)+!B (C))) */ ;
    defparam mux_174_i8_3_lut_4_lut.init = 16'hfe10;
    LUT4 i2146_2_lut_rep_68_3_lut (.A(A_out_0), .B(A_out_1), .C(n2252), 
         .Z(n3633)) /* synthesis lut_function=((B+(C))+!A) */ ;   // c:/users/garre/repos/gw4302/cpld/reg.v(76[2:14])
    defparam i2146_2_lut_rep_68_3_lut.init = 16'hfdfd;
    LUT4 i366_2_lut_3_lut_4_lut (.A(A_out_0), .B(A_out_1), .C(n3912), 
         .D(n2252), .Z(PHI2_N_571_enable_67)) /* synthesis lut_function=(A (B (C)+!B (C+!(D)))+!A (C)) */ ;   // c:/users/garre/repos/gw4302/cpld/reg.v(76[2:14])
    defparam i366_2_lut_3_lut_4_lut.init = 16'hf0f2;
    LUT4 mux_173_i1_4_lut (.A(REUA[16]), .B(REUAWritten[16]), .C(n3624), 
         .D(REUAOut_18__N_130), .Z(n303[0])) /* synthesis lut_function=(A (B (C+!(D))+!B !(C+(D)))+!A (B (C+(D))+!B !(C+!(D)))) */ ;   // c:/users/garre/repos/gw4302/cpld/reg.v(187[18:34])
    defparam mux_173_i1_4_lut.init = 16'hc5ca;
    LUT4 i2_4_lut (.A(n3262), .B(n3622), .C(n3643), .D(A_out_3), .Z(n6)) /* synthesis lut_function=(A (B)+!A (B+!(C+!(D)))) */ ;
    defparam i2_4_lut.init = 16'hcdcc;
    LUT4 i3070_4_lut (.A(n3270), .B(Length[1]), .C(Length[3]), .D(Length[0]), 
         .Z(n3286)) /* synthesis lut_function=(A+(B+(C+(D)))) */ ;
    defparam i3070_4_lut.init = 16'hfffe;
    LUT4 mux_198_i6_3_lut (.A(REUA[5]), .B(REUA[13]), .C(A_out_0), .Z(n352[5])) /* synthesis lut_function=(A (B+!(C))+!A (B (C))) */ ;   // c:/users/garre/repos/gw4302/cpld/reg.v(67[2] 78[7])
    defparam mux_198_i6_3_lut.init = 16'hcaca;
    LUT4 i4_2_lut_2_lut (.A(A_out_0), .B(A_out_13), .Z(n22)) /* synthesis lut_function=(!(A+!(B))) */ ;
    defparam i4_2_lut_2_lut.init = 16'h4444;
    LUT4 i3_4_lut_adj_171 (.A(n1370), .B(PHI2_N_571_enable_73), .C(n3621), 
         .D(Length1_N_645), .Z(PHI2_N_571_enable_75)) /* synthesis lut_function=(A (B+(C+!(D)))+!A (B+(C))) */ ;
    defparam i3_4_lut_adj_171.init = 16'hfcfe;
    FD1S3IX XferType__i1 (.D(n3629), .CK(PHI2_N_571), .CD(RegReset), .Q(XferType[1])) /* synthesis LSE_LINE_FILE_ID=6, LSE_LCOL=9, LSE_RCOL=62, LSE_LLINE=67, LSE_RLINE=76 */ ;   // c:/users/garre/repos/gw4302/cpld/reg.v(96[8] 115[4])
    defparam XferType__i1.GSR = "ENABLED";
    PFUMX i3234 (.BLUT(n3479), .ALUT(n3478), .C0(A_out_2), .Z(n3480));
    LUT4 i3143_3_lut_4_lut_4_lut (.A(A_out_0), .B(n409[4]), .C(A_out_3), 
         .D(Length[4]), .Z(n3301)) /* synthesis lut_function=(A (B (C+(D))+!B !(C+!(D)))+!A (B+!(C))) */ ;
    defparam i3143_3_lut_4_lut_4_lut.init = 16'hcfc5;
    PFUMX i3408 (.BLUT(n3812), .ALUT(n3808), .C0(A_out_3), .Z(n3813));
    CCU2D Length_15__I_0_833_add_2_5 (.A0(Length[11]), .B0(GND_net), .C0(GND_net), 
          .D0(GND_net), .A1(Length[12]), .B1(GND_net), .C1(GND_net), 
          .D1(GND_net), .CIN(n2912), .COUT(n2913), .S0(Length_15__N_396[3]), 
          .S1(Length_15__N_396[4]));   // c:/users/garre/repos/gw4302/cpld/reg.v(215[19:37])
    defparam Length_15__I_0_833_add_2_5.INIT0 = 16'h5555;
    defparam Length_15__I_0_833_add_2_5.INIT1 = 16'h5555;
    defparam Length_15__I_0_833_add_2_5.INJECT1_0 = "NO";
    defparam Length_15__I_0_833_add_2_5.INJECT1_1 = "NO";
    LUT4 mux_198_i5_3_lut (.A(REUA[4]), .B(REUA[12]), .C(A_out_0), .Z(n352[4])) /* synthesis lut_function=(A (B+!(C))+!A (B (C))) */ ;   // c:/users/garre/repos/gw4302/cpld/reg.v(67[2] 78[7])
    defparam mux_198_i5_3_lut.init = 16'hcaca;
    LUT4 Length_7__bdd_4_lut_4_lut (.A(A_out_0), .B(A_out_1), .C(n352[7]), 
         .D(Length[7]), .Z(n3620)) /* synthesis lut_function=(A (B (D)+!B (C))+!A (B+(C))) */ ;
    defparam Length_7__bdd_4_lut_4_lut.init = 16'hfc74;
    LUT4 i3054_2_lut (.A(Length[2]), .B(Length[7]), .Z(n3270)) /* synthesis lut_function=(A+(B)) */ ;
    defparam i3054_2_lut.init = 16'heeee;
    LUT4 mux_198_i4_3_lut (.A(REUA[3]), .B(REUA[11]), .C(A_out_0), .Z(n352[3])) /* synthesis lut_function=(A (B+!(C))+!A (B (C))) */ ;   // c:/users/garre/repos/gw4302/cpld/reg.v(67[2] 78[7])
    defparam mux_198_i4_3_lut.init = 16'hcaca;
    LUT4 n360_bdd_3_lut_3277_4_lut (.A(A_out_3), .B(A_out_1), .C(n364[0]), 
         .D(n352[0]), .Z(n3484)) /* synthesis lut_function=(A (C)+!A (B (C)+!B (D))) */ ;
    defparam n360_bdd_3_lut_3277_4_lut.init = 16'hf1e0;
    LUT4 A_4__I_0_733_i6_2_lut_rep_90 (.A(A_out_0), .B(A_out_1), .Z(n3655)) /* synthesis lut_function=(A+!(B)) */ ;   // c:/users/garre/repos/gw4302/cpld/reg.v(69[2:14])
    defparam A_4__I_0_733_i6_2_lut_rep_90.init = 16'hbbbb;
    LUT4 mux_198_i7_3_lut (.A(REUA[6]), .B(REUA[14]), .C(A_out_0), .Z(n352[6])) /* synthesis lut_function=(A (B+!(C))+!A (B (C))) */ ;   // c:/users/garre/repos/gw4302/cpld/reg.v(67[2] 78[7])
    defparam mux_198_i7_3_lut.init = 16'hcaca;
    LUT4 i2104_2_lut (.A(D_out_5), .B(n3912), .Z(n1218)) /* synthesis lut_function=(A+(B)) */ ;   // c:/users/garre/repos/gw4302/cpld/reg.v(205[8] 217[4])
    defparam i2104_2_lut.init = 16'heeee;
    LUT4 i3210_then_4_lut (.A(CA[2]), .B(A_out_3), .C(A_out_2), .D(REUA[18]), 
         .Z(n3673)) /* synthesis lut_function=(A (B+((D)+!C))+!A (B+(C (D)))) */ ;
    defparam i3210_then_4_lut.init = 16'hfece;
    LUT4 mux_754_i1_3_lut_4_lut (.A(n3624), .B(n3632), .C(LengthWritten[0]), 
         .D(Length_7__N_443[0]), .Z(n927[0])) /* synthesis lut_function=(A (C)+!A (B (D)+!B (C))) */ ;   // c:/users/garre/repos/gw4302/cpld/reg.v(199[15:50])
    defparam mux_754_i1_3_lut_4_lut.init = 16'hf4b0;
    LUT4 i505_3_lut_4_lut (.A(A_out_0), .B(A_out_1), .C(n3640), .D(n3912), 
         .Z(PHI2_N_571_enable_77)) /* synthesis lut_function=(A (D)+!A (B ((D)+!C)+!B (D))) */ ;   // c:/users/garre/repos/gw4302/cpld/reg.v(69[2:14])
    defparam i505_3_lut_4_lut.init = 16'hff04;
    LUT4 i3210_else_4_lut (.A(Length[10]), .B(A_out_3), .C(A_out_2), .D(REUA[2]), 
         .Z(n3672)) /* synthesis lut_function=(A (B+(C (D)))+!A !(B+!(C (D)))) */ ;
    defparam i3210_else_4_lut.init = 16'hb888;
    LUT4 i398_2_lut_3_lut_4_lut (.A(A_out_0), .B(A_out_1), .C(n3912), 
         .D(n2252), .Z(PHI2_N_571_enable_74)) /* synthesis lut_function=(A (C)+!A (B (C+!(D))+!B (C))) */ ;   // c:/users/garre/repos/gw4302/cpld/reg.v(69[2:14])
    defparam i398_2_lut_3_lut_4_lut.init = 16'hf0f4;
    LUT4 i2069_2_lut_rep_91 (.A(A_out_1), .B(A_out_0), .Z(n3656)) /* synthesis lut_function=(A (B)) */ ;
    defparam i2069_2_lut_rep_91.init = 16'h8888;
    LUT4 i3141_3_lut_4_lut_4_lut (.A(A_out_0), .B(n409[5]), .C(A_out_3), 
         .D(Length[5]), .Z(n3304)) /* synthesis lut_function=(A (B (C+(D))+!B !(C+!(D)))+!A (B+!(C))) */ ;
    defparam i3141_3_lut_4_lut_4_lut.init = 16'hcfc5;
    LUT4 i3145_3_lut_4_lut_4_lut (.A(A_out_0), .B(n409[3]), .C(A_out_3), 
         .D(Length[3]), .Z(n3298)) /* synthesis lut_function=(A (B (C+(D))+!B !(C+!(D)))+!A (B+!(C))) */ ;
    defparam i3145_3_lut_4_lut_4_lut.init = 16'hcfc5;
    FD1P3JX Length_8__684 (.D(Length_8__N_435), .SP(PHI2_N_571_enable_86), 
            .PD(n3913), .CK(PHI2_N_571), .Q(Length[8])) /* synthesis LSE_LINE_FILE_ID=6, LSE_LCOL=9, LSE_RCOL=62, LSE_LLINE=67, LSE_RLINE=76 */ ;   // c:/users/garre/repos/gw4302/cpld/reg.v(205[8] 217[4])
    defparam Length_8__684.GSR = "ENABLED";
    FD1P3JX Length_9__683 (.D(Length_9__N_430), .SP(PHI2_N_571_enable_86), 
            .PD(n3914), .CK(PHI2_N_571), .Q(Length[9])) /* synthesis LSE_LINE_FILE_ID=6, LSE_LCOL=9, LSE_RCOL=62, LSE_LLINE=67, LSE_RLINE=76 */ ;   // c:/users/garre/repos/gw4302/cpld/reg.v(205[8] 217[4])
    defparam Length_9__683.GSR = "ENABLED";
    FD1P3JX Length_10__682 (.D(Length_10__N_425), .SP(PHI2_N_571_enable_86), 
            .PD(n3914), .CK(PHI2_N_571), .Q(Length[10])) /* synthesis LSE_LINE_FILE_ID=6, LSE_LCOL=9, LSE_RCOL=62, LSE_LLINE=67, LSE_RLINE=76 */ ;   // c:/users/garre/repos/gw4302/cpld/reg.v(205[8] 217[4])
    defparam Length_10__682.GSR = "ENABLED";
    FD1P3JX Length_11__681 (.D(Length_11__N_420), .SP(PHI2_N_571_enable_86), 
            .PD(n3913), .CK(PHI2_N_571), .Q(Length[11])) /* synthesis LSE_LINE_FILE_ID=6, LSE_LCOL=9, LSE_RCOL=62, LSE_LLINE=67, LSE_RLINE=76 */ ;   // c:/users/garre/repos/gw4302/cpld/reg.v(205[8] 217[4])
    defparam Length_11__681.GSR = "ENABLED";
    FD1P3JX Length_12__680 (.D(Length_12__N_415), .SP(PHI2_N_571_enable_86), 
            .PD(n3914), .CK(PHI2_N_571), .Q(Length[12])) /* synthesis LSE_LINE_FILE_ID=6, LSE_LCOL=9, LSE_RCOL=62, LSE_LLINE=67, LSE_RLINE=76 */ ;   // c:/users/garre/repos/gw4302/cpld/reg.v(205[8] 217[4])
    defparam Length_12__680.GSR = "ENABLED";
    FD1P3JX Length_13__679 (.D(Length_13__N_410), .SP(PHI2_N_571_enable_86), 
            .PD(n3913), .CK(PHI2_N_571), .Q(Length[13])) /* synthesis LSE_LINE_FILE_ID=6, LSE_LCOL=9, LSE_RCOL=62, LSE_LLINE=67, LSE_RLINE=76 */ ;   // c:/users/garre/repos/gw4302/cpld/reg.v(205[8] 217[4])
    defparam Length_13__679.GSR = "ENABLED";
    FD1P3JX Length_14__678 (.D(Length_14__N_405), .SP(PHI2_N_571_enable_86), 
            .PD(n3914), .CK(PHI2_N_571), .Q(Length[14])) /* synthesis LSE_LINE_FILE_ID=6, LSE_LCOL=9, LSE_RCOL=62, LSE_LLINE=67, LSE_RLINE=76 */ ;   // c:/users/garre/repos/gw4302/cpld/reg.v(205[8] 217[4])
    defparam Length_14__678.GSR = "ENABLED";
    FD1P3JX Length_15__677 (.D(Length_15__N_393), .SP(PHI2_N_571_enable_86), 
            .PD(n3913), .CK(PHI2_N_571), .Q(Length[15])) /* synthesis LSE_LINE_FILE_ID=6, LSE_LCOL=9, LSE_RCOL=62, LSE_LLINE=67, LSE_RLINE=76 */ ;   // c:/users/garre/repos/gw4302/cpld/reg.v(205[8] 217[4])
    defparam Length_15__677.GSR = "ENABLED";
    LUT4 i1_2_lut_rep_72_3_lut (.A(A_out_1), .B(A_out_0), .C(n2252), .Z(n3637)) /* synthesis lut_function=(!(((C)+!B)+!A)) */ ;
    defparam i1_2_lut_rep_72_3_lut.init = 16'h0808;
    LUT4 mux_198_i2_3_lut (.A(REUA[1]), .B(REUA[9]), .C(A_out_0), .Z(n352[1])) /* synthesis lut_function=(A (B+!(C))+!A (B (C))) */ ;   // c:/users/garre/repos/gw4302/cpld/reg.v(67[2] 78[7])
    defparam mux_198_i2_3_lut.init = 16'hcaca;
    LUT4 mux_174_i7_3_lut_4_lut (.A(n3651), .B(n2252), .C(D_out_6), .D(REUAOut_15__N_146[6]), 
         .Z(n304[6])) /* synthesis lut_function=(A (D)+!A (B (D)+!B (C))) */ ;
    defparam mux_174_i7_3_lut_4_lut.init = 16'hfe10;
    LUT4 mux_755_i5_3_lut_4_lut (.A(n3624), .B(n3637), .C(LengthWritten[12]), 
         .D(Length_15__N_396[4]), .Z(n928[4])) /* synthesis lut_function=(A (C)+!A (B (C)+!B (D))) */ ;   // c:/users/garre/repos/gw4302/cpld/reg.v(212[15:50])
    defparam mux_755_i5_3_lut_4_lut.init = 16'hf1e0;
    LUT4 i2106_2_lut (.A(D_out_6), .B(n3912), .Z(n1216)) /* synthesis lut_function=(A+(B)) */ ;   // c:/users/garre/repos/gw4302/cpld/reg.v(205[8] 217[4])
    defparam i2106_2_lut.init = 16'heeee;
    LUT4 mux_198_i1_3_lut (.A(REUA[0]), .B(REUA[8]), .C(A_out_0), .Z(n352[0])) /* synthesis lut_function=(A (B+!(C))+!A (B (C))) */ ;   // c:/users/garre/repos/gw4302/cpld/reg.v(67[2] 78[7])
    defparam mux_198_i1_3_lut.init = 16'hcaca;
    CCU2D REUAOut_7__I_0_9 (.A0(GND_net), .B0(REUAOut_7__N_194), .C0(REUAWritten[6]), 
          .D0(REUA[6]), .A1(GND_net), .B1(REUAOut_7__N_194), .C1(REUAWritten[7]), 
          .D1(REUA[7]), .CIN(n2901), .S0(REUAOut_7__N_193[6]), .S1(REUAOut_7__N_193[7]));   // c:/users/garre/repos/gw4302/cpld/reg.v(160[16:31])
    defparam REUAOut_7__I_0_9.INIT0 = 16'h596a;
    defparam REUAOut_7__I_0_9.INIT1 = 16'h596a;
    defparam REUAOut_7__I_0_9.INJECT1_0 = "NO";
    defparam REUAOut_7__I_0_9.INJECT1_1 = "NO";
    CCU2D REUAOut_7__I_0_7 (.A0(GND_net), .B0(REUAOut_7__N_194), .C0(REUAWritten[4]), 
          .D0(REUA[4]), .A1(GND_net), .B1(REUAOut_7__N_194), .C1(REUAWritten[5]), 
          .D1(REUA[5]), .CIN(n2900), .COUT(n2901), .S0(REUAOut_7__N_193[4]), 
          .S1(REUAOut_7__N_193[5]));   // c:/users/garre/repos/gw4302/cpld/reg.v(160[16:31])
    defparam REUAOut_7__I_0_7.INIT0 = 16'h596a;
    defparam REUAOut_7__I_0_7.INIT1 = 16'h596a;
    defparam REUAOut_7__I_0_7.INJECT1_0 = "NO";
    defparam REUAOut_7__I_0_7.INJECT1_1 = "NO";
    CCU2D REUAOut_7__I_0_5 (.A0(GND_net), .B0(REUAOut_7__N_194), .C0(REUAWritten[2]), 
          .D0(REUA[2]), .A1(GND_net), .B1(REUAOut_7__N_194), .C1(REUAWritten[3]), 
          .D1(REUA[3]), .CIN(n2899), .COUT(n2900), .S0(REUAOut_7__N_193[2]), 
          .S1(REUAOut_7__N_193[3]));   // c:/users/garre/repos/gw4302/cpld/reg.v(160[16:31])
    defparam REUAOut_7__I_0_5.INIT0 = 16'h596a;
    defparam REUAOut_7__I_0_5.INIT1 = 16'h596a;
    defparam REUAOut_7__I_0_5.INJECT1_0 = "NO";
    defparam REUAOut_7__I_0_5.INJECT1_1 = "NO";
    CCU2D REUAOut_7__I_0_3 (.A0(IncREUAg), .B0(REUAOut_7__N_194), .C0(REUAWritten[0]), 
          .D0(REUA[0]), .A1(GND_net), .B1(REUAOut_7__N_194), .C1(REUAWritten[1]), 
          .D1(REUA[1]), .CIN(n2898), .COUT(n2899), .S0(REUAOut_7__N_193[0]), 
          .S1(REUAOut_7__N_193[1]));   // c:/users/garre/repos/gw4302/cpld/reg.v(160[16:31])
    defparam REUAOut_7__I_0_3.INIT0 = 16'hd1e2;
    defparam REUAOut_7__I_0_3.INIT1 = 16'h596a;
    defparam REUAOut_7__I_0_3.INJECT1_0 = "NO";
    defparam REUAOut_7__I_0_3.INJECT1_1 = "NO";
    CCU2D REUAOut_7__I_0_1 (.A0(GND_net), .B0(GND_net), .C0(GND_net), 
          .D0(GND_net), .A1(n3624), .B1(n3633), .C1(GND_net), .D1(GND_net), 
          .COUT(n2898));   // c:/users/garre/repos/gw4302/cpld/reg.v(160[16:31])
    defparam REUAOut_7__I_0_1.INIT0 = 16'hF000;
    defparam REUAOut_7__I_0_1.INIT1 = 16'hffff;
    defparam REUAOut_7__I_0_1.INJECT1_0 = "NO";
    defparam REUAOut_7__I_0_1.INJECT1_1 = "NO";
    CCU2D CAOut_15__I_0_9 (.A0(GND_net), .B0(CAOut_15__N_237), .C0(CAWritten[14]), 
          .D0(CA[14]), .A1(GND_net), .B1(CAOut_15__N_237), .C1(CAWritten[15]), 
          .D1(CA[15]), .CIN(n2893), .S0(CAOut_15__N_234[6]), .S1(CAOut_15__N_234[7]));   // c:/users/garre/repos/gw4302/cpld/reg.v(145[15:29])
    defparam CAOut_15__I_0_9.INIT0 = 16'h596a;
    defparam CAOut_15__I_0_9.INIT1 = 16'h596a;
    defparam CAOut_15__I_0_9.INJECT1_0 = "NO";
    defparam CAOut_15__I_0_9.INJECT1_1 = "NO";
    CCU2D CAOut_15__I_0_7 (.A0(GND_net), .B0(CAOut_15__N_237), .C0(CAWritten[12]), 
          .D0(CA[12]), .A1(GND_net), .B1(CAOut_15__N_237), .C1(CAWritten[13]), 
          .D1(CA[13]), .CIN(n2892), .COUT(n2893), .S0(CAOut_15__N_234[4]), 
          .S1(CAOut_15__N_234[5]));   // c:/users/garre/repos/gw4302/cpld/reg.v(145[15:29])
    defparam CAOut_15__I_0_7.INIT0 = 16'h596a;
    defparam CAOut_15__I_0_7.INIT1 = 16'h596a;
    defparam CAOut_15__I_0_7.INJECT1_0 = "NO";
    defparam CAOut_15__I_0_7.INJECT1_1 = "NO";
    CCU2D CAOut_15__I_0_5 (.A0(GND_net), .B0(CAOut_15__N_237), .C0(CAWritten[10]), 
          .D0(CA[10]), .A1(GND_net), .B1(CAOut_15__N_237), .C1(CAWritten[11]), 
          .D1(CA[11]), .CIN(n2891), .COUT(n2892), .S0(CAOut_15__N_234[2]), 
          .S1(CAOut_15__N_234[3]));   // c:/users/garre/repos/gw4302/cpld/reg.v(145[15:29])
    defparam CAOut_15__I_0_5.INIT0 = 16'h596a;
    defparam CAOut_15__I_0_5.INIT1 = 16'h596a;
    defparam CAOut_15__I_0_5.INJECT1_0 = "NO";
    defparam CAOut_15__I_0_5.INJECT1_1 = "NO";
    CCU2D CAOut_15__I_0_3 (.A0(CAOut_15__N_235), .B0(CAOut_15__N_237), .C0(CAWritten[8]), 
          .D0(CA[8]), .A1(GND_net), .B1(CAOut_15__N_237), .C1(CAWritten[9]), 
          .D1(CA[9]), .CIN(n2890), .COUT(n2891), .S0(CAOut_15__N_234[0]), 
          .S1(CAOut_15__N_234[1]));   // c:/users/garre/repos/gw4302/cpld/reg.v(145[15:29])
    defparam CAOut_15__I_0_3.INIT0 = 16'hd1e2;
    defparam CAOut_15__I_0_3.INIT1 = 16'h596a;
    defparam CAOut_15__I_0_3.INJECT1_0 = "NO";
    defparam CAOut_15__I_0_3.INJECT1_1 = "NO";
    CCU2D CAOut_15__I_0_1 (.A0(GND_net), .B0(GND_net), .C0(GND_net), .D0(GND_net), 
          .A1(n3624), .B1(n3634), .C1(GND_net), .D1(GND_net), .COUT(n2890));   // c:/users/garre/repos/gw4302/cpld/reg.v(145[15:29])
    defparam CAOut_15__I_0_1.INIT0 = 16'hF000;
    defparam CAOut_15__I_0_1.INIT1 = 16'hffff;
    defparam CAOut_15__I_0_1.INJECT1_0 = "NO";
    defparam CAOut_15__I_0_1.INJECT1_1 = "NO";
    LUT4 i2108_2_lut (.A(D_out_7), .B(n3912), .Z(n1214)) /* synthesis lut_function=(A+(B)) */ ;   // c:/users/garre/repos/gw4302/cpld/reg.v(205[8] 217[4])
    defparam i2108_2_lut.init = 16'heeee;
    LUT4 i1_2_lut_3_lut_4_lut_adj_172 (.A(A_out_1), .B(A_out_0), .C(n3912), 
         .D(n2252), .Z(PHI2_N_571_enable_73)) /* synthesis lut_function=(A (B (C+!(D))+!B (C))+!A (C)) */ ;
    defparam i1_2_lut_3_lut_4_lut_adj_172.init = 16'hf0f8;
    CCU2D CAOut_7__I_0_9 (.A0(GND_net), .B0(CAOut_7__N_282), .C0(CAWritten[6]), 
          .D0(CA[6]), .A1(GND_net), .B1(CAOut_7__N_282), .C1(CAWritten[7]), 
          .D1(CA[7]), .CIN(n2885), .S0(CAOut_7__N_281[6]), .S1(CAOut_7__N_281[7]));   // c:/users/garre/repos/gw4302/cpld/reg.v(132[14:27])
    defparam CAOut_7__I_0_9.INIT0 = 16'h596a;
    defparam CAOut_7__I_0_9.INIT1 = 16'h596a;
    defparam CAOut_7__I_0_9.INJECT1_0 = "NO";
    defparam CAOut_7__I_0_9.INJECT1_1 = "NO";
    CCU2D CAOut_7__I_0_7 (.A0(GND_net), .B0(CAOut_7__N_282), .C0(CAWritten[4]), 
          .D0(CA[4]), .A1(GND_net), .B1(CAOut_7__N_282), .C1(CAWritten[5]), 
          .D1(CA[5]), .CIN(n2884), .COUT(n2885), .S0(CAOut_7__N_281[4]), 
          .S1(CAOut_7__N_281[5]));   // c:/users/garre/repos/gw4302/cpld/reg.v(132[14:27])
    defparam CAOut_7__I_0_7.INIT0 = 16'h596a;
    defparam CAOut_7__I_0_7.INIT1 = 16'h596a;
    defparam CAOut_7__I_0_7.INJECT1_0 = "NO";
    defparam CAOut_7__I_0_7.INJECT1_1 = "NO";
    CCU2D CAOut_7__I_0_5 (.A0(GND_net), .B0(CAOut_7__N_282), .C0(CAWritten[2]), 
          .D0(CA[2]), .A1(GND_net), .B1(CAOut_7__N_282), .C1(CAWritten[3]), 
          .D1(CA[3]), .CIN(n2883), .COUT(n2884), .S0(CAOut_7__N_281[2]), 
          .S1(CAOut_7__N_281[3]));   // c:/users/garre/repos/gw4302/cpld/reg.v(132[14:27])
    defparam CAOut_7__I_0_5.INIT0 = 16'h596a;
    defparam CAOut_7__I_0_5.INIT1 = 16'h596a;
    defparam CAOut_7__I_0_5.INJECT1_0 = "NO";
    defparam CAOut_7__I_0_5.INJECT1_1 = "NO";
    CCU2D CAOut_7__I_0_3 (.A0(IncCAg), .B0(CAOut_7__N_282), .C0(CAWritten[0]), 
          .D0(CA[0]), .A1(GND_net), .B1(CAOut_7__N_282), .C1(CAWritten[1]), 
          .D1(CA[1]), .CIN(n2882), .COUT(n2883), .S0(CAOut_7__N_281[0]), 
          .S1(CAOut_7__N_281[1]));   // c:/users/garre/repos/gw4302/cpld/reg.v(132[14:27])
    defparam CAOut_7__I_0_3.INIT0 = 16'hd1e2;
    defparam CAOut_7__I_0_3.INIT1 = 16'h596a;
    defparam CAOut_7__I_0_3.INJECT1_0 = "NO";
    defparam CAOut_7__I_0_3.INJECT1_1 = "NO";
    CCU2D Length_7__I_0_add_2_1 (.A0(GND_net), .B0(GND_net), .C0(GND_net), 
          .D0(GND_net), .A1(Length[0]), .B1(GND_net), .C1(GND_net), 
          .D1(GND_net), .COUT(n2875), .S1(Length_7__N_443[0]));   // c:/users/garre/repos/gw4302/cpld/reg.v(202[18:35])
    defparam Length_7__I_0_add_2_1.INIT0 = 16'hF000;
    defparam Length_7__I_0_add_2_1.INIT1 = 16'h5555;
    defparam Length_7__I_0_add_2_1.INJECT1_0 = "NO";
    defparam Length_7__I_0_add_2_1.INJECT1_1 = "NO";
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
