garrettsworkshop/GW4302/(commit log)

2022-01-15 As submitted to JLC
    [GW4302-BOM.csv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]
2022-01-18 Starting on DMA sequencer
2022-01-18 More DMA sequencer control
2022-01-18 Update GW4302.sch
    Change from 'LVC to 'AHC for non-edge triggered signal buffering
    [GW4302.sch]
2022-01-18 Simplified DMA sequencer logic
2022-01-19 Fix indices in Reg.v
    [Reg.v]
2022-01-19 Fix JTAG connections on board
    [GW4302.kicad_pcb, GW4302.sch]
2022-02-01 Migrate to KiCAD 6
    [Docs.sch, GW4302.kicad_pcb, GW4302.kicad_sch, GW4302.sch]
2022-04-23 Disable DMA engine
2022-04-25 RAM bugfixes
    Replace PLLLock with PORDone. PORDone activation is not dependent on S[2:0].
    Don't increment S[2:0] until PORDone.
    Change RAM command issue table accordingly.
    [RAM.v]
2022-04-26 Update DMASeq.v
    Fix verify increment after not equal
    [DMASeq.v]
2022-04-26 Fix non-verify stop bug
    [DMASeq.v, REU_prim.v, Reg.v]
2022-04-28 Cut down thought for macrocell-based PLDs
    [REU_pad.csv]
2022-04-28 Removed macrocell PLD stuff
    [REU_pad.csv]
2022-09-18 Add pull-up resistors on AOE, DOE, IRQOE, RESOE
    [GW4302.kicad_pcb, GW4302.kicad_sch]
2022-09-19 Switch to 3225 crystal for USB
    [GW4302.kicad_pcb, GW4302.kicad_sch]
2023-02-13 Fix board ID
    [GW4302.kicad_pcb, GW4302.kicad_sch]
2023-03-22 Revert "??"
    This reverts commit 2eec9a9f33069042b41c52556303140318240893.
    [GW4302.kicad_pcb]
2024-02-16 As sent to JLC
    [GW4302-B_Cu.gbl, GW4302-B_Mask.gbs, GW4302-B_Silkscreen.gbo, GW4302-Edge_Cuts.gm1, GW4302-F_Cu.gtl, GW4302-F_Mask.gts, GW4302-F_Paste.gtp, GW4302-F_Silkscreen.gto]
2024-03-18 Rebuild to generate BOM but no board changes
    [GW4302-BOM.csv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]
2025-01-10 New version
    [GW4302-BOM.csv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]
